yusufElnady/Medical-Imager/Documentation/UltrasoundMedicalImagerOverview.docx

Ultrasound Medical Imager

Final Dimensions: 10*14 cm²

3D Model

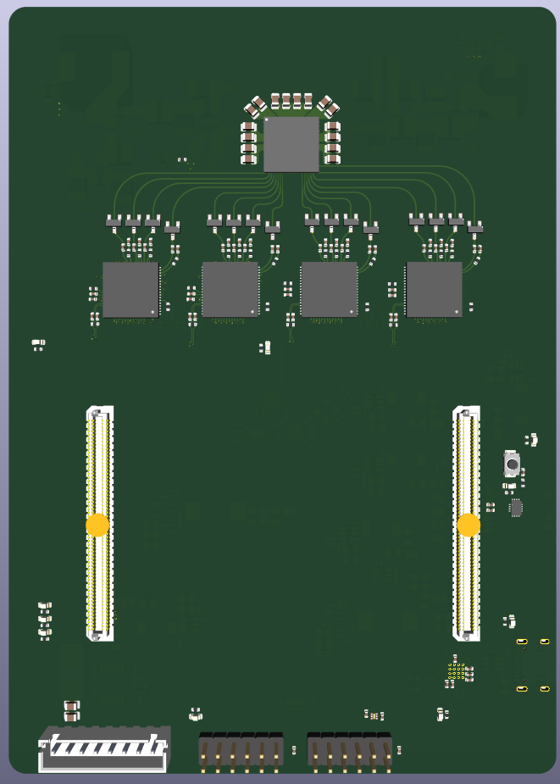
[picture p1: figure]

Figure 1: Top view of the PCB.

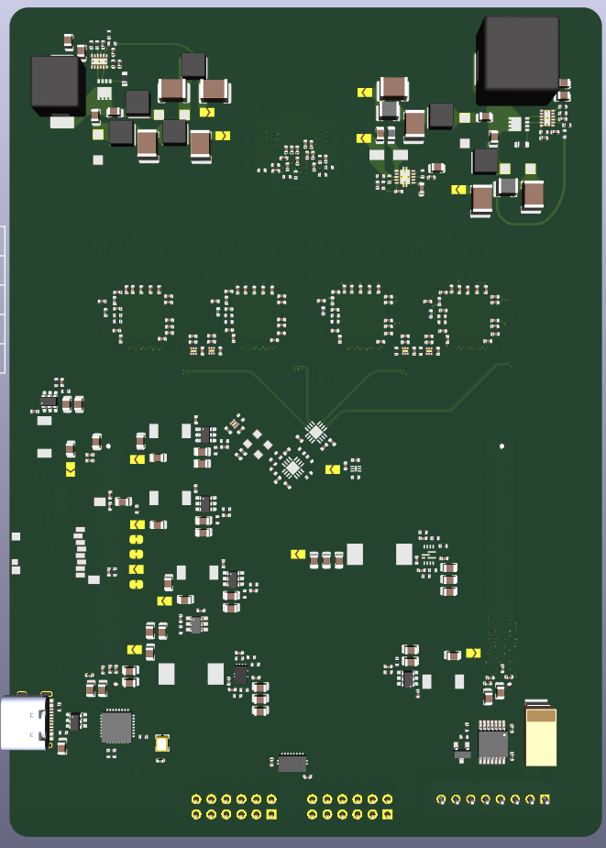
[picture p2: figure]

Figure 2: Bottom view of the PCB.
