yusufElnady/Medical-Imager/Documentation/PCBLayers.odt

Top 3D View

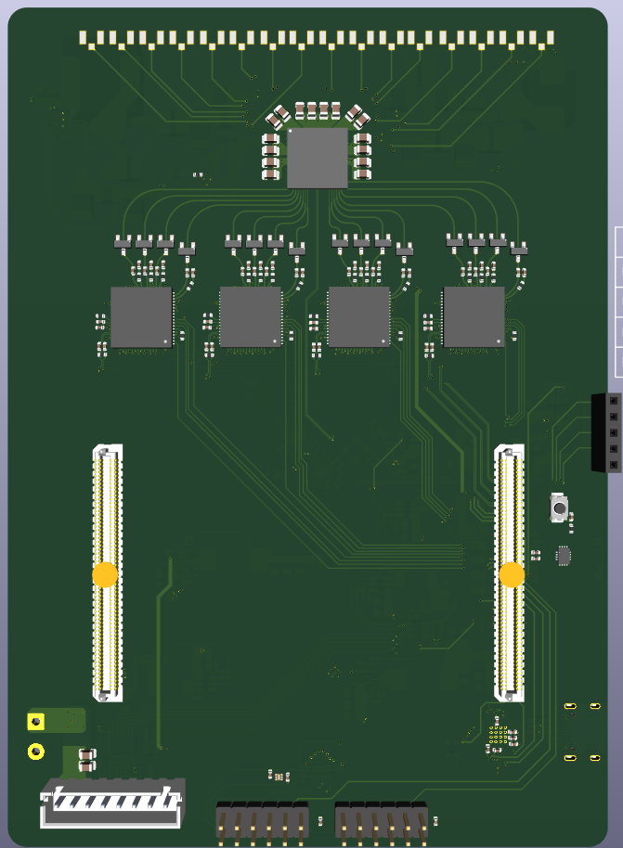
[picture p3: figure]

Bottom 3D View

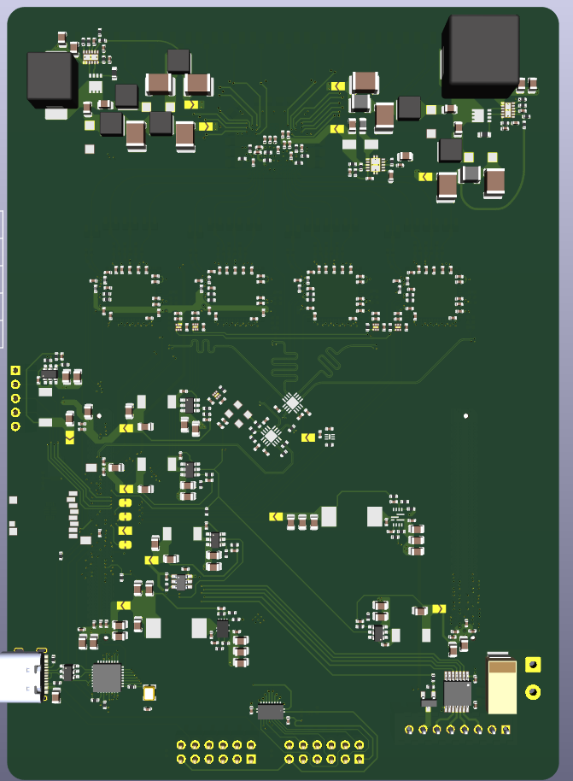
[picture p4: figure]

Layer 1: Signal

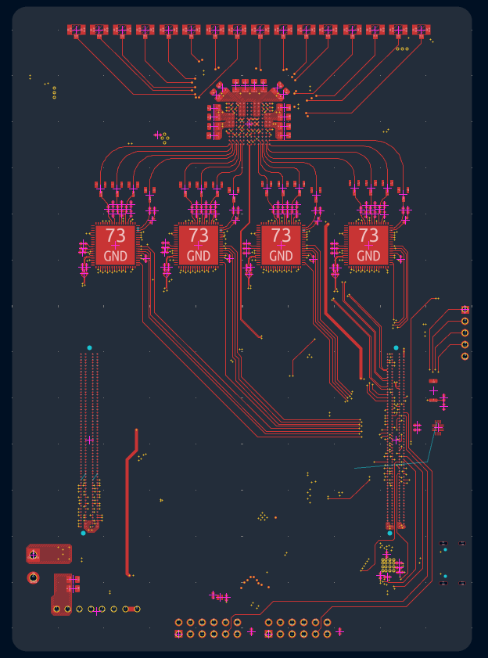
[picture p5: figure]

Layer 2: Ground

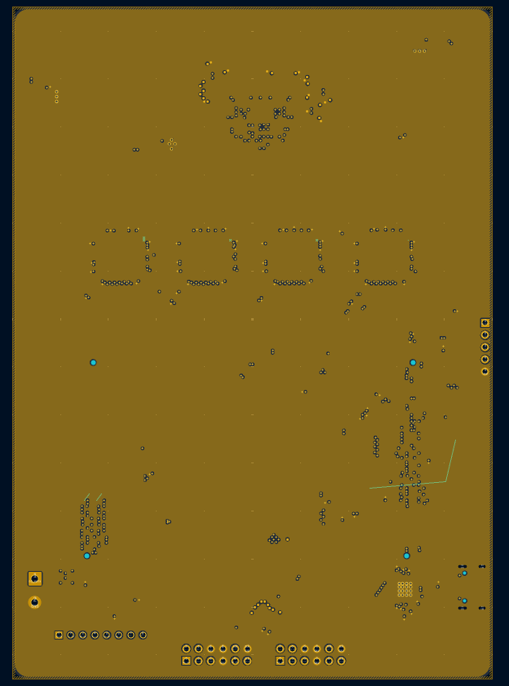
[picture p6: figure]

Layer 3: Signal/Power

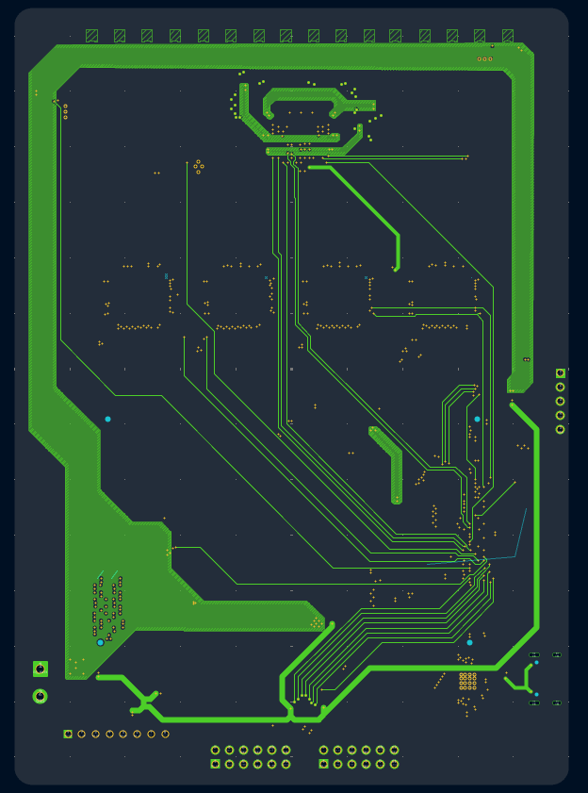
[picture p7: figure]

Layer 4: Signal/Power

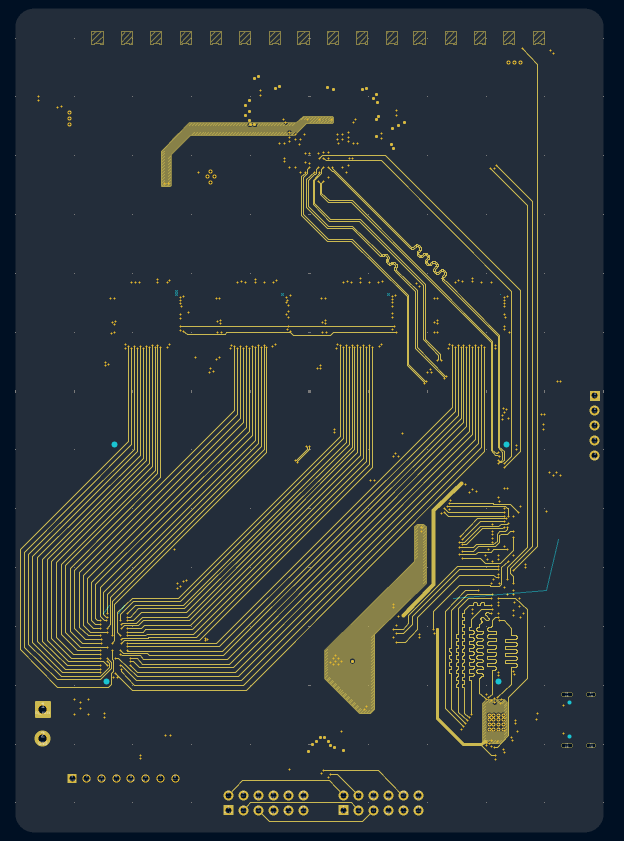
[picture p8: figure]

Layer 5: Ground

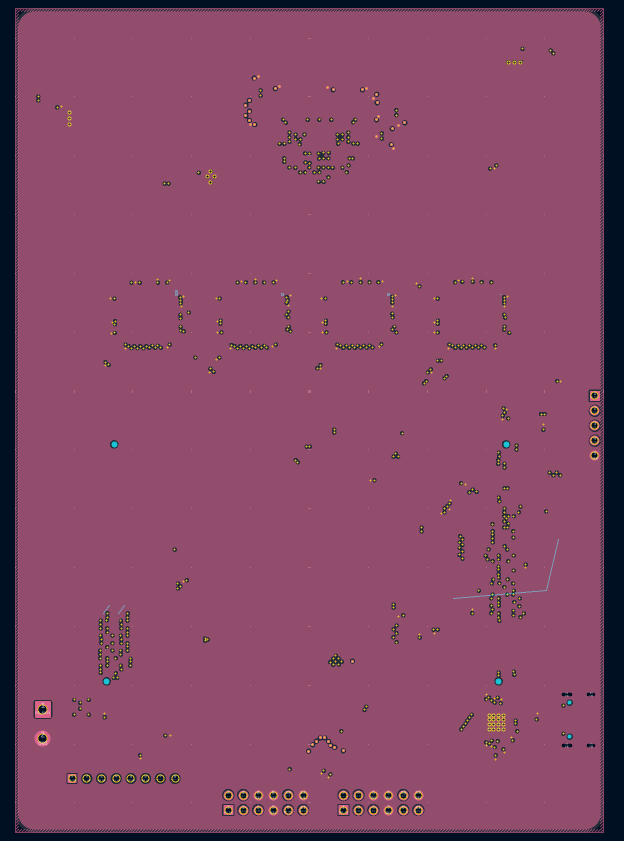
[picture p9: figure]

Layer 6: Signal

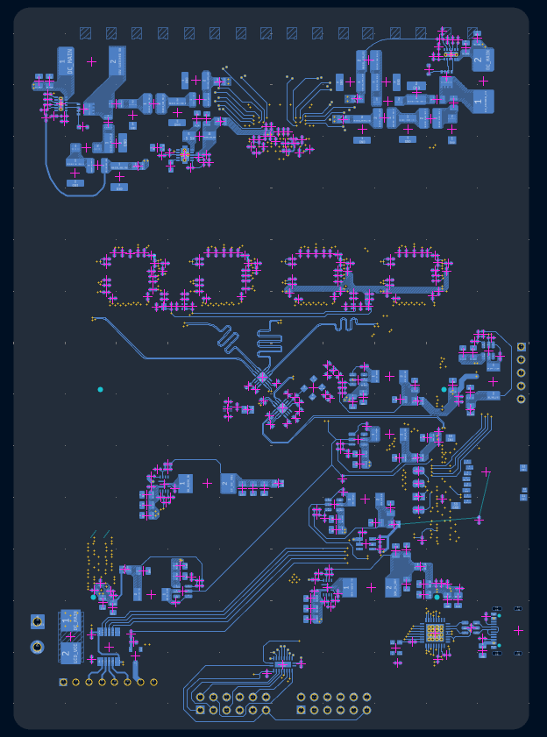
[picture p10: figure]
