yusufElnady/Medical-Imager/Documentation/BOM.csv

Reference | Value | Footprint | Description
C201,C202,C203 | 1nF | Capacitor_SMD:C_0402_1005Metric | 1nF 0402
C204,C205,C209,C210,C212,C213,C215,C216,C218,C219,C221,C222,C224,C225,C227,C228 | 100nF 200V | Capacitor_SMD:C_0805_2012Metric | 100nF 200V 0805
C206,C207,C208,C211,C214,C217,C220,C223,C226,C229,C302,C305,C314,C324,C327,C402,C501,C505,C510,C511,C512,C514,C515,C517,C518,C520,C521,C601,C602,C603,C604,C605,C606,C607,C608,C609,C610,C611,C612,C613,C614,C615,C616,C618,C619,C620,C621,C622,C623,C624,C625,C626,C627,C628,C701,C702,C703,C704,C705,C706,C707,C708,C709,C710,C711,C712,C713,C714,C715,C716,C718,C719,C720,C721,C722,C723,C724,C725,C726,C727,C728,C801,C802,C803,C804,C805,C806,C807,C808,C809,C810,C811,C812,C813,C814,C815,C816,C818,C819,C820,C821,C822,C823,C824,C825,C826,C827,C828,C901,C902,C903,C904,C905,C906,C907,C908,C909,C910,C911,C912,C913,C914,C915,C916,C918,C919,C920,C921,C922,C923,C924,C925,C926,C927,C928,C1004,C1007,C1008,C1009,C1010,C1012,C1017,C1018,C1019,C1020,C1103,C1303,C1403,C1503,C1603,C1703,C1803,C1904,C1906,C2004,C2006 | 100nF | Capacitor_SMD:C_0402_1005Metric | 100nF 0402,100nF 50v 0402
C301,C309,C323 | 10uF | Capacitor_SMD:C_0402_1005Metric | 10uF 0402
C303,C306,C310,C312,C315,C317,C319,C321,C407,C408,C409,C410,C411,C415,C416,C417,C419,C420,C421,C422,C502,C506,C617,C717,C817,C917,C1003,C1006,C1011,C1013,C1016,C1905,C2005 | 1uF | Capacitor_SMD:C_0402_1005Metric | 1uF 0402
C401,C412,C413,C1101,C1102,C1301,C1302,C1401,C1402,C1501,C1502,C1601,C1602,C1701,C1702,C1801,C1802 | 10uF | Capacitor_SMD:C_0805_2012Metric | 10uF 0805 50V,10uF >10v 0805
C403 | 220nF | Capacitor_SMD:C_0402_1005Metric | 220nF 0402
C404 | 4.7nF | Capacitor_SMD:C_0603_1608Metric | 4.7nF 50v 0805
C405 | 10pF | Capacitor_SMD:C_0402_1005Metric | 10pF 0402
C406 | 22uF | Capacitor_SMD:C_0805_2012Metric | 22uF >10v 0805
C503,C504,C507,C508,C1001,C1005,C1907,C1908,C1910,C2007,C2008,C2010 | 47uF | Capacitor_SMD:C_0805_2012Metric | 47uF 0805 10V
C509,C513,C516,C519,C1901,C1902,C1903,C2001,C2002,C2003 | 4.7uF | Capacitor_SMD:C_0805_2012Metric | 4.7uF 0805 >50V
C1002 | 100nF | Capacitor_SMD:C_0805_2012Metric | 100nF 0402
C1014,C1015 | 4.7uF | Capacitor_SMD:C_0402_1005Metric | 4.7uF 0402
C1104,C1504,C1804 | 56pF | Capacitor_SMD:C_0402_1005Metric | 56pF 0402
C1105,C1305,C1306,C1505,C1705,C1706,C1805 | 100uF | Capacitor_SMD:C_0805_2012Metric | 100uF 0805 6.3V
C1304,C1704 | 47pF | Capacitor_SMD:C_0402_1005Metric | 47pF 0402
C1404,C1605 | 47nF | Capacitor_SMD:C_0402_1005Metric | 47nF 0402
C1405 | 300nF | Capacitor_SMD:C_0402_1005Metric | 300nF 0402
C1406 | 2.2uF 100V | Capacitor_SMD:C_0805_2012Metric | 2.2uF 0805 100V
C1407 | 2.2uF 100v | Capacitor_SMD:C_0805_2012Metric | 2.2uF 0805 250V
C1408,C1409,C1410,C1411,C1608,C1609,C1610,C1611 | 1uF 250V | Capacitor_SMD:C_1812_4532Metric | 1uF 250V 1812 - NC1812B105K251CEMN
C1604 | 8.2nF | Capacitor_SMD:C_0402_1005Metric | 8.2nF 0402
C1606,C1607 | 3.3uF | Capacitor_SMD:C_2220_5750Metric | 3.3uF 2220 250V
C1909,C2009 | 22pF | Capacitor_SMD:C_0402_1005Metric | 22pF 0402
D401,D402,D403,D404,D405,D406,D407,D409,D410,D411 | LED | LED_SMD:LED_0603_1608Metric | Light emitting diode
D408 | B240A-13-F | digikey-footprints:DO-214AC | DIODE SCHOTTKY 40V 2A SMA
D601,D602,D603,D604,D701,D702,D703,D704,D801,D802,D803,D804,D901,D902,D903,D904 | MMBD4148SE | MMBD4148SE:SOT95P237X112-3N | SOT-23, 100V, 0.2A, Switching Diode
D1401,D1402,D1601,D1602 | S5MB | S5MB:DIOM4336X265N | 5A, 1000V, Standard Rectifier
F401 | 0154007.DRT | 0154007.DRT:FUSE_0154007.DRT | 7 A 72 V AC 60 V DC Fuse Board Mount (Cartridge Style Excluded) Requires Holder, Surface Mount 2-SMD, Square End Block with Holder
F1001 | 0154.500DRT | 0154-500DRT:0154Series_LTF
FB401,FB402,FB403,FB404,FB405,FB406,FB407,FB408 | BLM15AG601SN1D | Inductor_SMD:L_0402_1005Metric | BLM15AG601SN1D 0402
J201,J202,J203,J204,J205,J206,J207,J208,J209,J210,J211,J212,J213,J214,J215,J216 | U.FL-R-SMT-1_80_ | U.FL-R-SMT-1_80_:HIROSE_U.FL-R-SMT-1_80_ | U.FL (UMCC) Connector Receptacle, Male Pin 50 Ohms Surface Mount Solder
J401 | Input Power | TerminalBlock:TerminalBlock_MaiXu_MX126-5.0-02P_1x02_P5.00mm | Generic screw terminal, single row, 01x02, script generated (kicad-library-utils/schlib/autogen/connector/)
J501,J502 | REF-226081-01 | REF-226081-01:SAMTEC_REF-226081-01 | CUSTOM PART OF ADM6-60-01.5-L-4-2-A-TR
J503 | JTAG Header | Connector_PinSocket_2.54mm:PinSocket_1x05_P2.54mm_Vertical | Generic connector, single row, 01x05, script generated
J1001 | TYPE-C-31-M-12 | TYPE-C-31-M-12:HRO_TYPE-C-31-M-12 | USB Connectors 24 Receptacle 1 8.94*7.3mm RoHS
J1002 | B8B-XH-A | B8B-XH-A:JST_B8B-XH-A | Connector Header Through Hole 8 position 0.098 (2.50mm)
J1003 | External Board 1 | Connector_PinHeader_2.54mm:PinHeader_2x06_P2.54mm_Vertical | Generic connector, double row, 02x06, counter clockwise pin numbering scheme (similar to DIP package numbering), script generated (kicad-library-utils/schlib/autogen/connector/)
J1004 | External Board 2 | Connector_PinHeader_2.54mm:PinHeader_2x06_P2.54mm_Vertical | Generic connector, double row, 02x06, counter clockwise pin numbering scheme (similar to DIP package numbering), script generated (kicad-library-utils/schlib/autogen/connector/)
J1005 | 47352-1001 | 47352-1001:MOLEX_47352-1001 | 8 (6 + 2) Position Card Connector Secure Digital - microSD™ Surface Mount, Right Angle Gold
J1006 | LCD AUX UART HEADER | Connector_PinSocket_2.54mm:PinSocket_1x03_P2.54mm_Vertical | Generic connector, single row, 01x03, script generated
L401 | 4.7uH | Inductor_SMD:L_0805_2012Metric | 4.7uH 0805 (MLZ2012N4R7LT000)
L1101,L1501,L1801 | 6.8uH | Inductor_SMD:L_6.3x6.3_H3 | 6.8uH 6.4*6.3mm - APH0660C-6R8M-TCD5
L1301,L1701 | 4.7uH | Inductor_SMD:L_6.3x6.3_H3 | 4.7uH 6*6mm - HPC6045NF-4R7MTH
L1401 | 150uH | Inductor_SMD:L_SXN_SMDRI127 | 150uH - PSPMAA1265H-151M-IGP
L1402,L1403 | 150uH | Inductor_SMD:L_Cenker_CKCS4018 | 150uH 3.5*3mm - CMLF0302-151MTT
L1404,L1405 | 68uH | Inductor_SMD:L_1210_3225Metric | 68uH 1210 - BCL322520RT-680M-D
L1601 | 68uH | Inductor_SMD:L_Panasonic_PCC-M0854M | 68uH - SMMS0865-680MT
L1602,L1603,L1604,L1605 | 68uH | Inductor_SMD:L_Cenker_CKCS4018 | 68uH - CMLF0302-680MTT
L1901,L2001 | 1uH | Inductor_SMD:L_10.4x10.4_H4.8 | 1uH 11*10mm - POHS1004-1R0M
Q1001 | SI2302DS | SI2302DS:SOT23-3_TO-236AB | N-Channel 20V 2.5A (Tc) 830mW (Tc) Surface Mount TO-236AB (SOT23)
Q1401,Q1601 | FDMC86240 | FDMC86240:FDMC86139P | Max rDS(on) = 51 m at VGS = 10 V, ID = 4.6 A | Low Profile - 1 mm max in Power 33 | Shielded Gate MOSFET Technology | RoHS Compliant | 100% UIL Tested | Max rDS(on) = 70 m at VGS = 6 V, ID = 3.9 A
R201,R203,R204,R206,R207,R402,R416,R417,R418,R419,R420,R421,R501,R601,R602,R604,R701,R702,R704,R801,R802,R804,R901,R902,R904,R1003,R1005 | 10K | Resistor_SMD:R_0402_1005Metric | 10K 0402
R301,R302,R605,R705,R805,R905,R1004,R1406,R1606,R1902,R2002 | 1K | Resistor_SMD:R_0402_1005Metric | 1K 0402
R303,R1006,R1008 | 50R | Resistor_SMD:R_0402_1005Metric | 50R 0402
R304,R305,R306,R603,R703,R803,R903 | 100R | Resistor_SMD:R_0402_1005Metric | 100R 0402
R401 | 1K | Resistor_SMD:R_0402_1005Metric | 1K 0402
R403,R405 | 0.5K | Resistor_SMD:R_0402_1005Metric | 0.5K 0402
R404 | 10R | Resistor_SMD:R_0402_1005Metric | 10R 0402
R406,R407,R408,R409 | 330R | Resistor_SMD:R_0402_1005Metric | 330R 0402
R410 | 150K | Resistor_SMD:R_0402_1005Metric | 150K 0402
R411 | 619K | Resistor_SMD:R_0402_1005Metric | 619K 0402
R412,R414,R415 | 220R | Resistor_SMD:R_0402_1005Metric | 220R 0402
R413,R1007,R1101,R1301,R1401,R1501,R1601,R1605,R1701,R1801,R1903,R2003 | 100K | Resistor_SMD:R_0402_1005Metric | 100K 0402
R606,R607,R608,R609,R706,R707,R708,R709,R806,R807,R808,R809,R906,R907,R908,R909 | 8R | Resistor_SMD:R_0402_1005Metric | 8R 0402
R1001,R1002 | 5.1K | Resistor_SMD:R_0402_1005Metric | 5.1K 0402
R1102,R1502,R1802 | 22K | Resistor_SMD:R_0402_1005Metric | 22K 0402
R1302,R1405,R1702 | 49.9K | Resistor_SMD:R_0402_1005Metric | 49.9K 0402
R1402,R1602 | 150k | Resistor_SMD:R_0402_1005Metric | 150k 0402
R1403 | 570R | Resistor_SMD:R_0402_1005Metric | 570R 0402
R1404,R1604 | 10mOhm | Resistor_SMD:R_0603_1608Metric | 10mOhm 0603
R1603 | 3.3k | Resistor_SMD:R_0402_1005Metric | 3.3k 0402
R1901,R2001 | 4K | Resistor_SMD:R_0402_1005Metric | 4K 0402
R1904,R2004 | 147K | Resistor_SMD:R_0402_1005Metric | 147K 0402
R1905,R2005 | 20K | Resistor_SMD:R_0402_1005Metric | 20K 0402
SW501 | RESET | Button_Switch_SMD:SW_Push_SPST_NO_Alps_SKRK | Push button switch, generic, two pins
U201 |  | TX7516:BGA-144_10.0x10.0mm_Layout12x12_P0.8mm_TI-ALH0144A
U301,U302 | LMK1D1204RGTR | LMK1D1204RGTR:VQFN16_RGT_TEX
U401 | TPS63700DRCR | TPS63700DRCR:VREG_V62_16624-01YE
U402,U404,U406 | NCP176BMX180TCG | NCP176BMX180TCG:PSON40P120X120X45-7N_NCP176BMX180TCG | Linear Voltage Regulator IC Positive Fixed 1 Output 500mA 6-XDFN (1.2x1.2)
U403,U405,U408 | NCP176AMX330TCG | NCP176AMX330TCG:PSON40P120X120X45-7N_NCP176AMX330TCG | Linear Voltage Regulator IC Positive Fixed 1 Output 500mA 6-XDFN (1.2x1.2)
U407 | MIC5363-3.3YMT-TR | MIC5363-3-3YMT-TR:TMLF-6_MT_MCH
U410 | TPS22918TDBVRQ1 | TPS22918TDBVRQ1:SOT95P280X145-6N | 1-ch, 5.5-V, 2-A, 52-mΩ automotive load switch with adj. rise time and adj. output discharg
U601,U701,U801,U901 | AD8285WBCPZ | AD8285WBCPZ:CP_72_5_ADI
U1001 | NXB0108BQ-Q100X | NXB0108BQ-Q100X:DHVQFN20_SOT764-1_NEX
U1002 | USBLC6-2SC6 | Package_TO_SOT_SMD:SOT-23-6 | Very low capacitance ESD protection diode, 2 data-line, SOT-23-6
U1003 | TUSB1210BRHBR | TUSB1210BRHBR:RHB32_3P45X3P45
U1004 | NXB0104PWJ | NXB0104PWJ:SOP65P640X120-14N | Voltage Level Translator Bidirectional 1 Circuit 4 Channel 100Mbps 14-TSSOP
U1005 | NVT4858HKZ | NVT4858HKZ:NVT4858_NXP
U1101,U1301,U1501,U1701,U1801 | TPS54302 | Package_TO_SOT_SMD:SOT-23-6 | 3A, 4.5 to 28V Input, EMI Friendly integrated switch synchronous step-down regulator, pulse-skipping, SOT-23-6
U1401,U1601 | LM5155DSSR | LM5155DSSR:IC_LM5155DSSR | 2.2-MHz wide VIN, 1.5-A MOSFET driver, non-synchronous boost controller
U1901,U2001 | TPS51385RJNR | TPS51385RJNR:VQFN-HR12_RJN_TEX
Y301 | ASFLMB-72.000MHZ-LY-T | ASFLMB-72.000MHZ-LY-T:XTAL_ASFLMB-72.000MHZ-LY-T | 72 MHz XO (Standard) LVCMOS Oscillator 1.8V ~ 3.3V Standby (Power Down) 4-SMD, No Lead
Y1002 | ASEMB-26.000MHZ-LY-T | ASEMB-26.000MHZ-LY-T:XTAL_ASEMB-26.000MHZ-LY-T | 26 MHz XO (Standard) CMOS Oscillator 1.8V ~ 3.3V Standby (Power Down) 4-SMD, No Lead
