yusufElnady/Medical-Imager/Documentation/Overview2.pdf

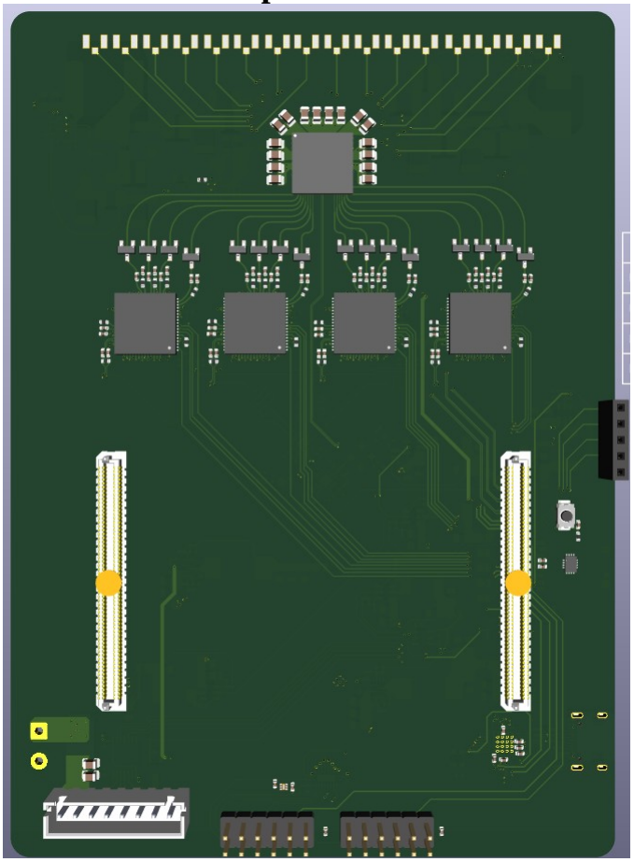
[picture p11: figure]

Top 3D View

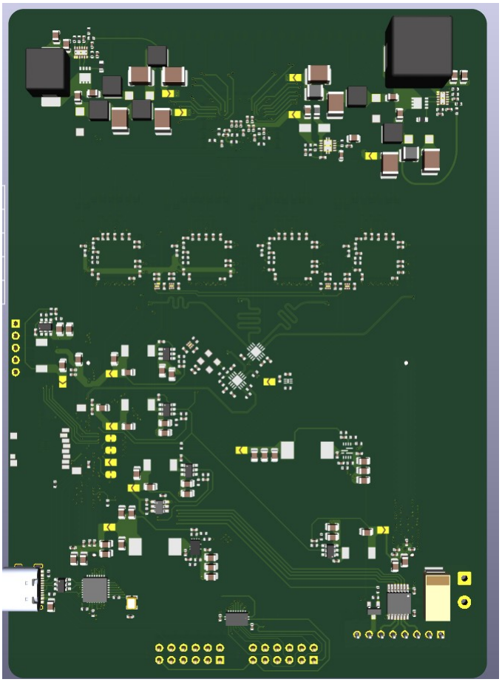
[picture p12: figure]

Bottom 3D View

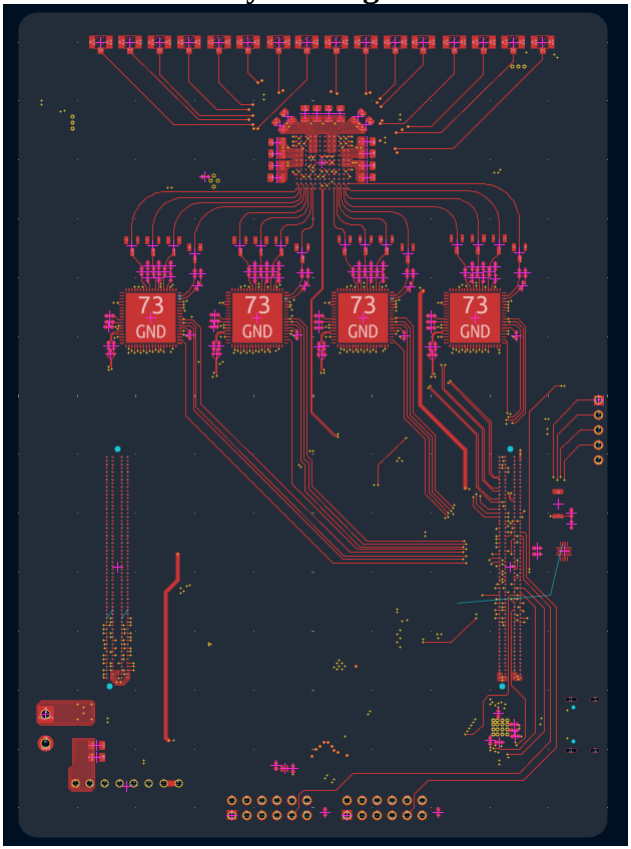
[picture p13: figure]

Layer 1: Signal

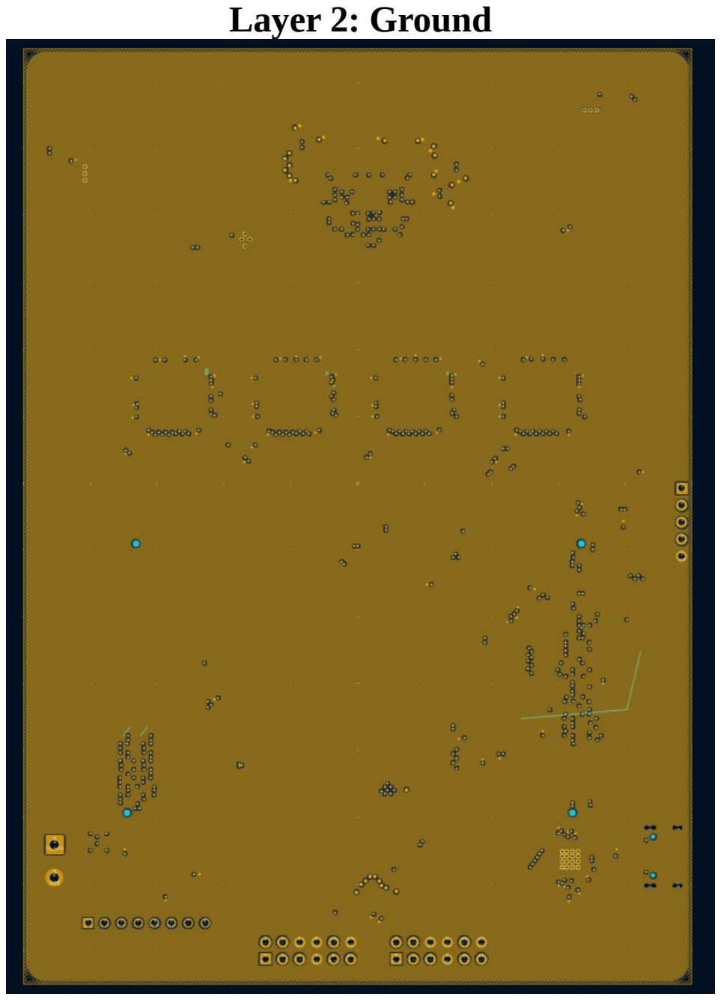
[picture p14: page 4]

Layer 2: Ground

Layer 3: Signal/Power

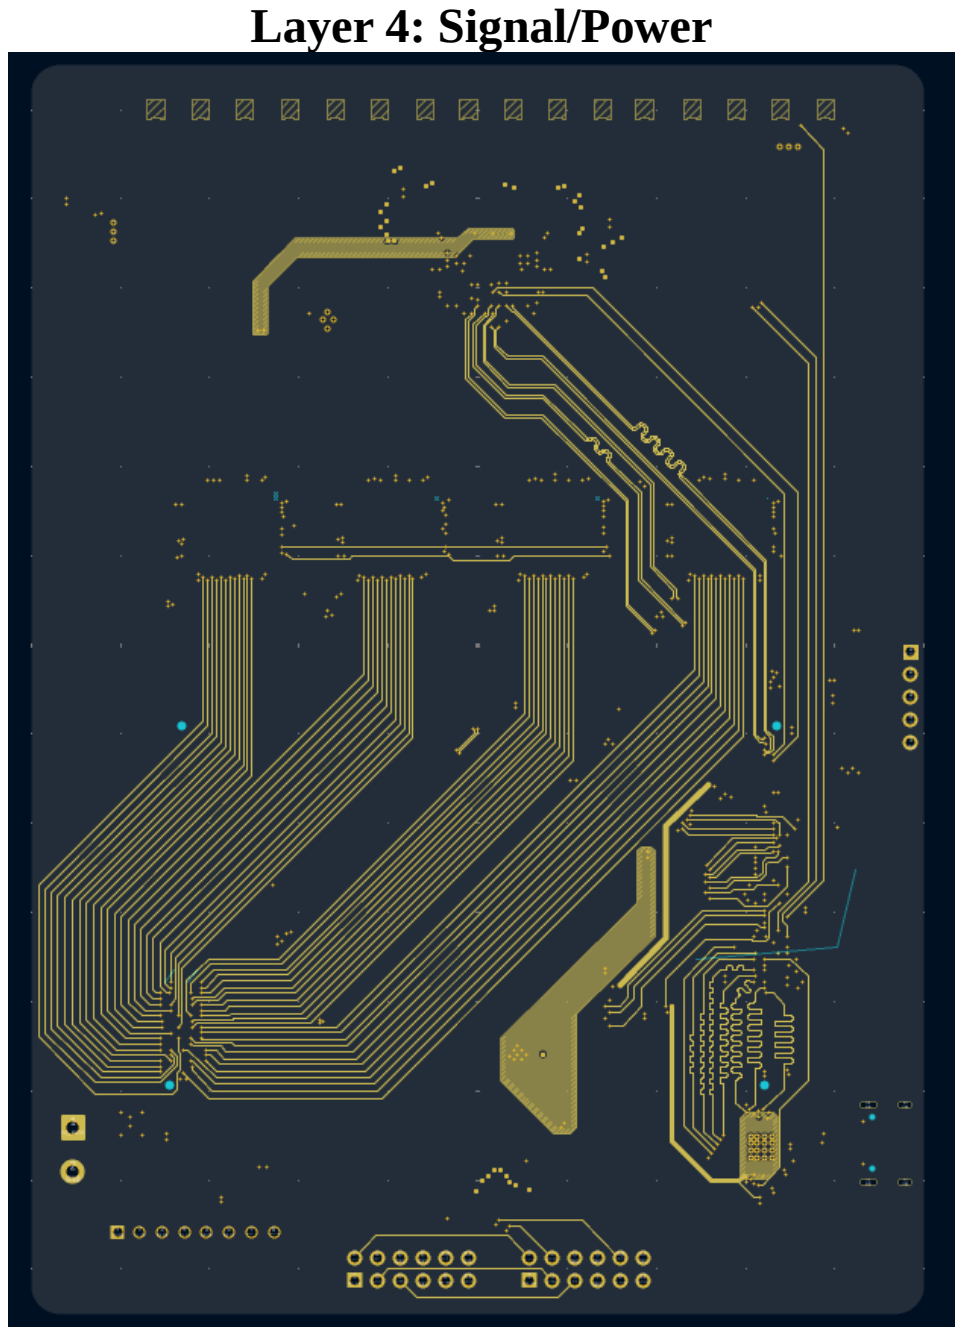
[picture p15: page 7]

Layer 4: Signal/Power

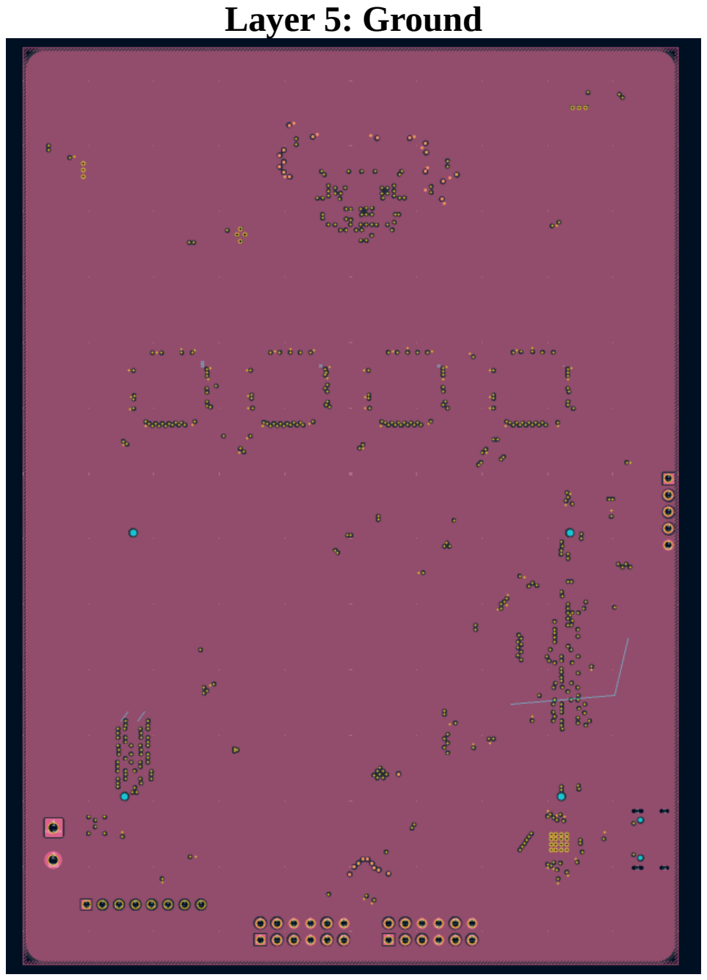
[picture p16: page 8]

Layer 5: Ground

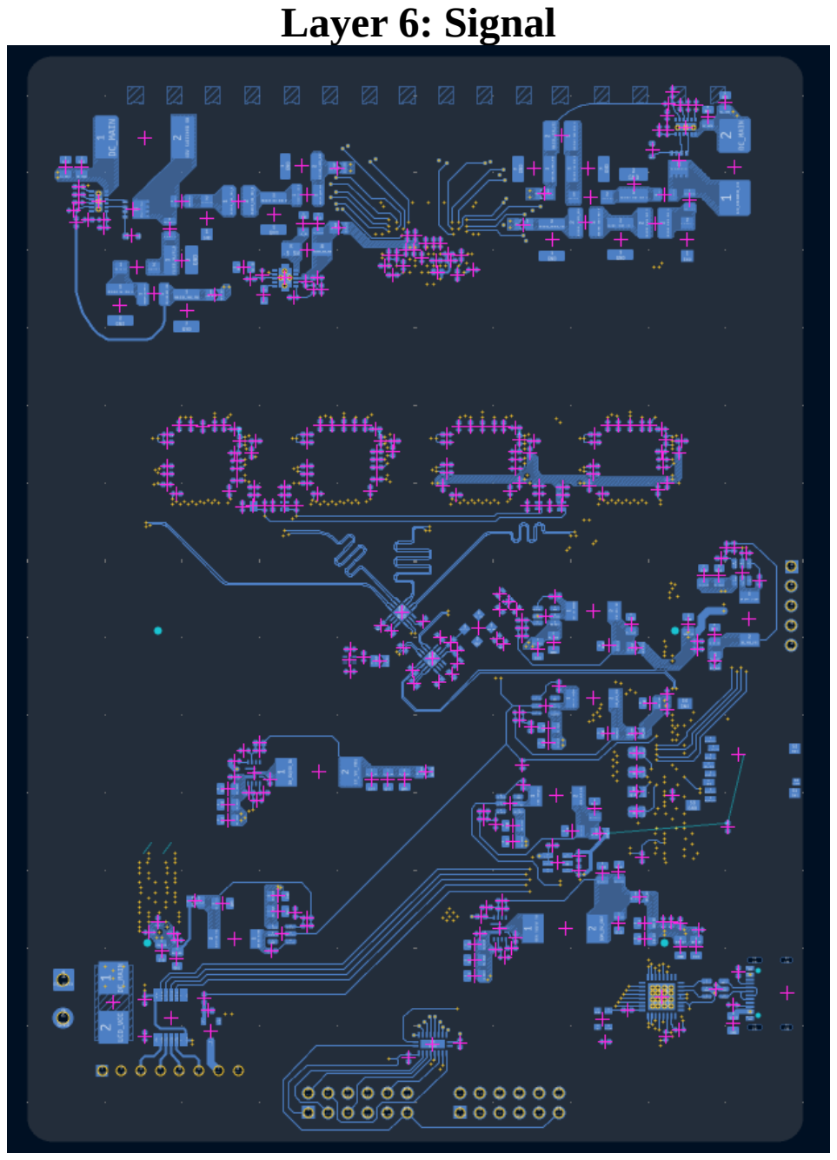
[picture p17: page 9]

Layer 6: Signal

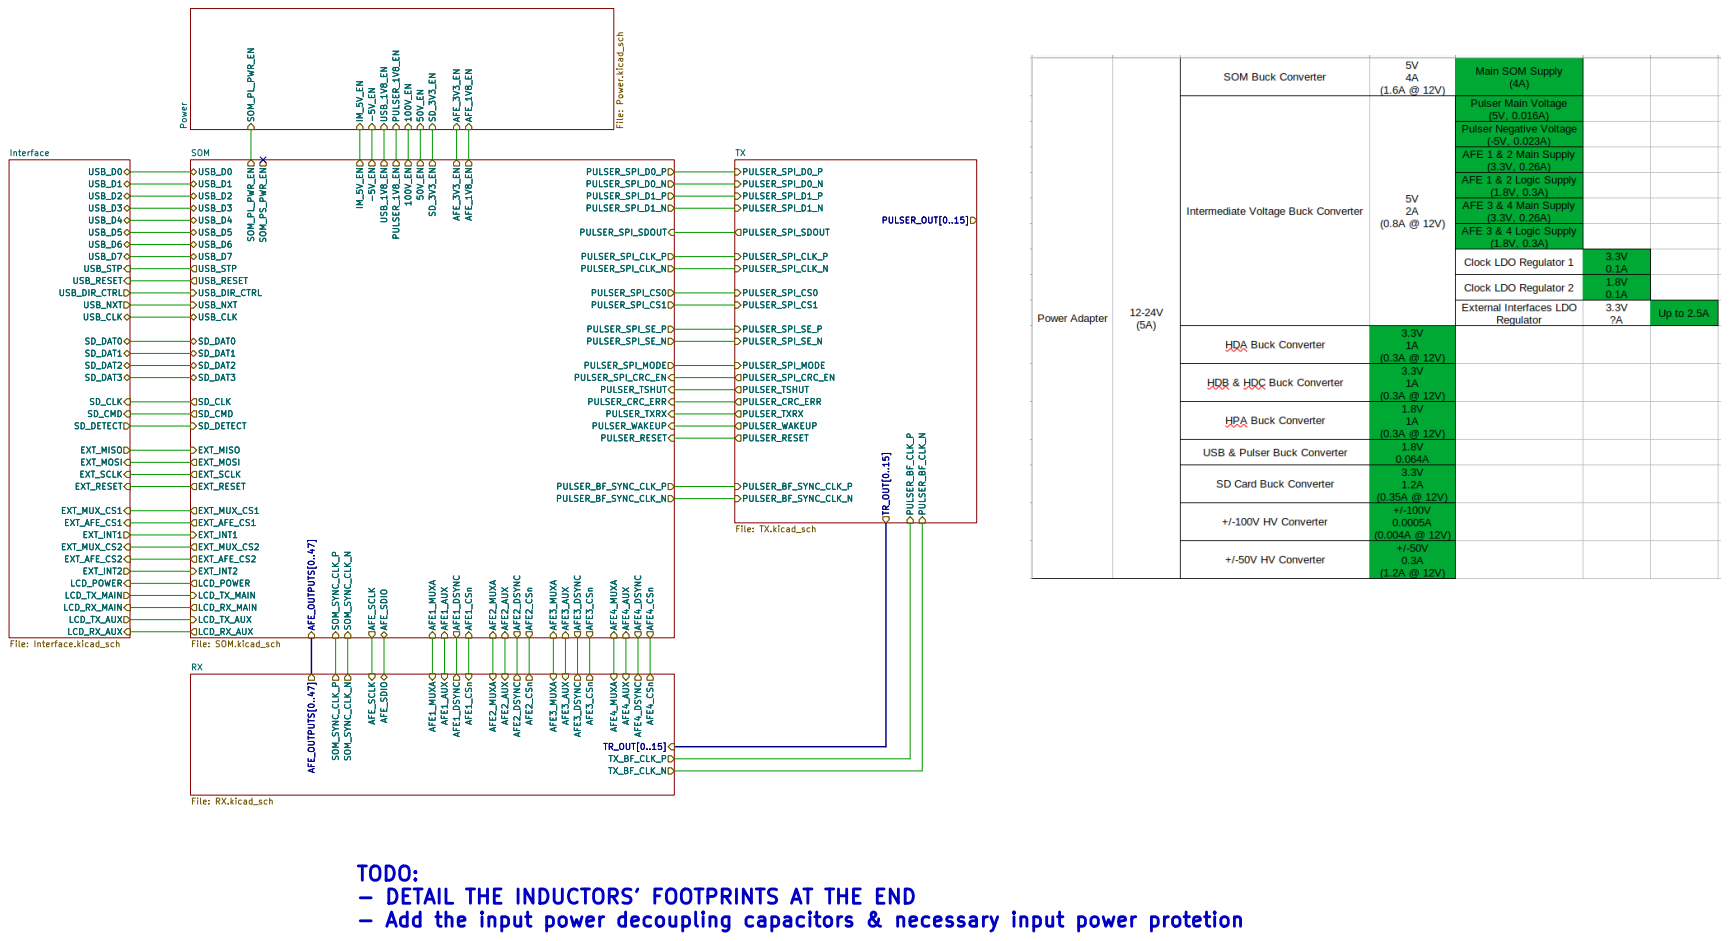
[picture p18: page 10]

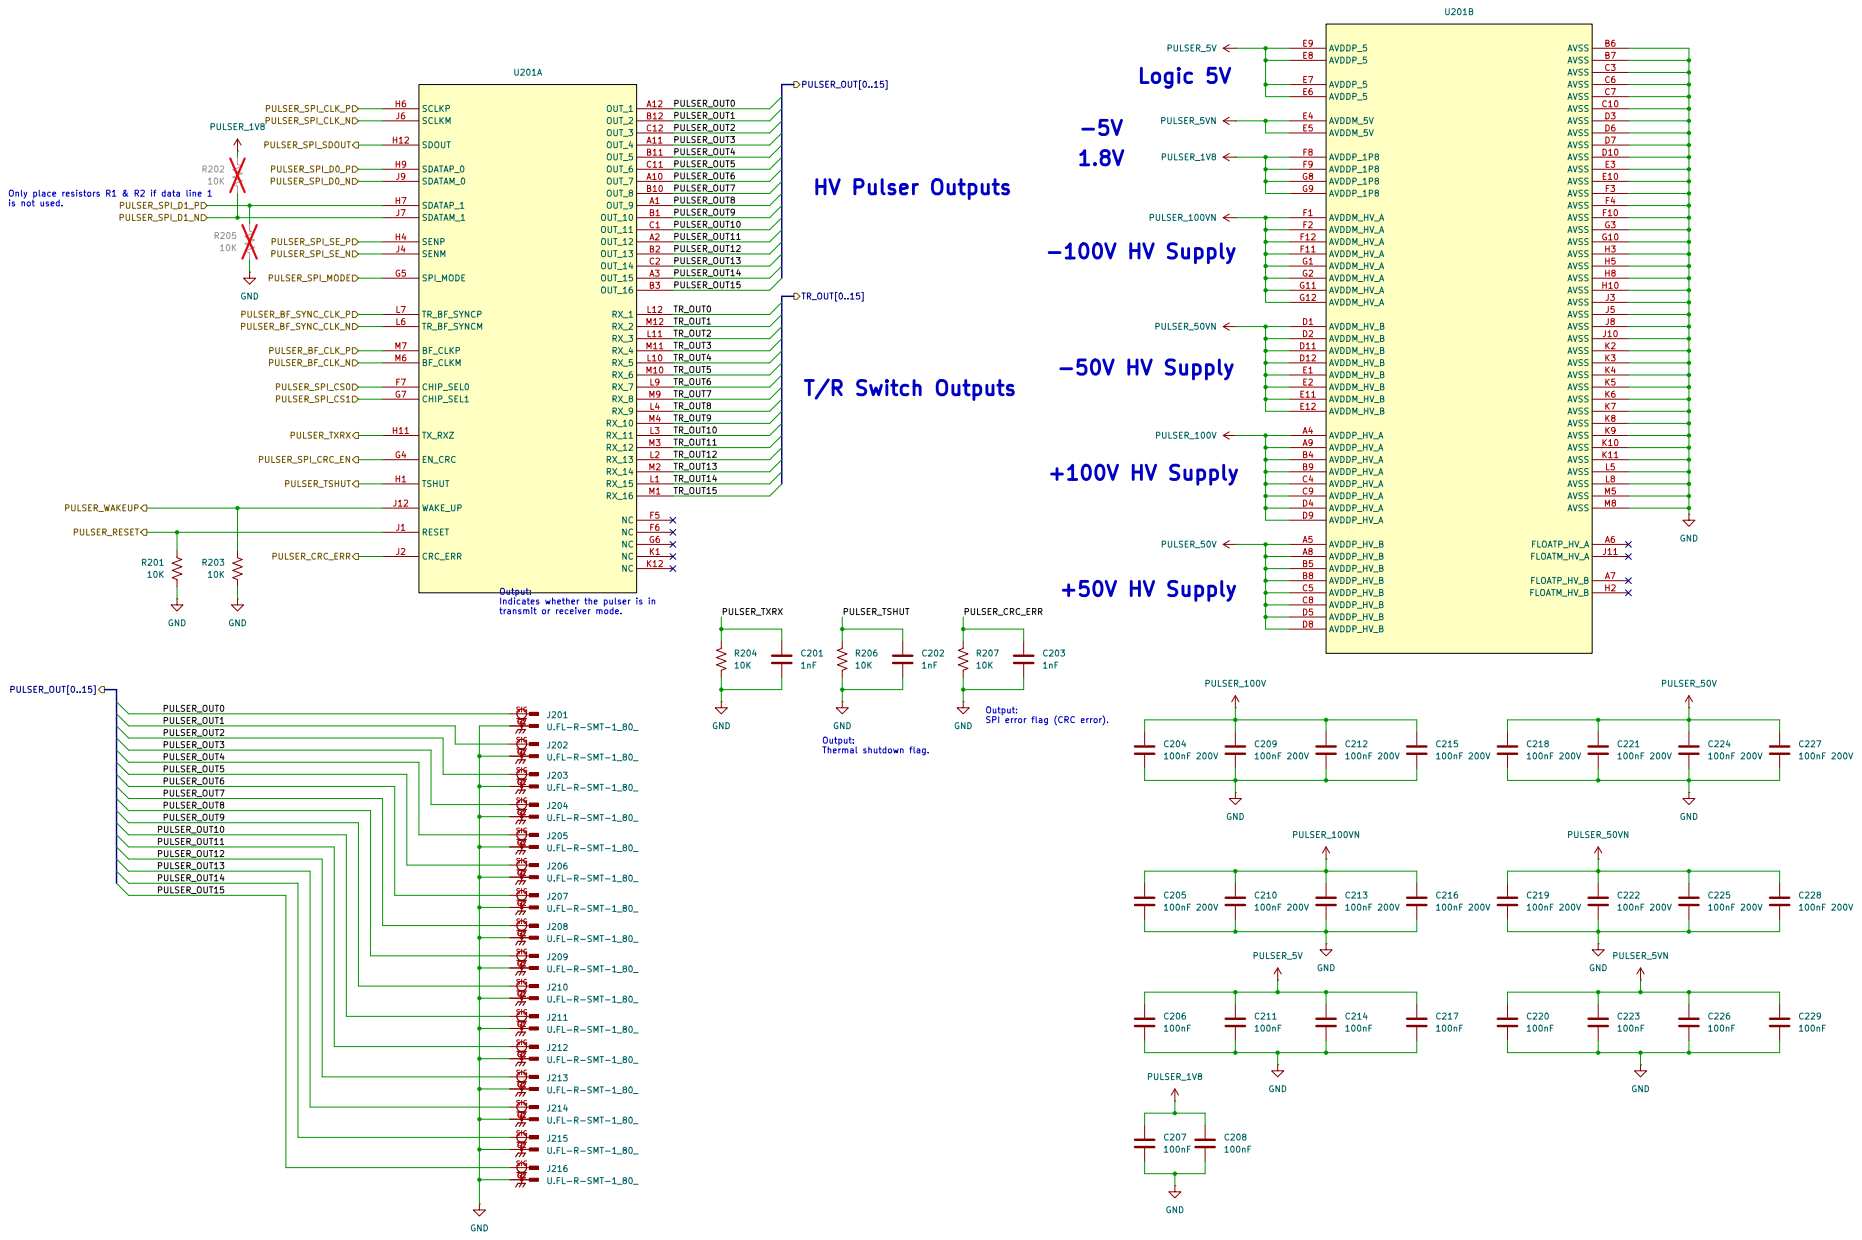
[picture p19: page 11]

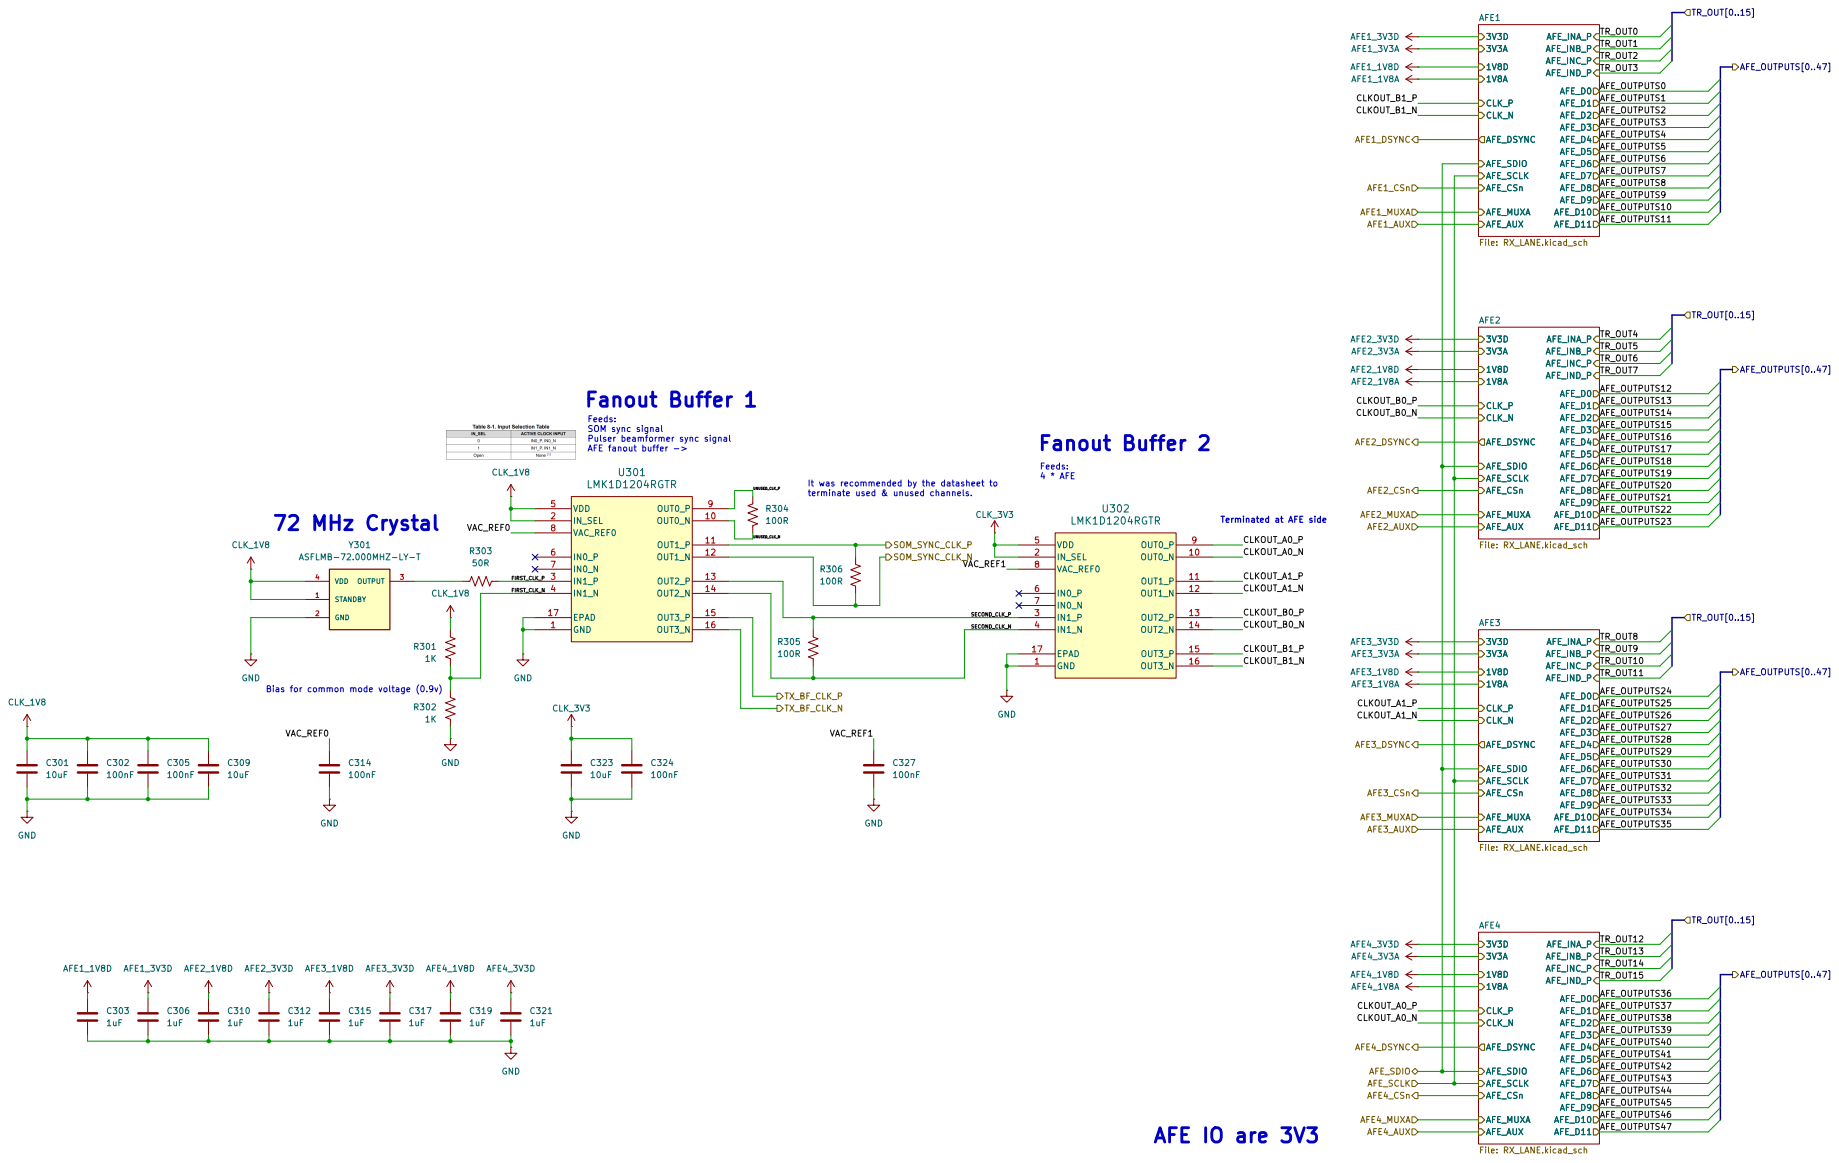
[picture p20: page 12]

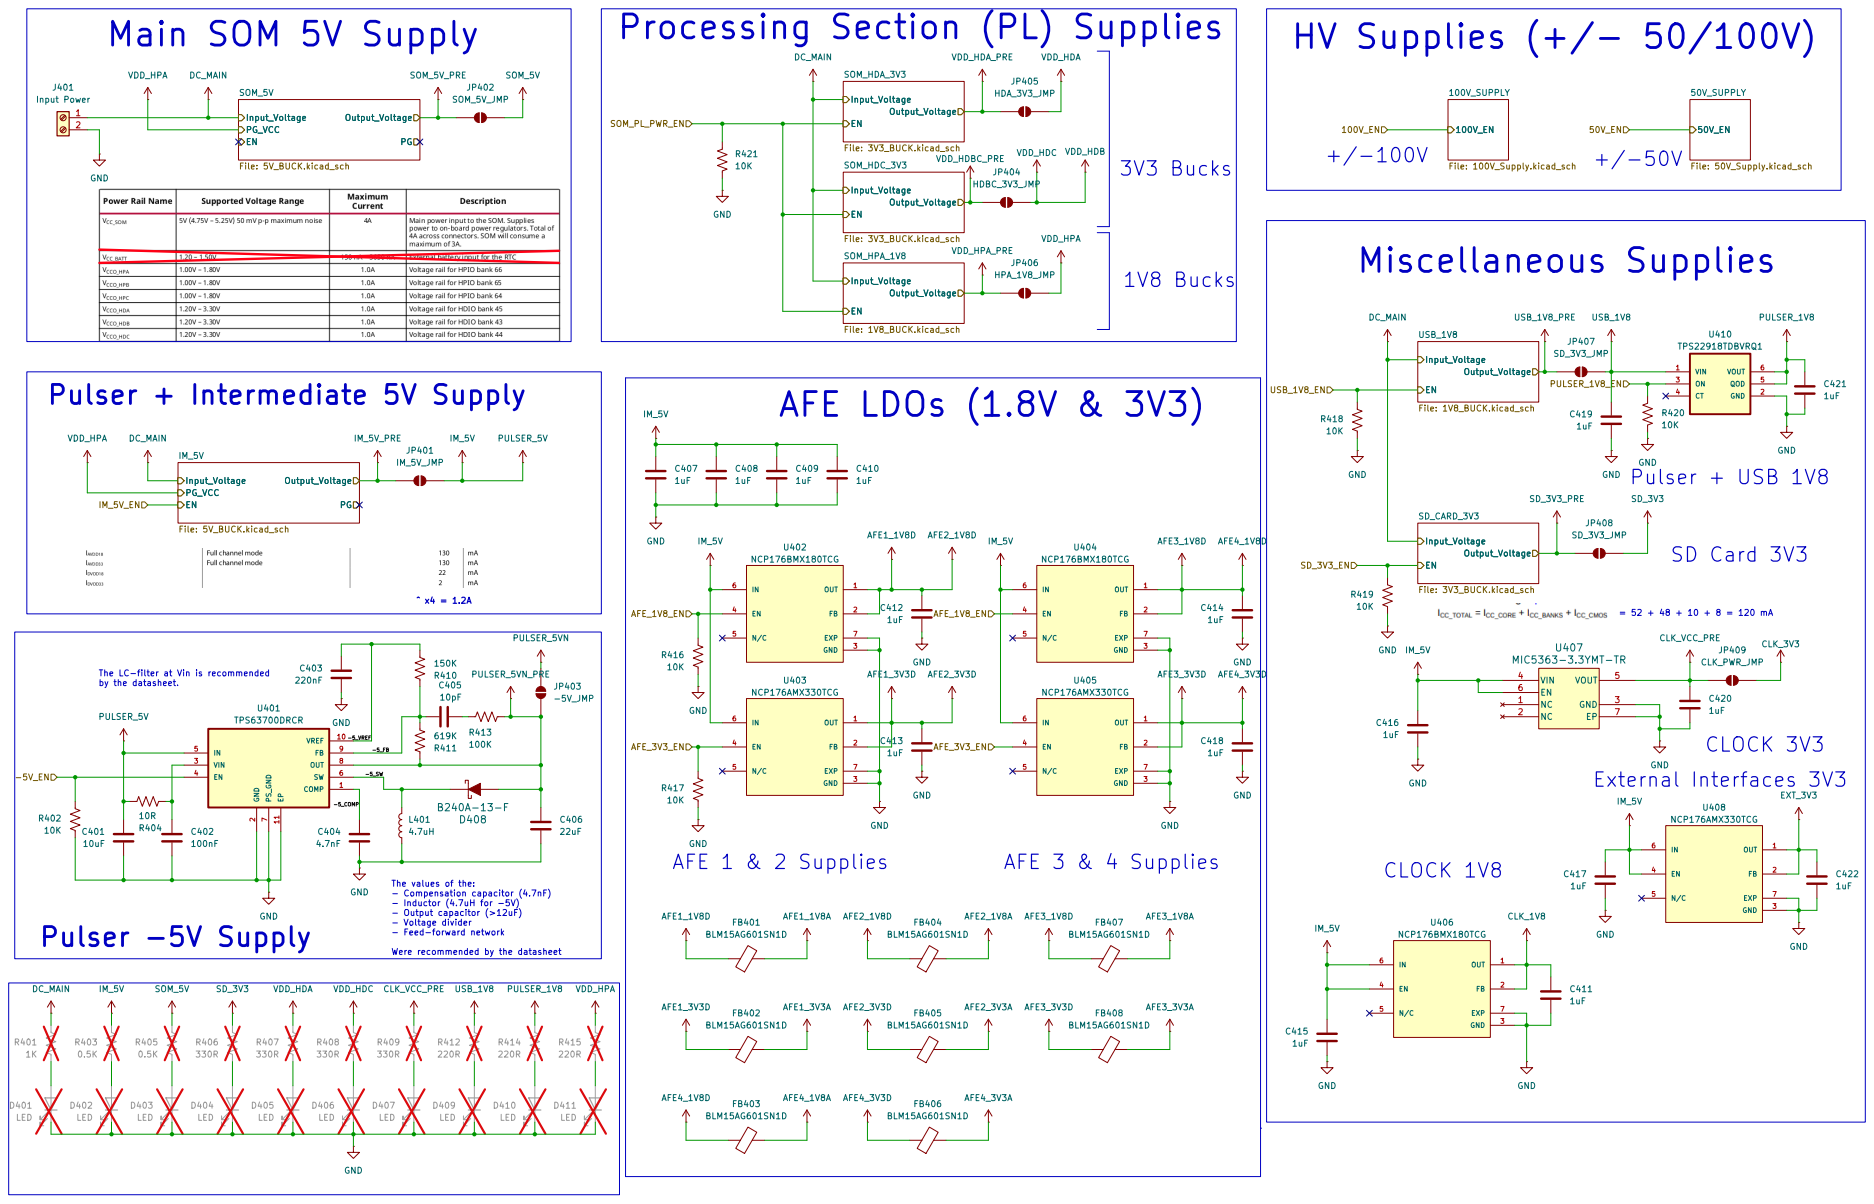
[picture p21: page 13]

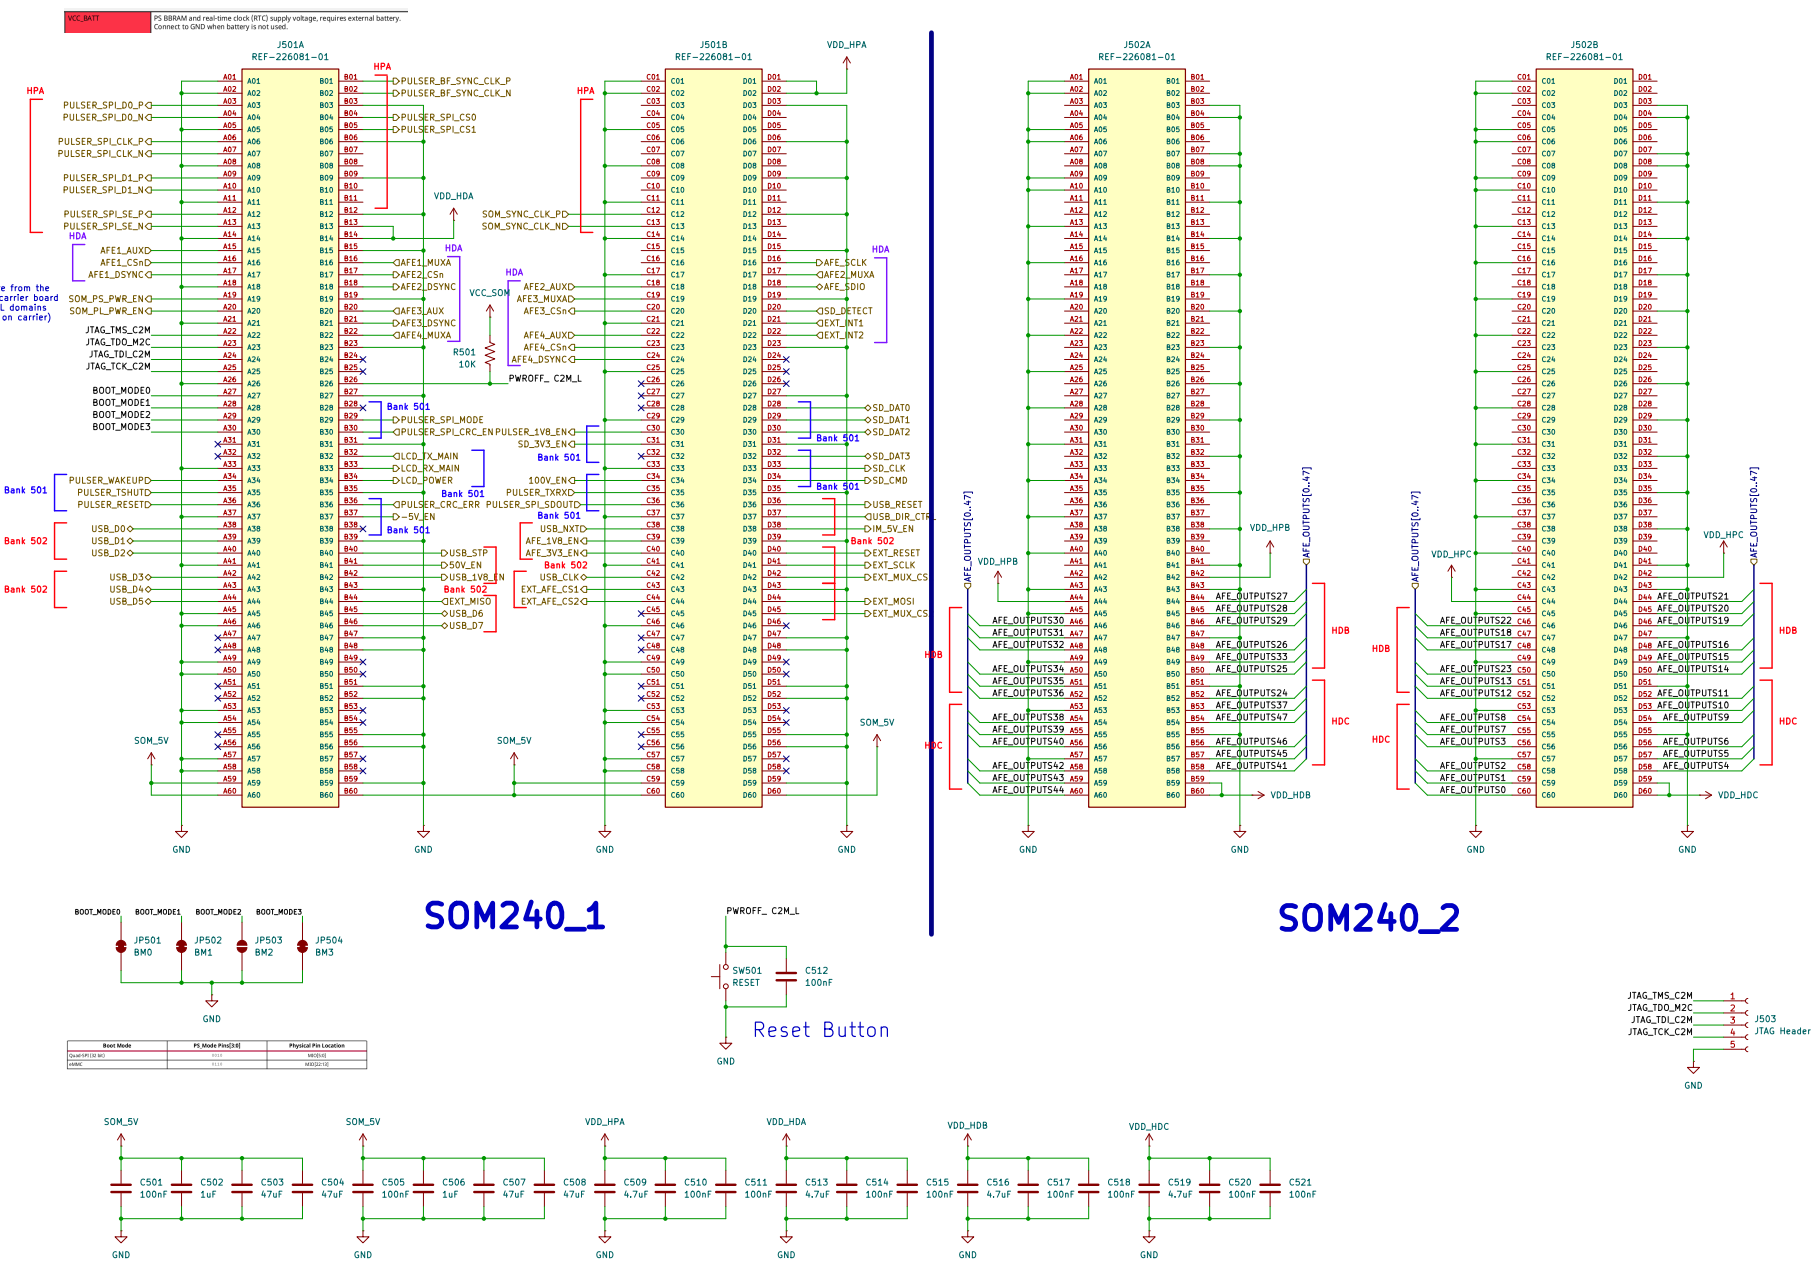
[picture p22: page 14]

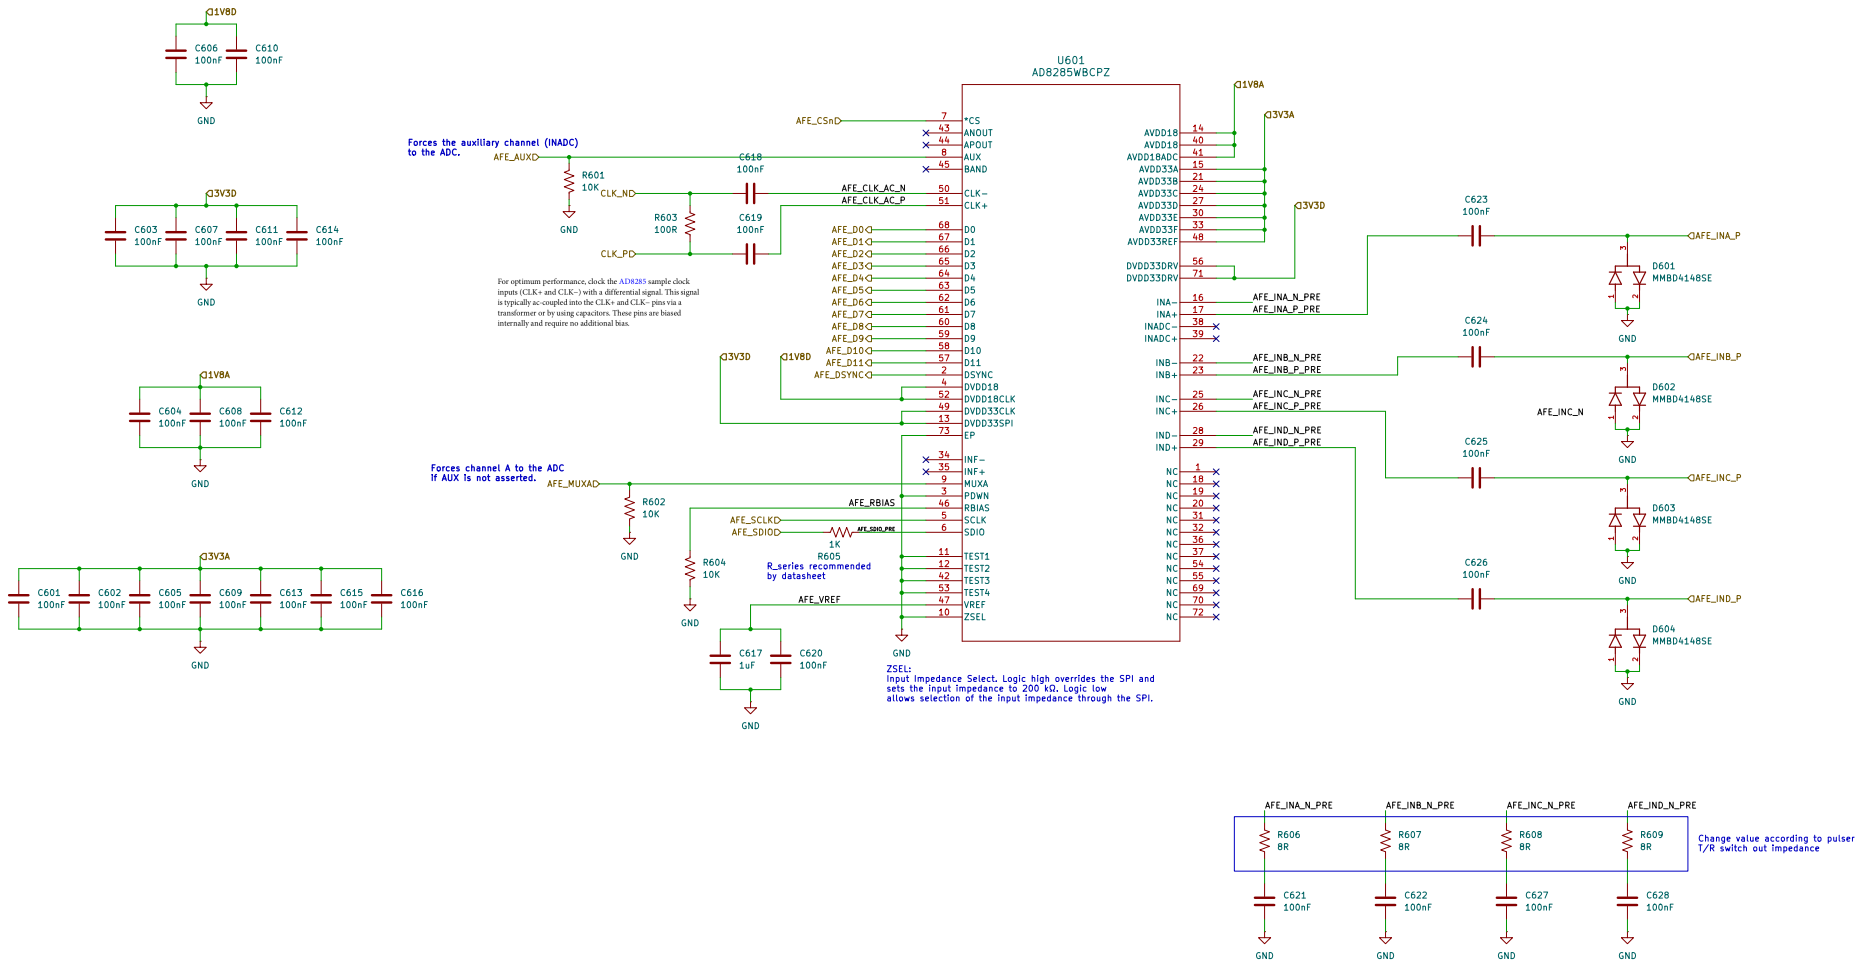
[picture p23: page 15]

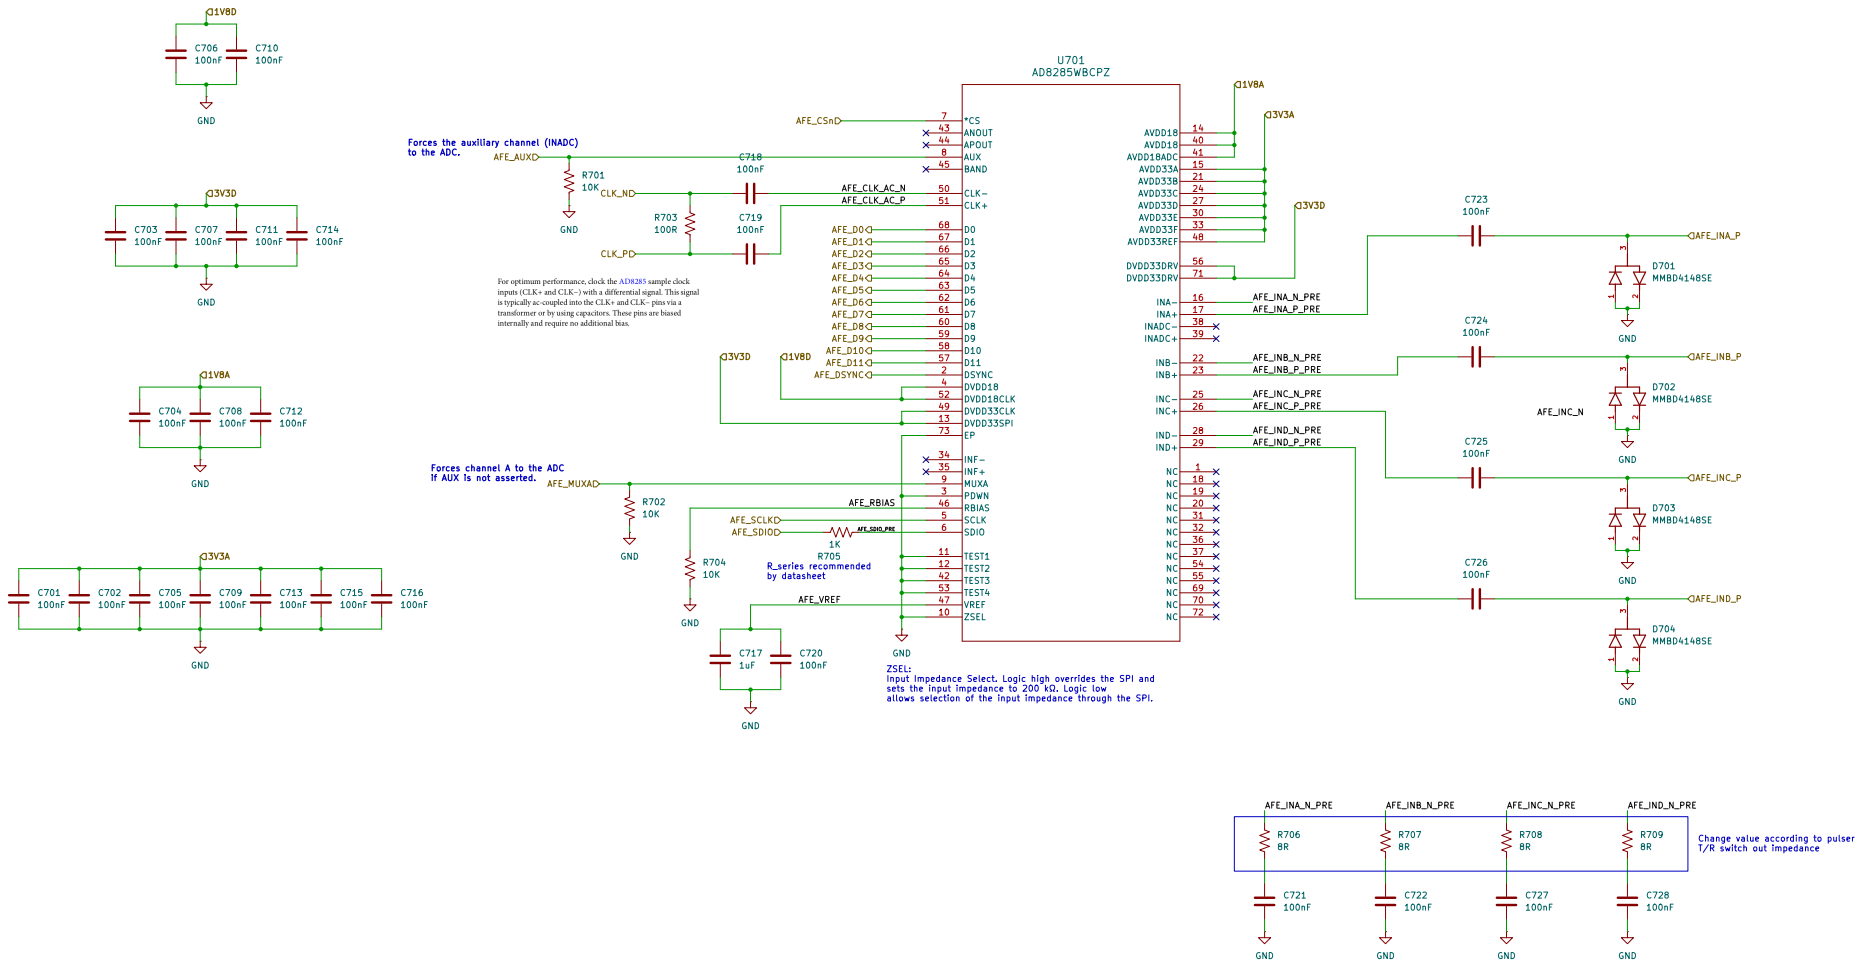
[picture p24: page 16]

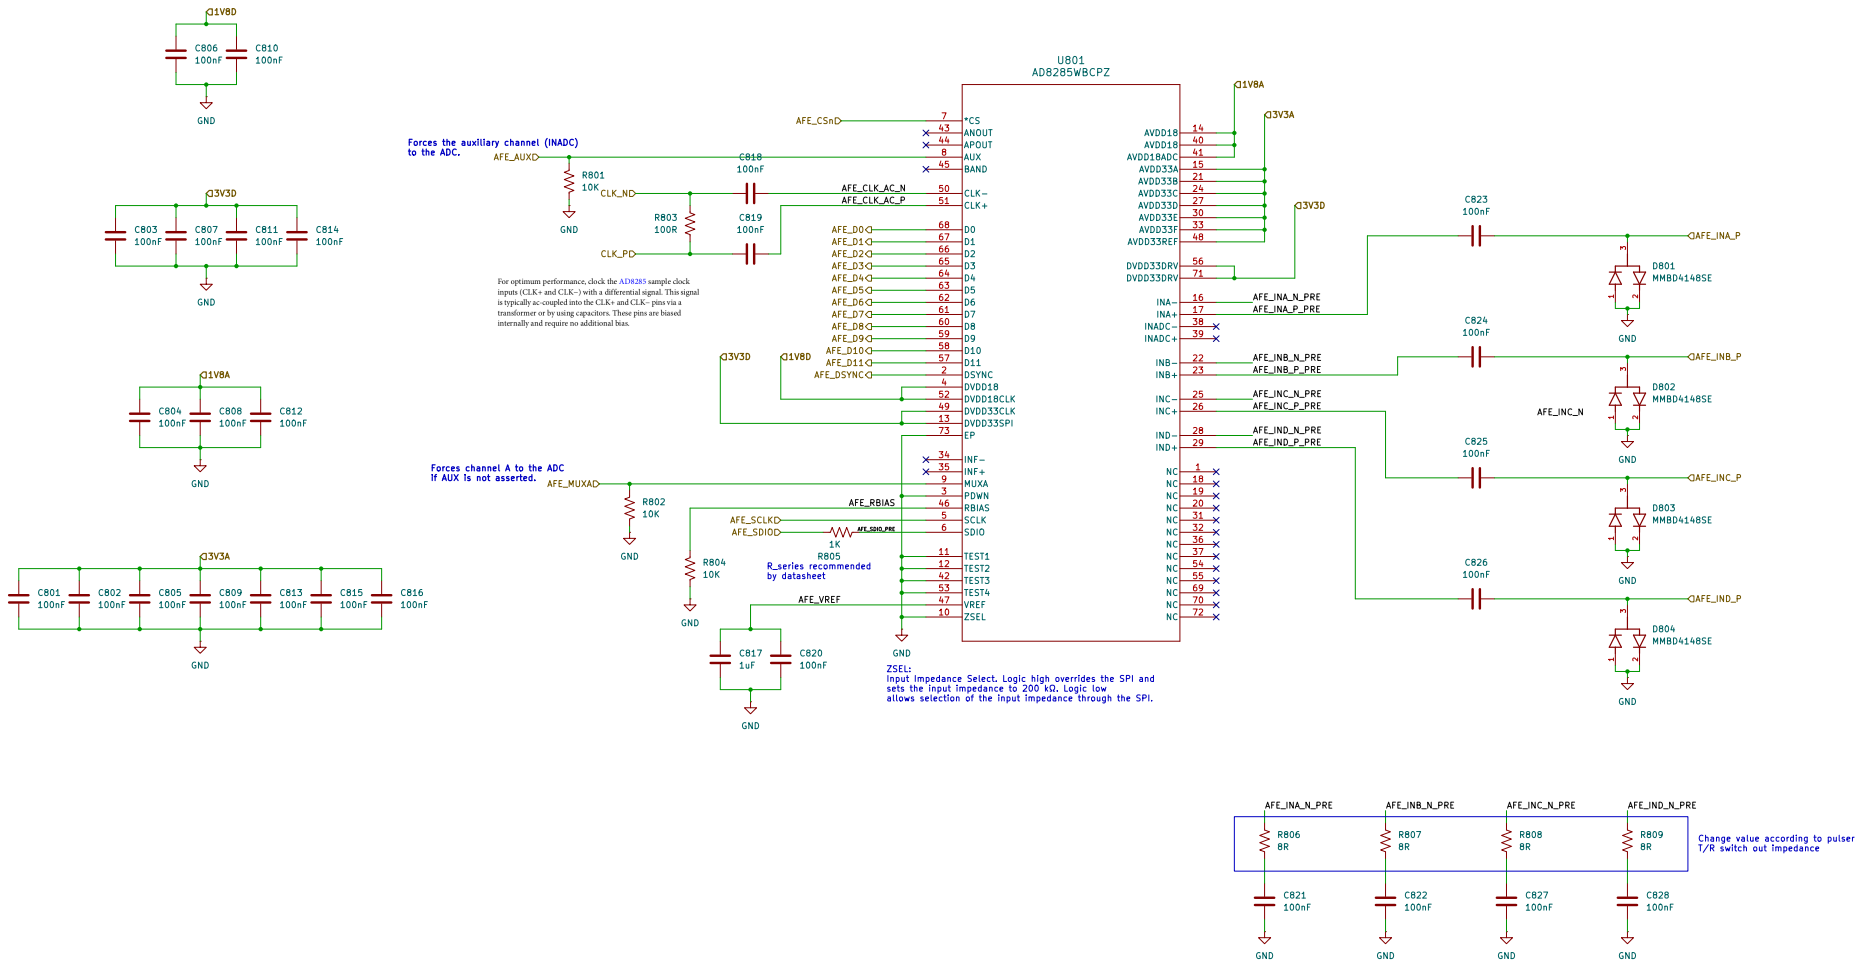
[picture p25: page 17]

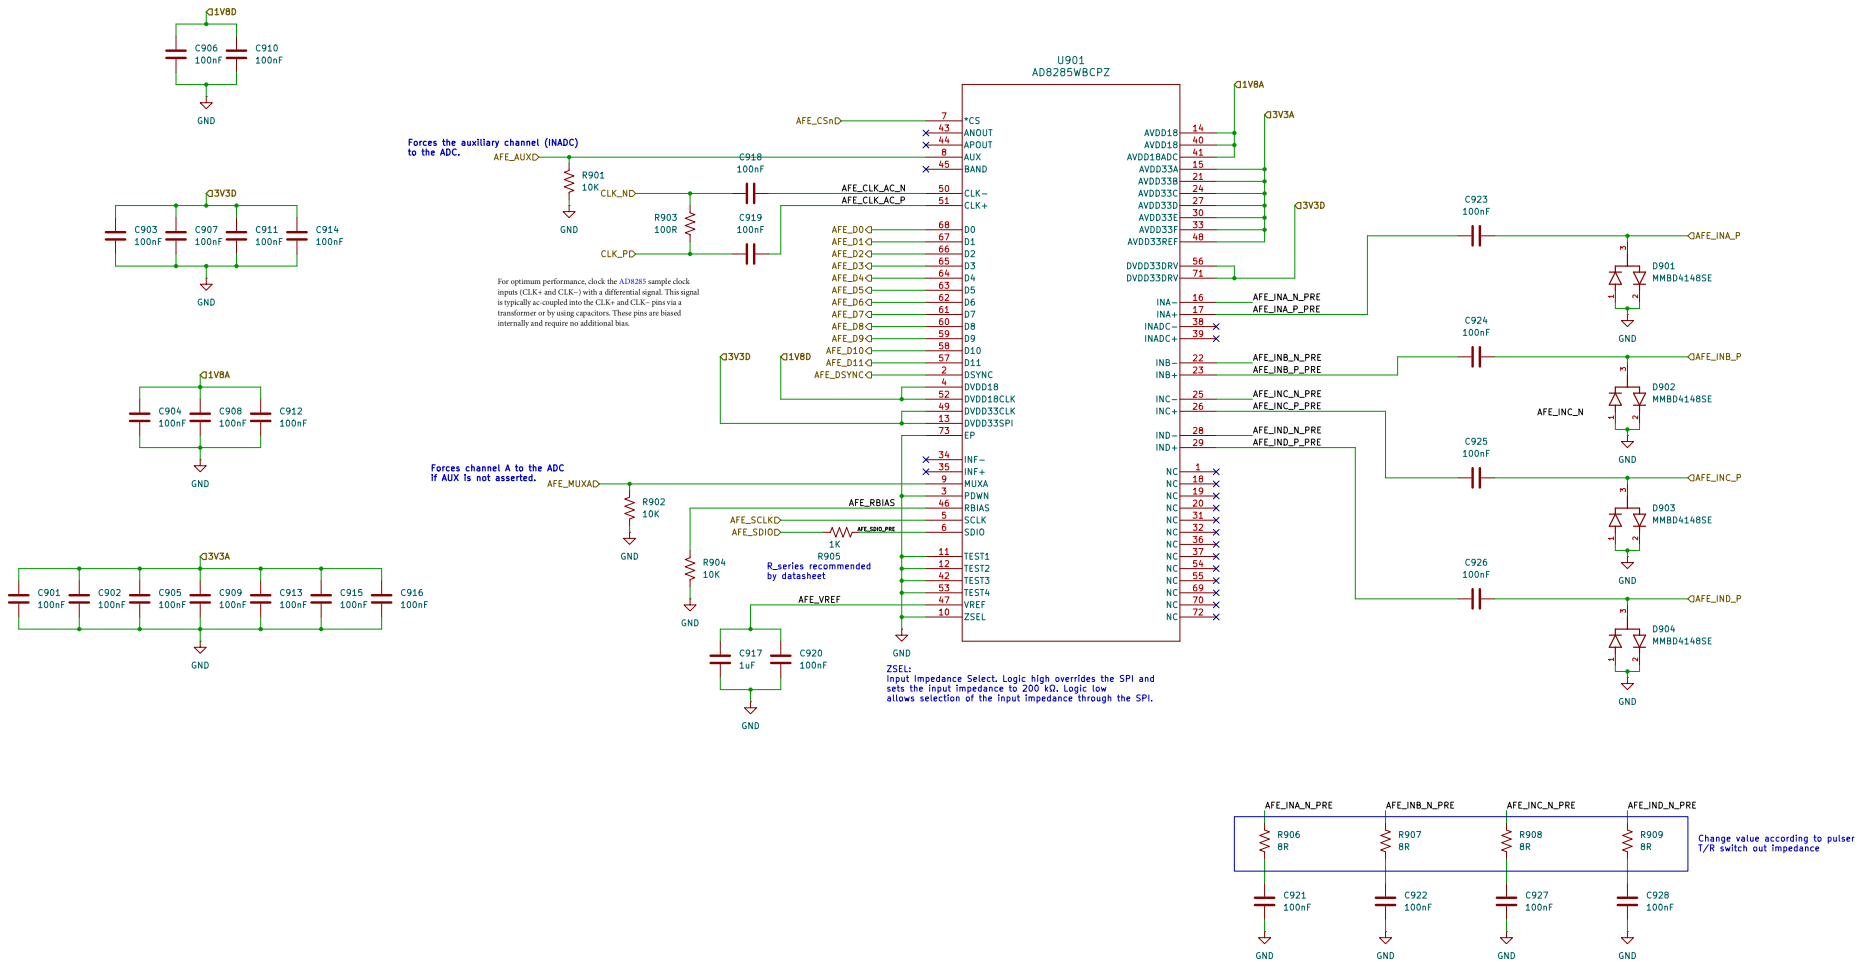
[picture p26: page 18]

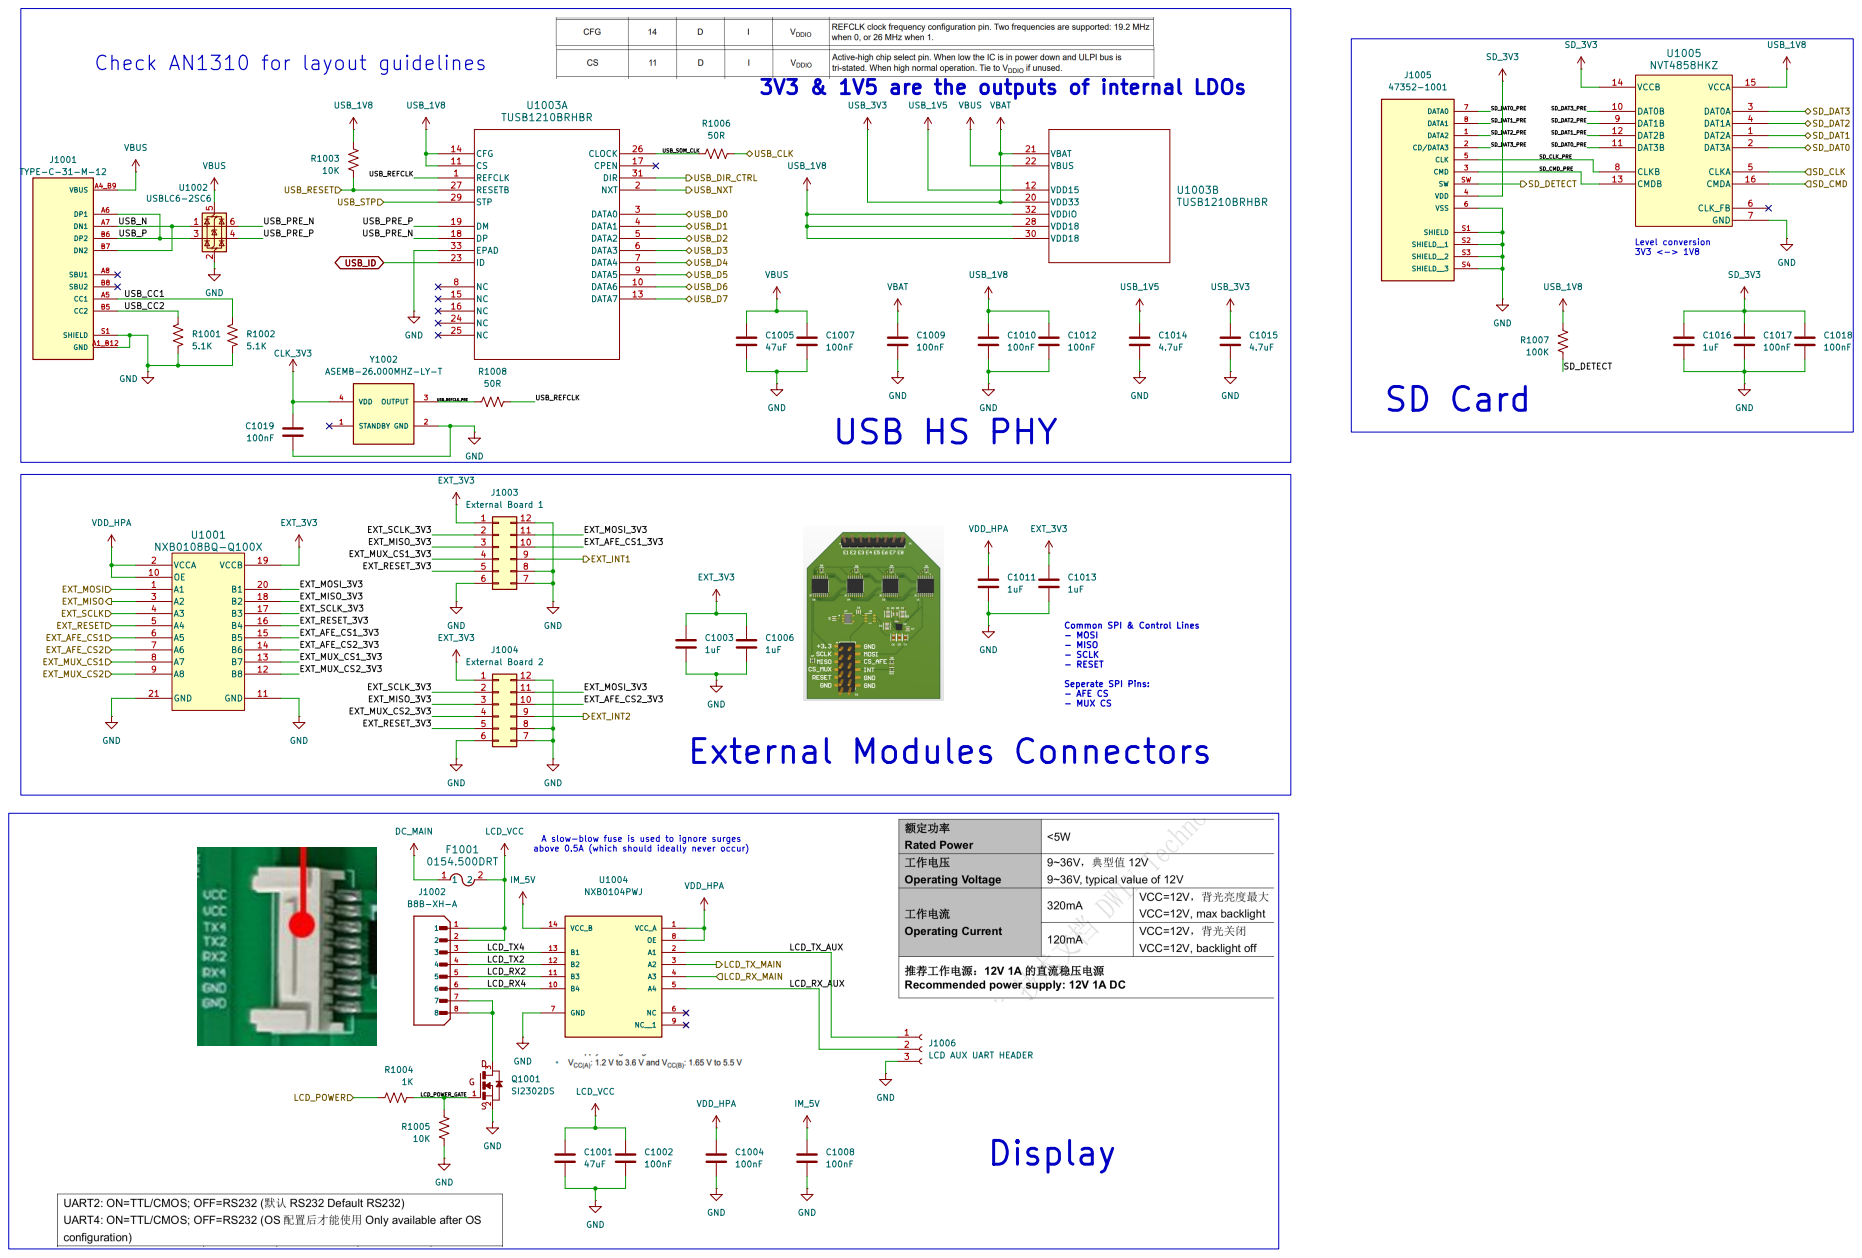
[picture p27: page 19]

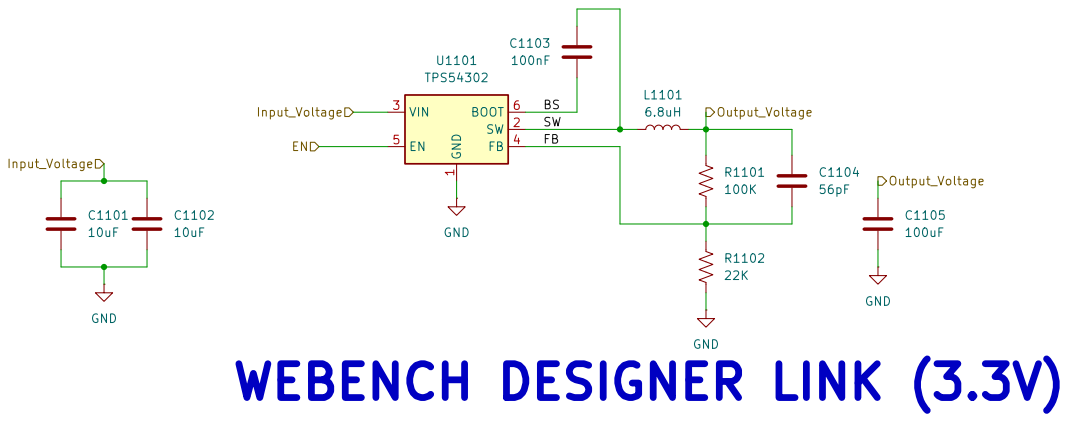
[picture p28: page 20]

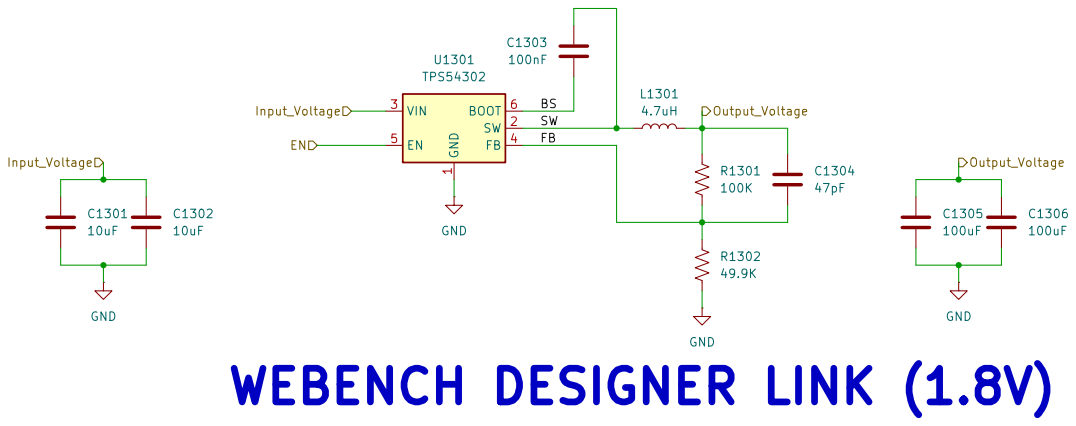
[picture p29: page 21]

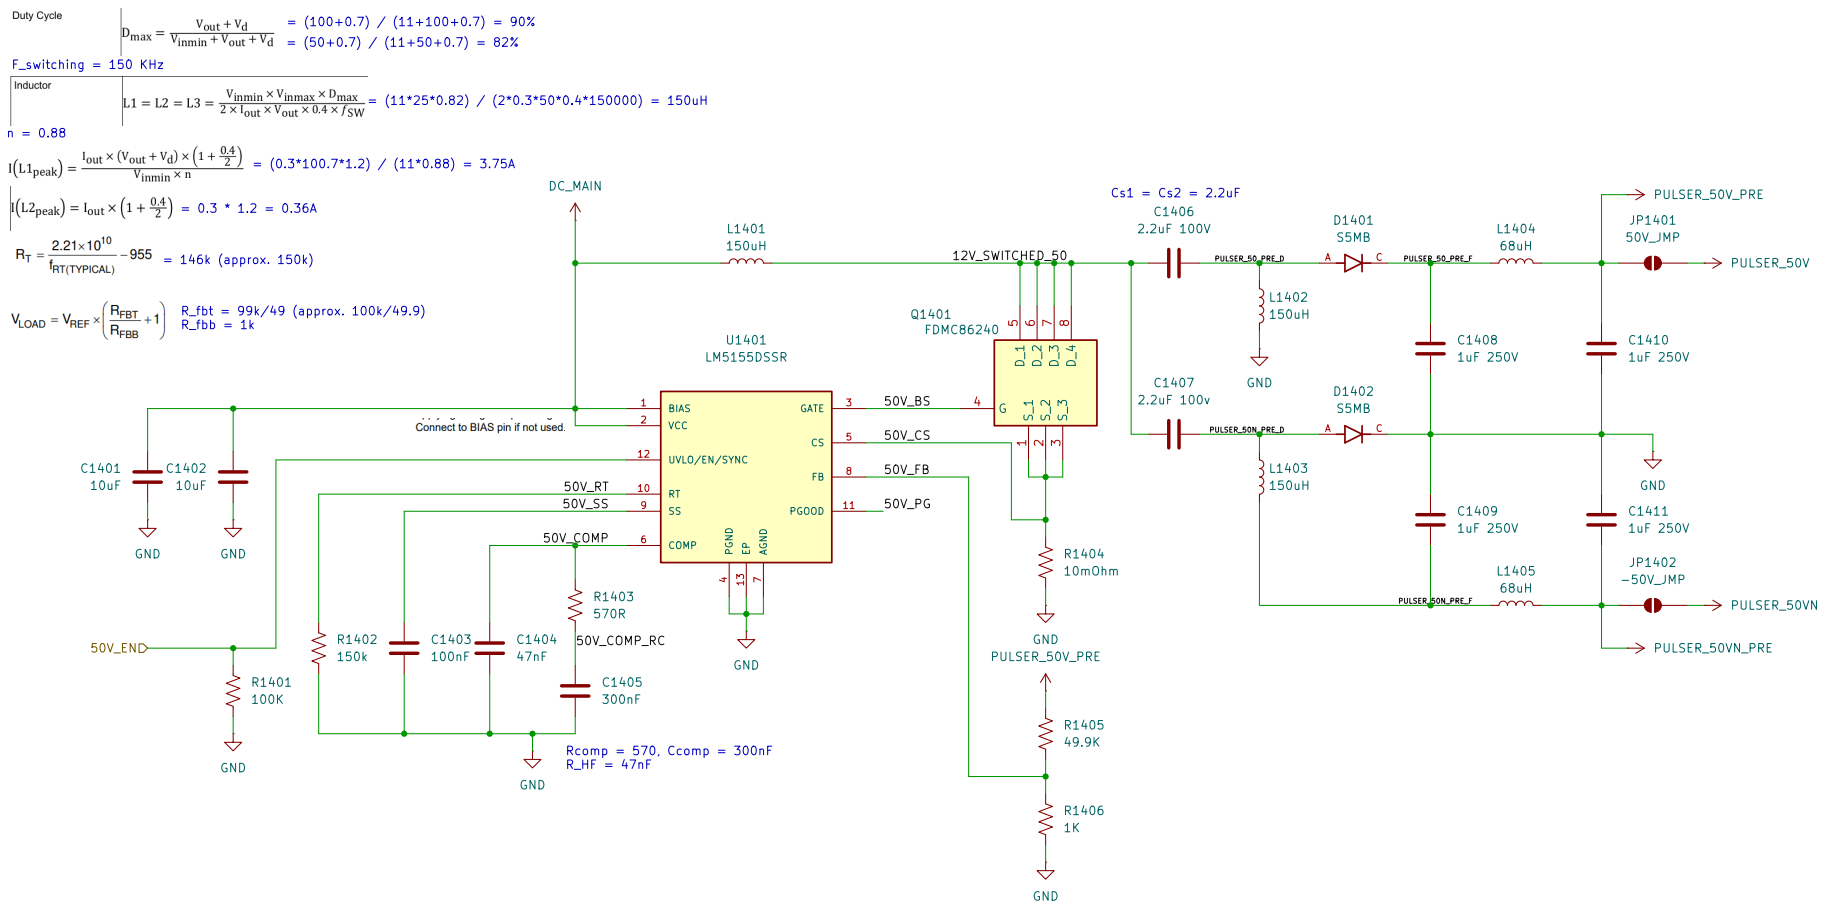
[picture p30: page 22]

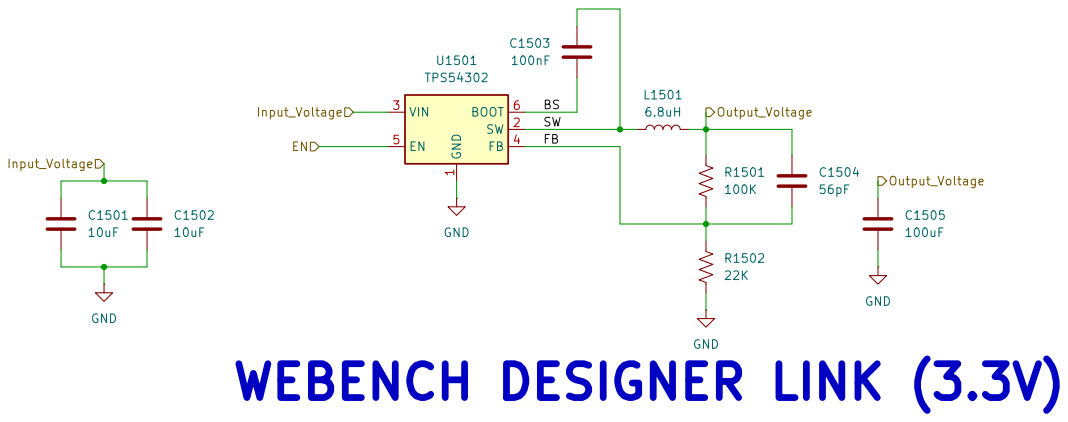
[picture p31: page 23]

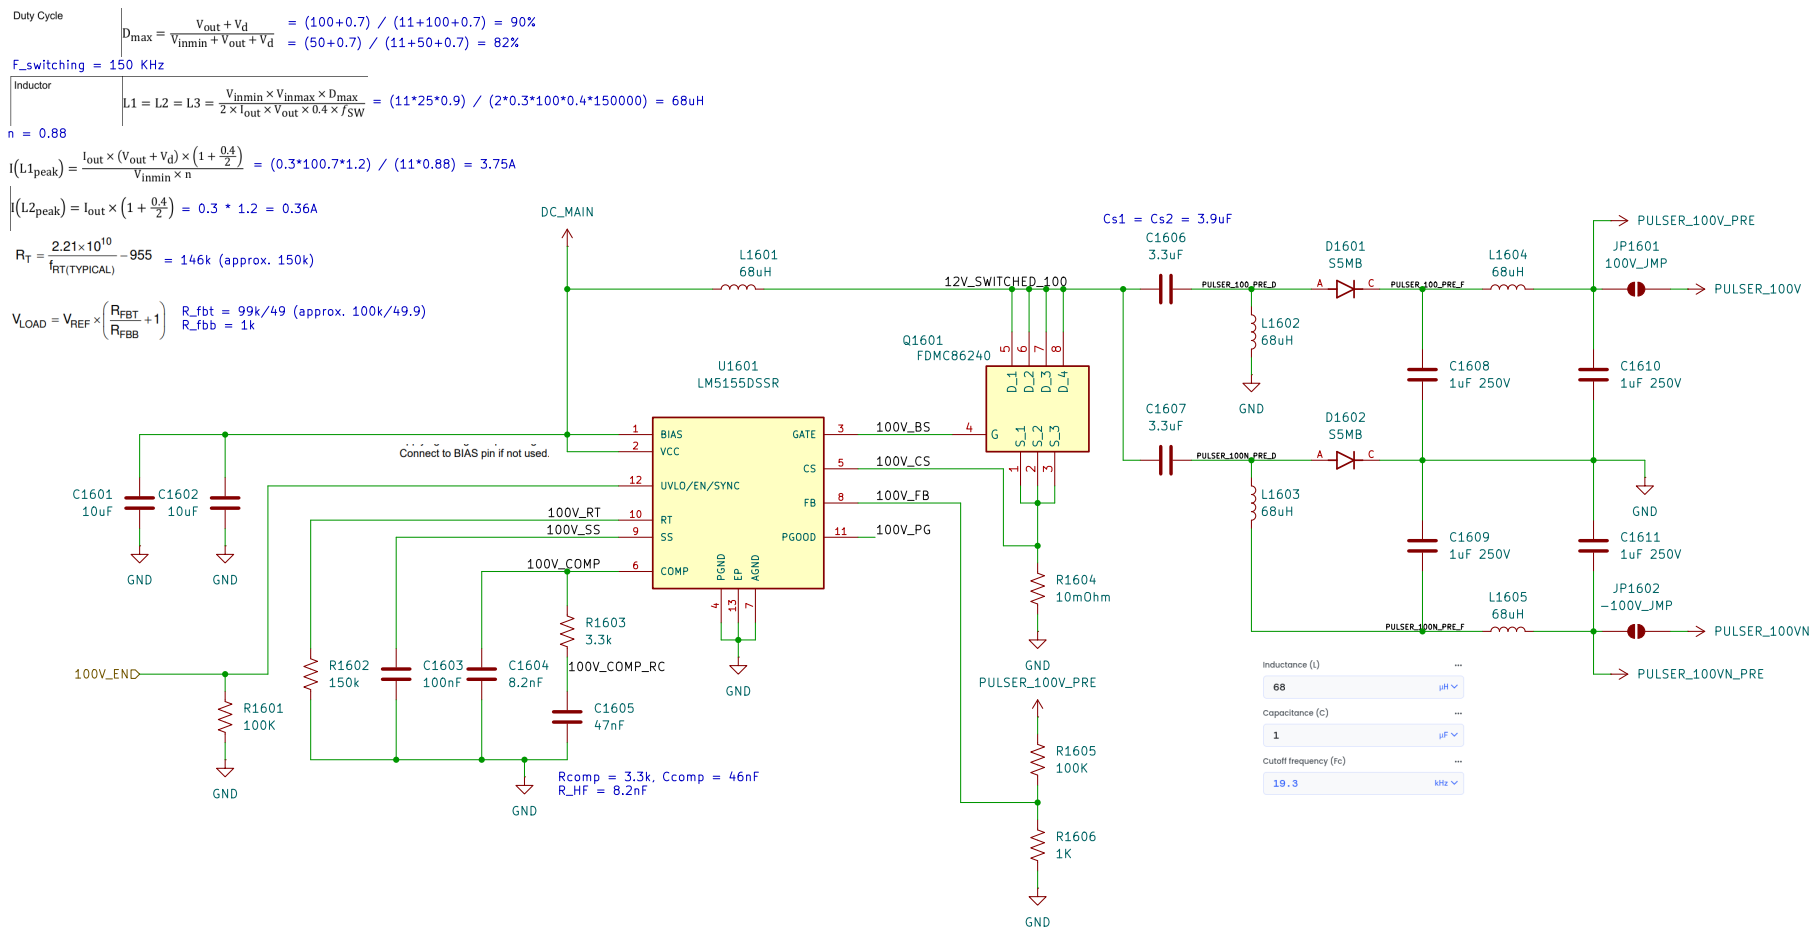
[picture p32: page 24]

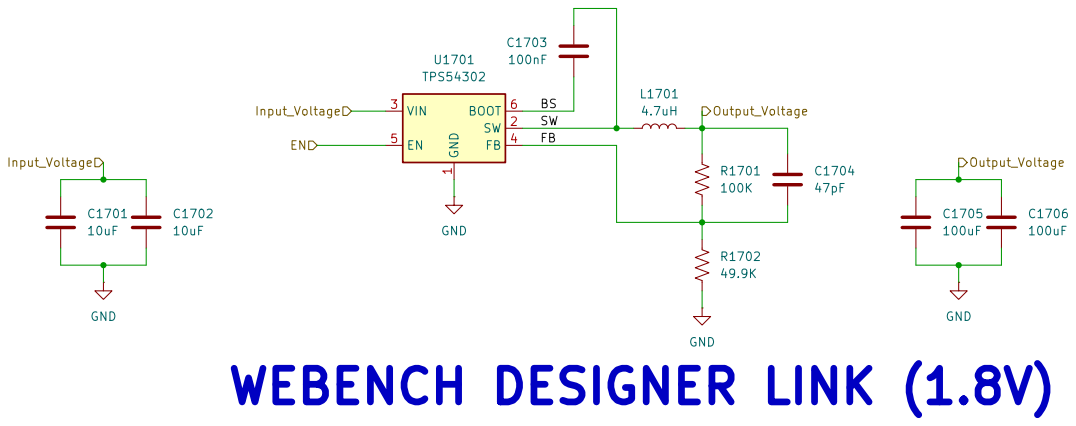
[picture p33: page 25]

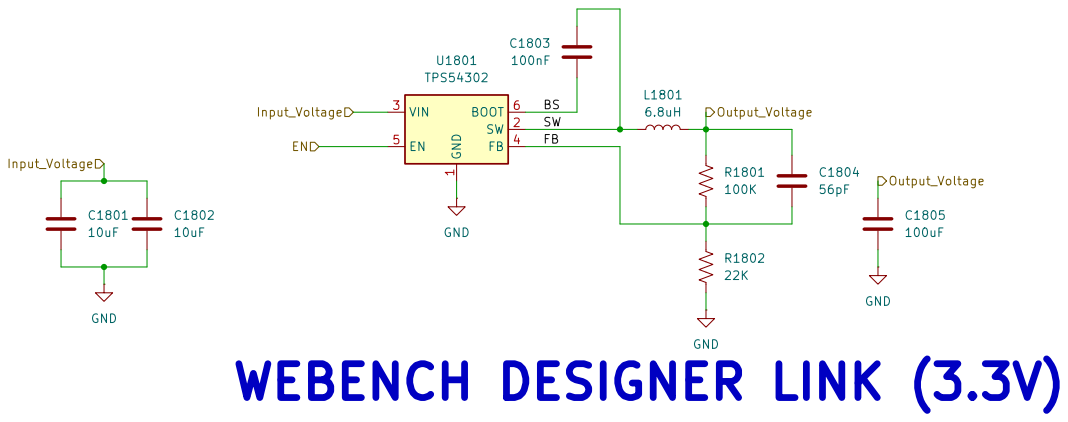
[picture p34: page 26]

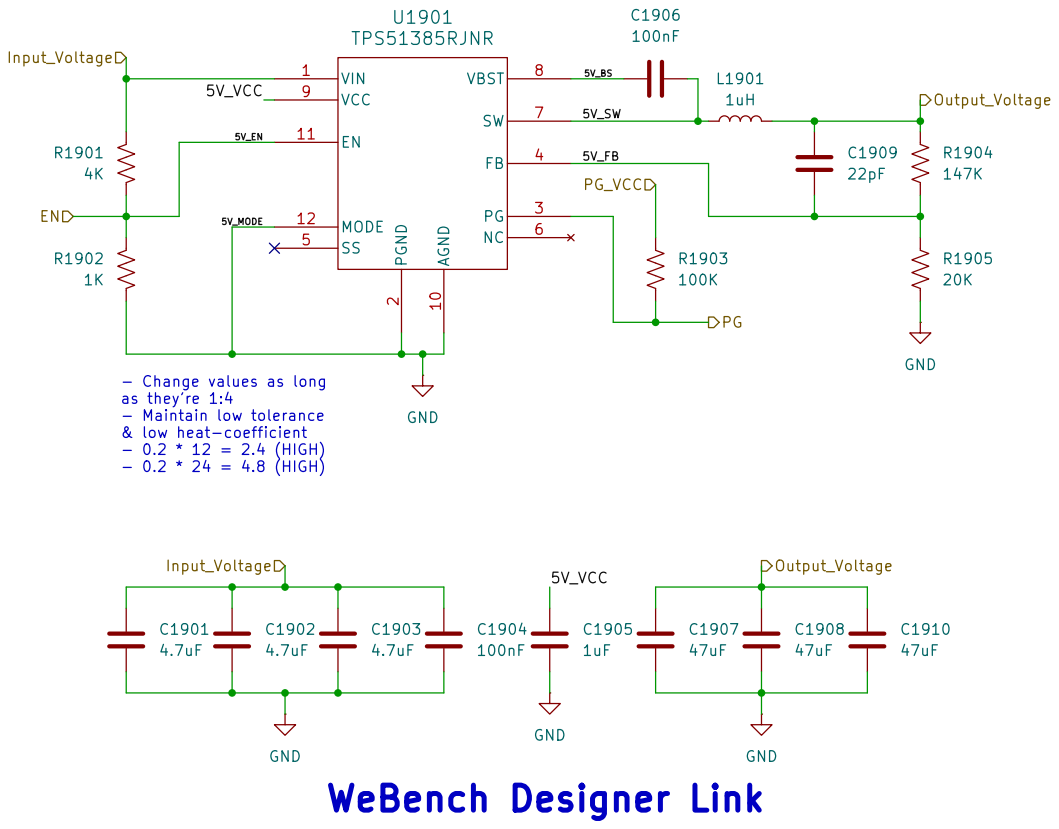
[picture p35: page 27]

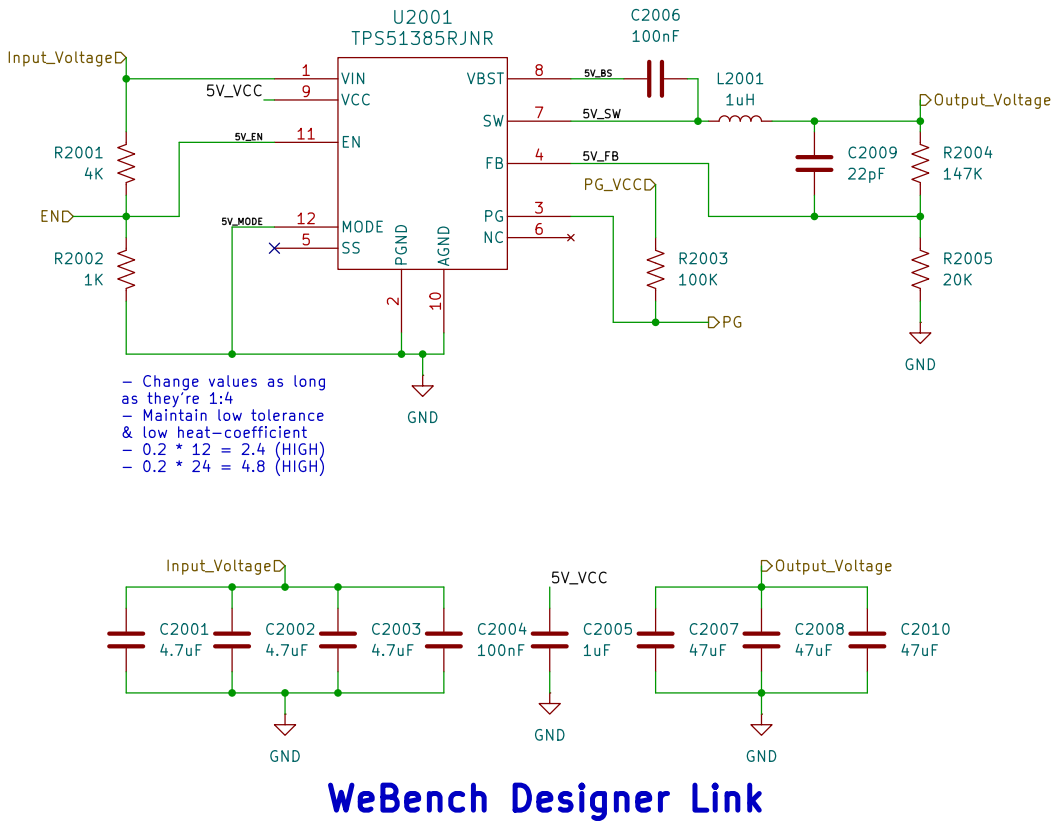
[picture p36: page 28]
