yusufElnady/Medical-Imager/Documentation/UltrasoundMedicalImagerOverview.pdf

## Ultrasound Medical Imager

### Final Dimensions: 10*14 cm²

### 3D Model

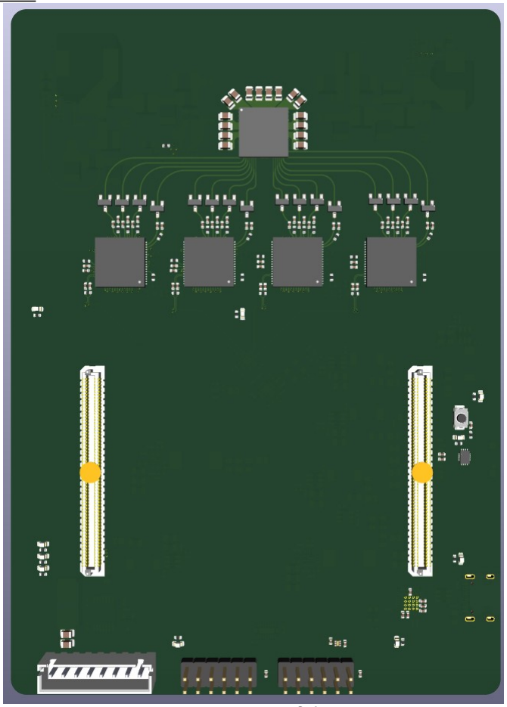
[picture p37: figure]

Figure 1: Top view of the PCB.

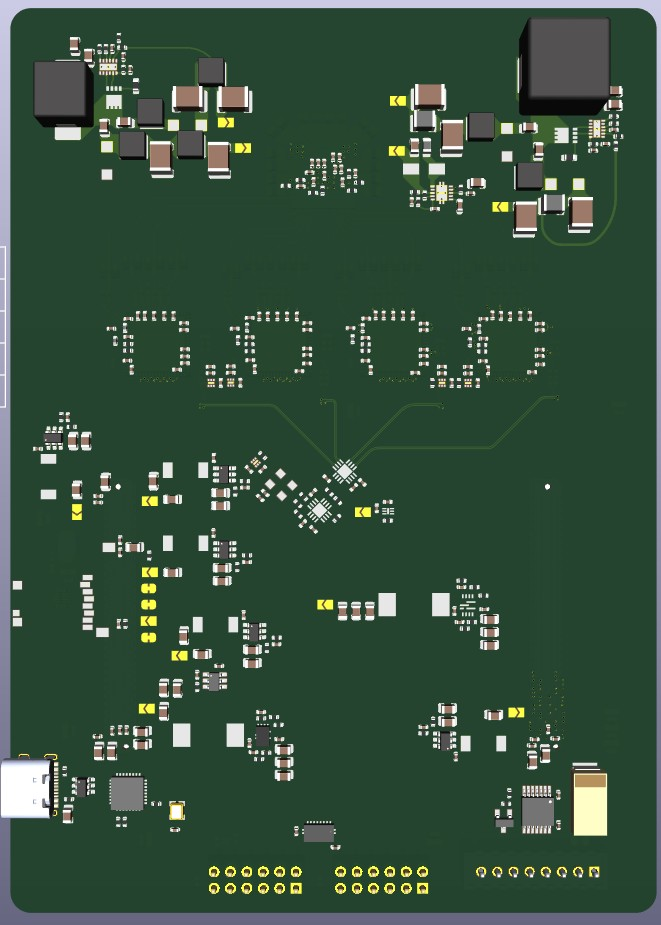
[picture p38: figure]

Figure 2: Bottom view of the PCB.

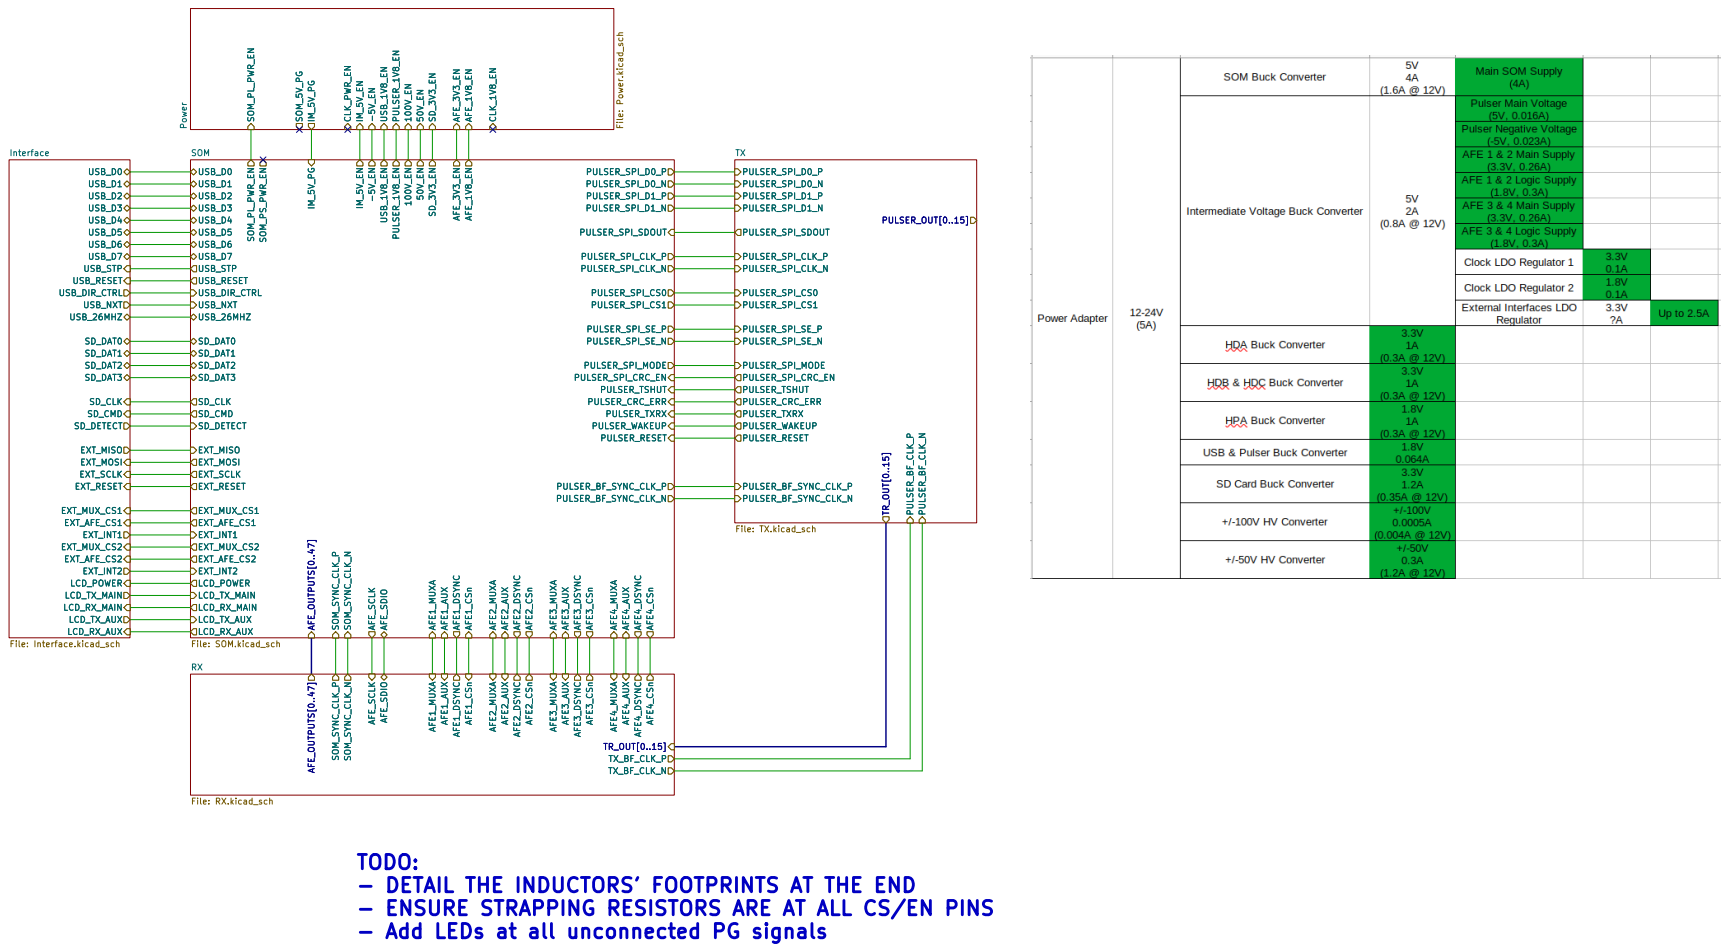
[picture p39: page 3]

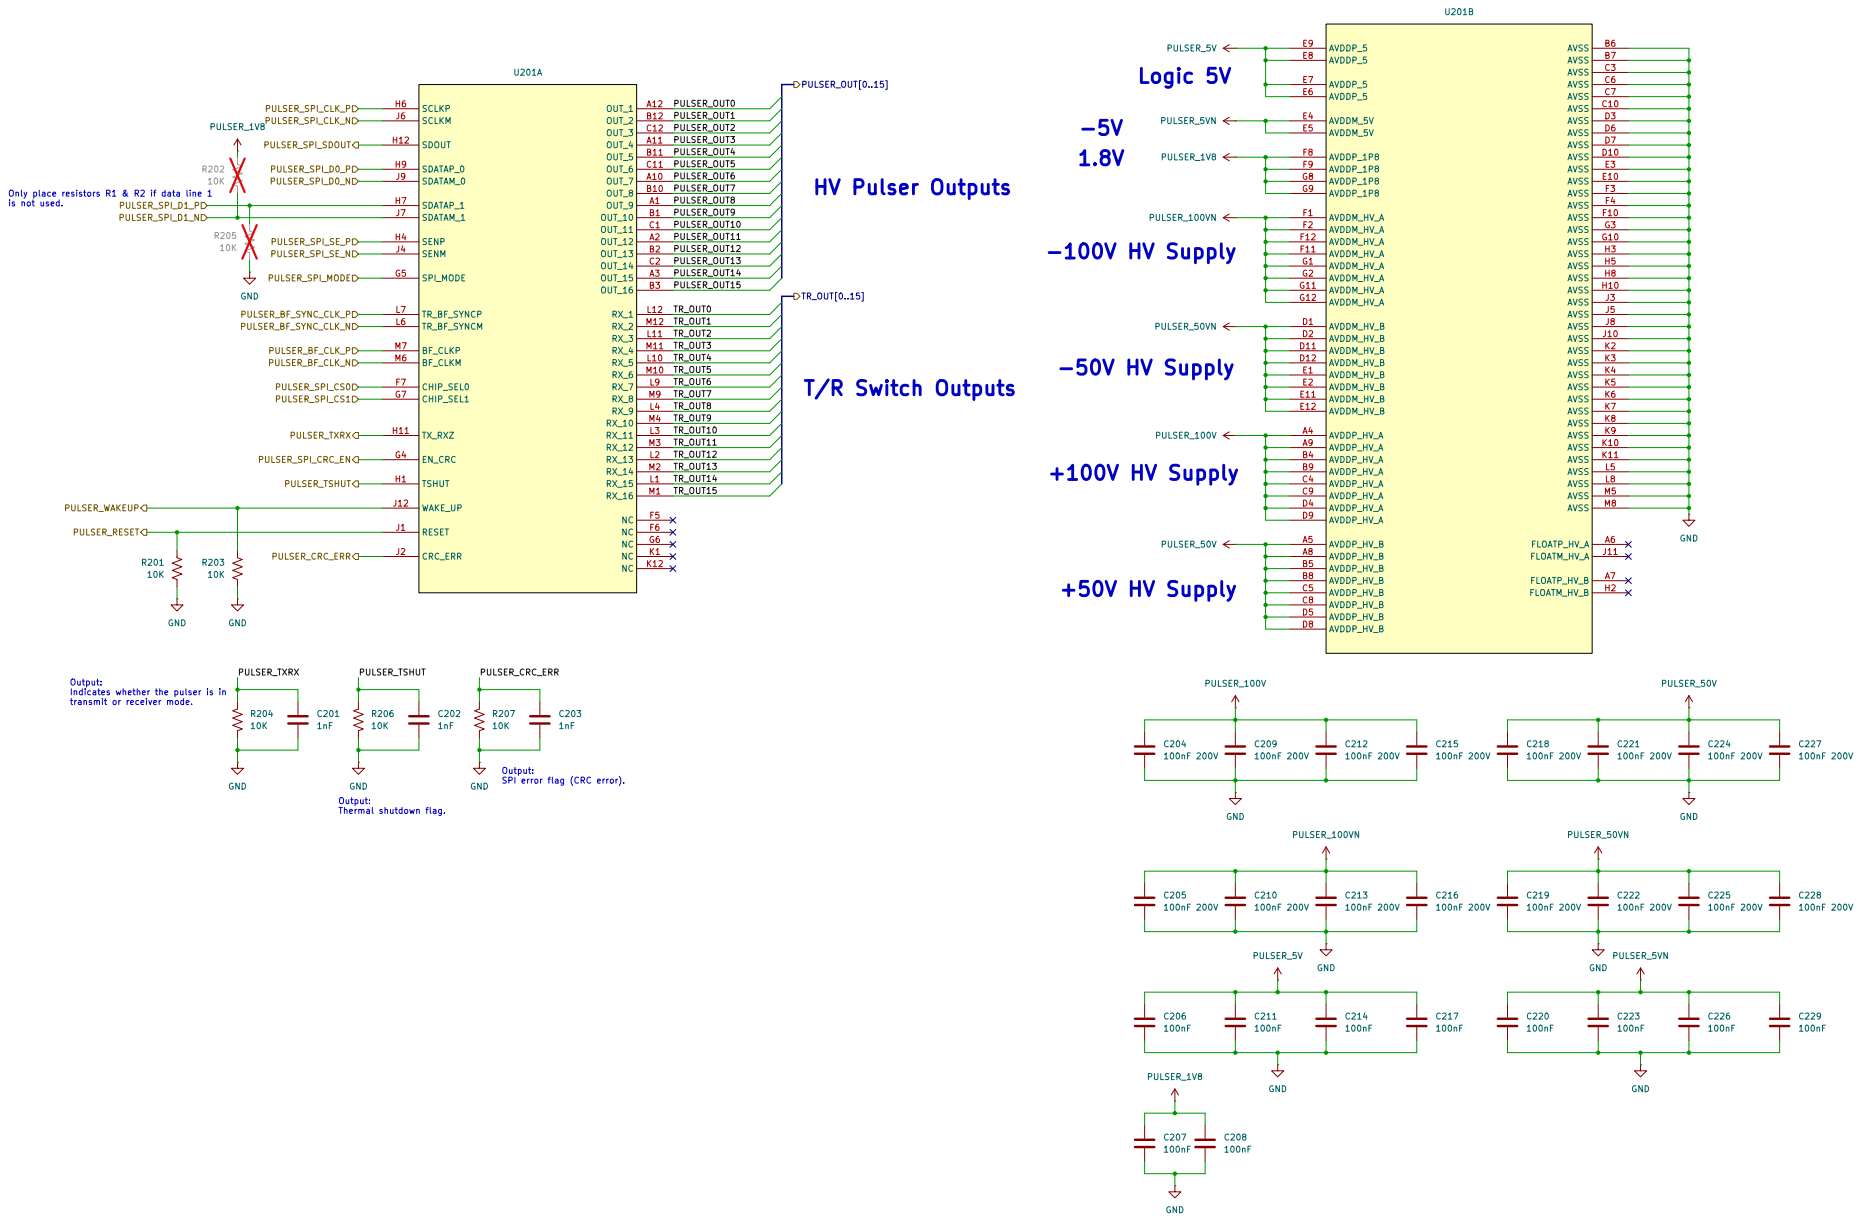
[picture p40: page 4]

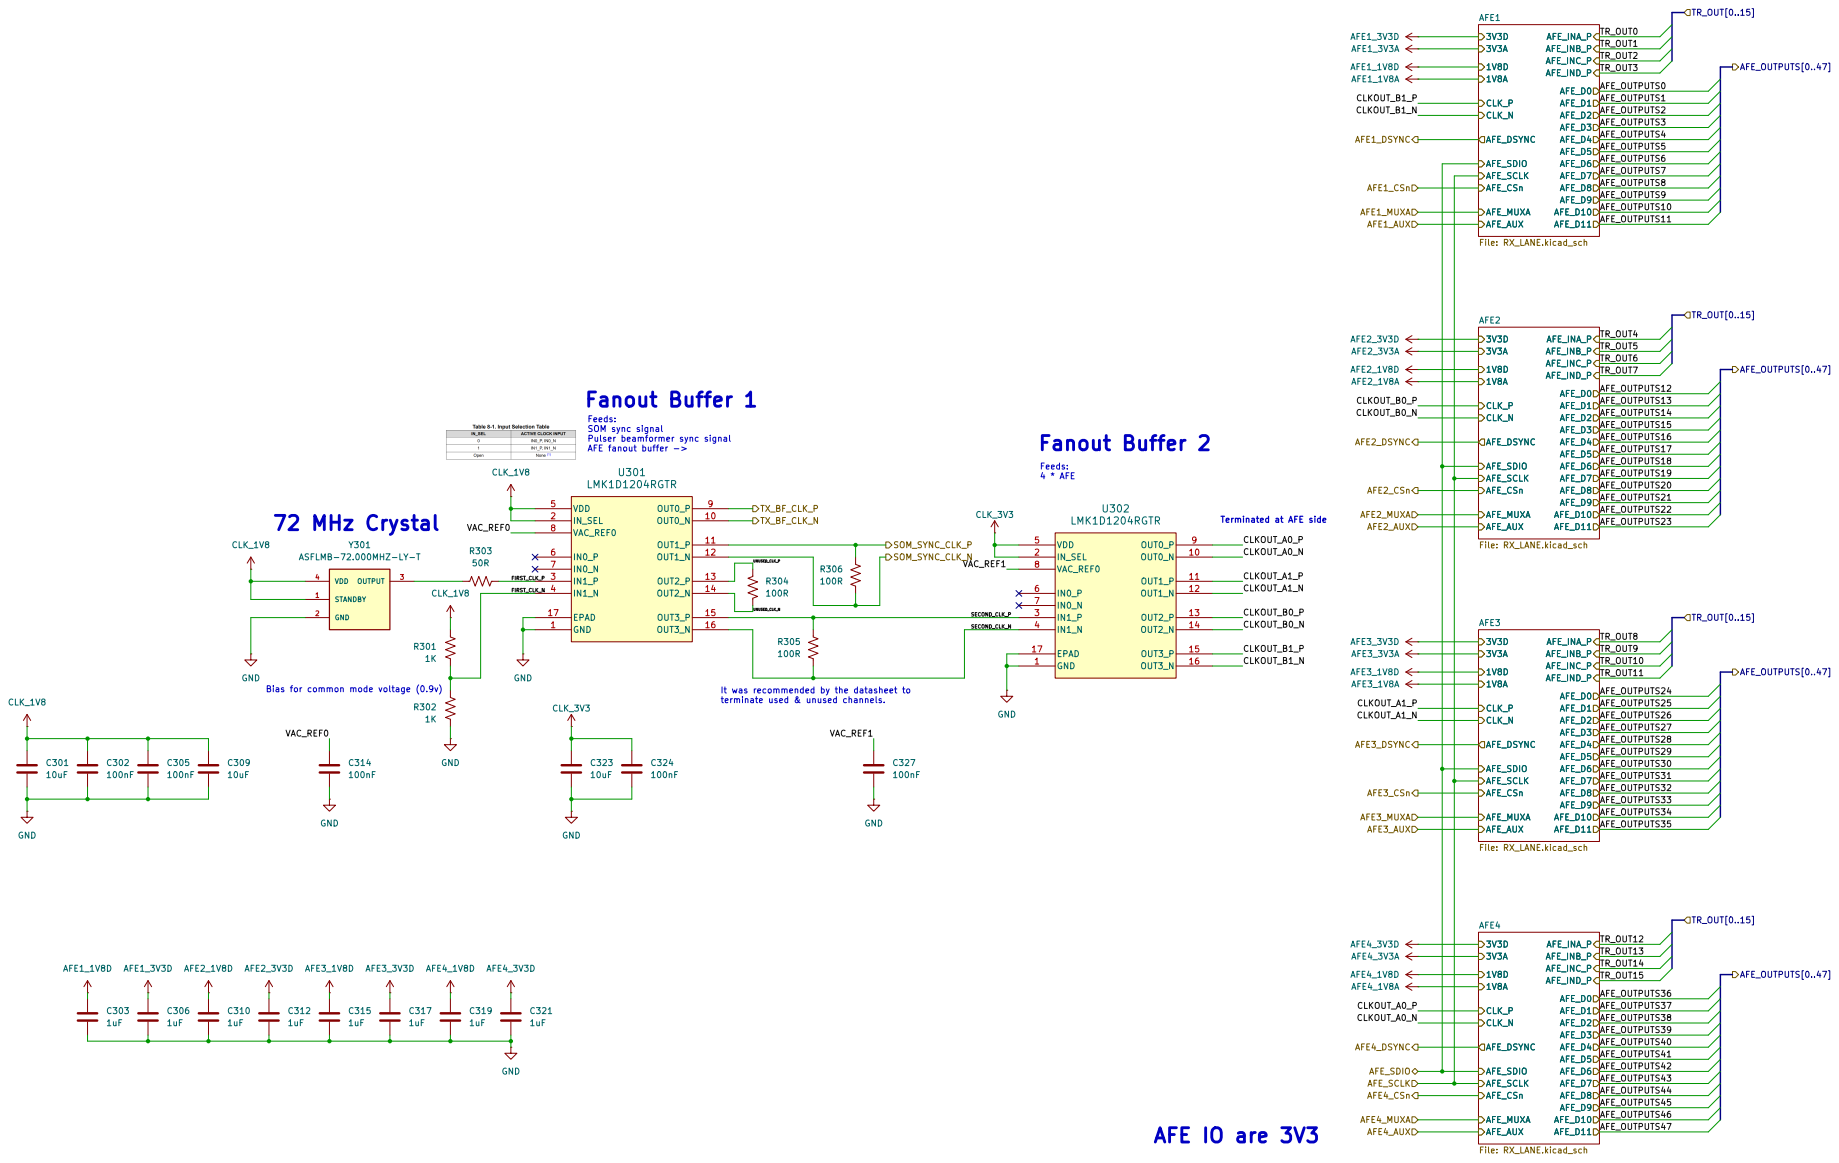
[picture p41: page 5]

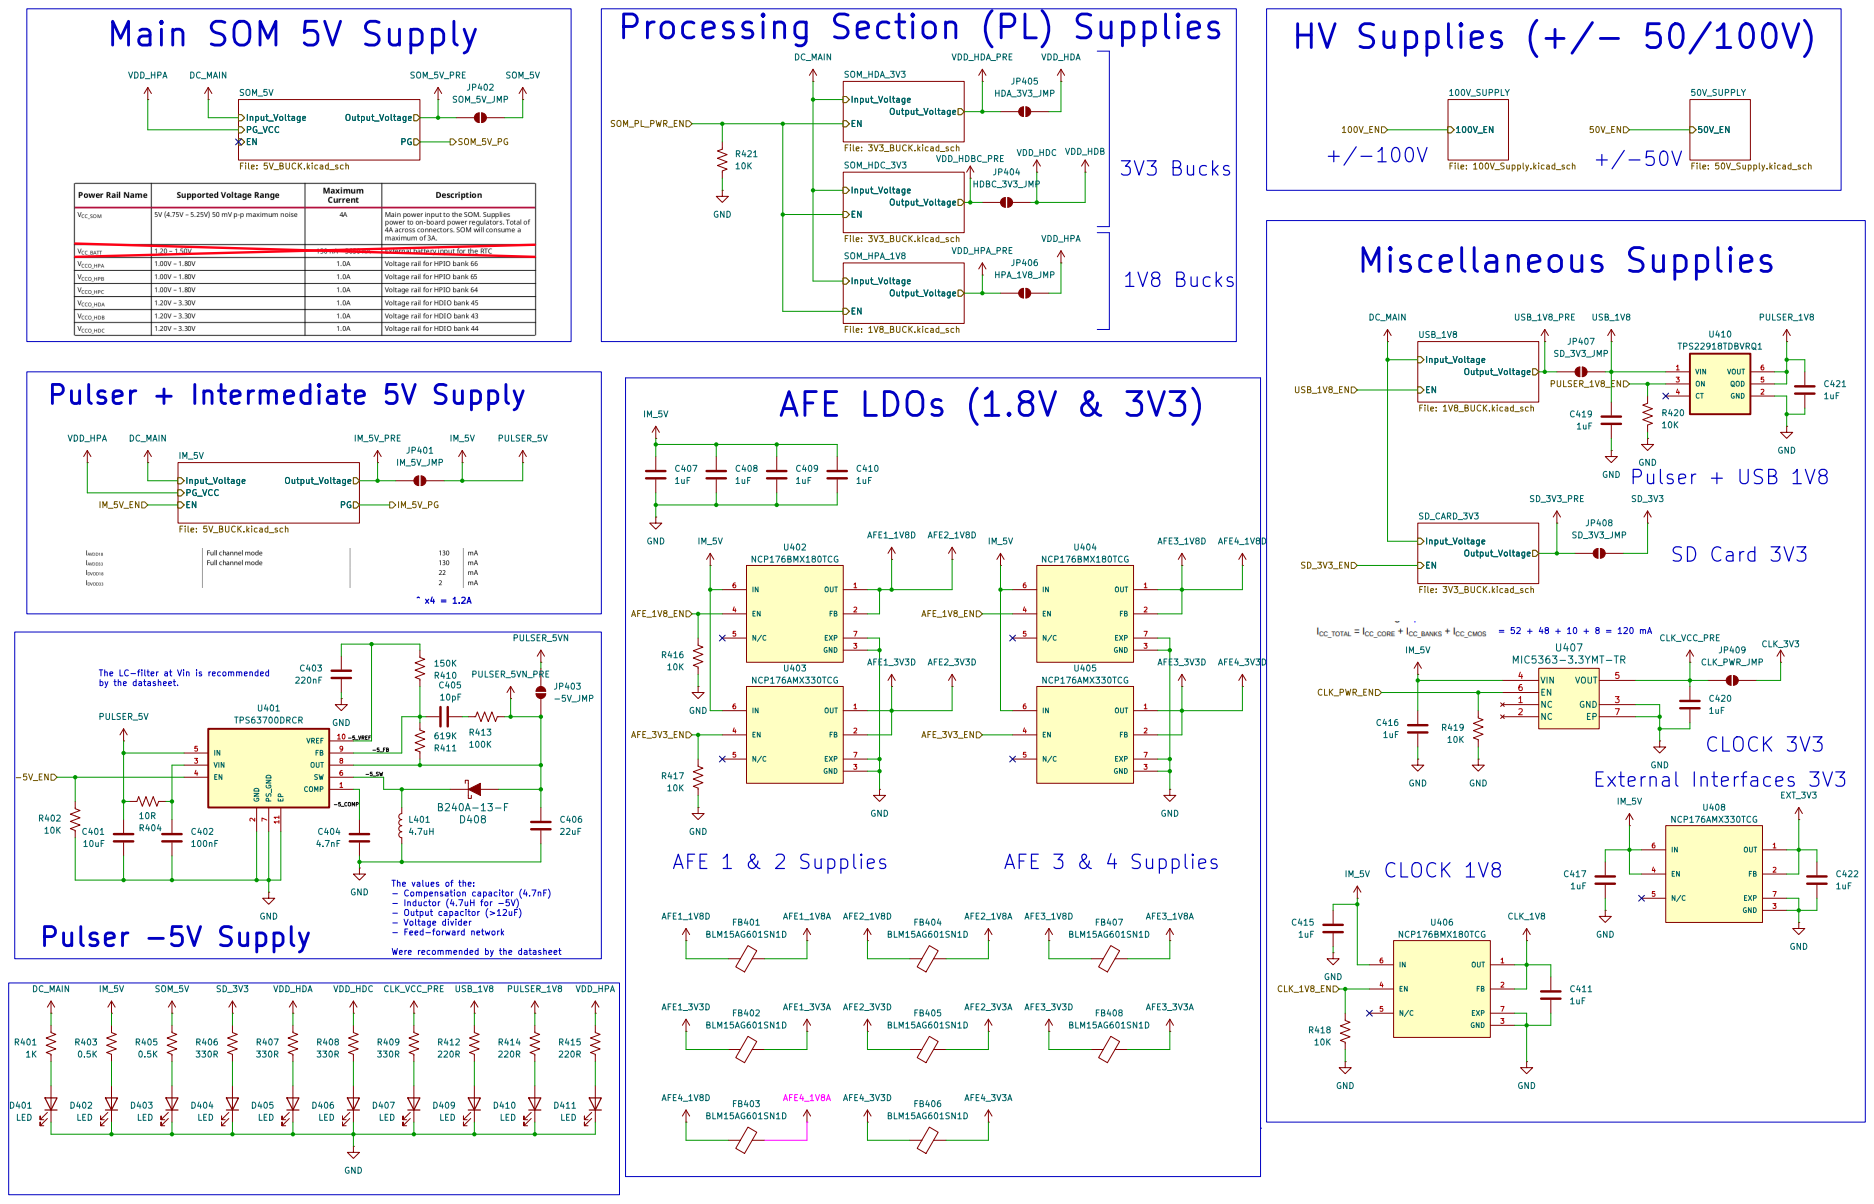
[picture p42: page 6]

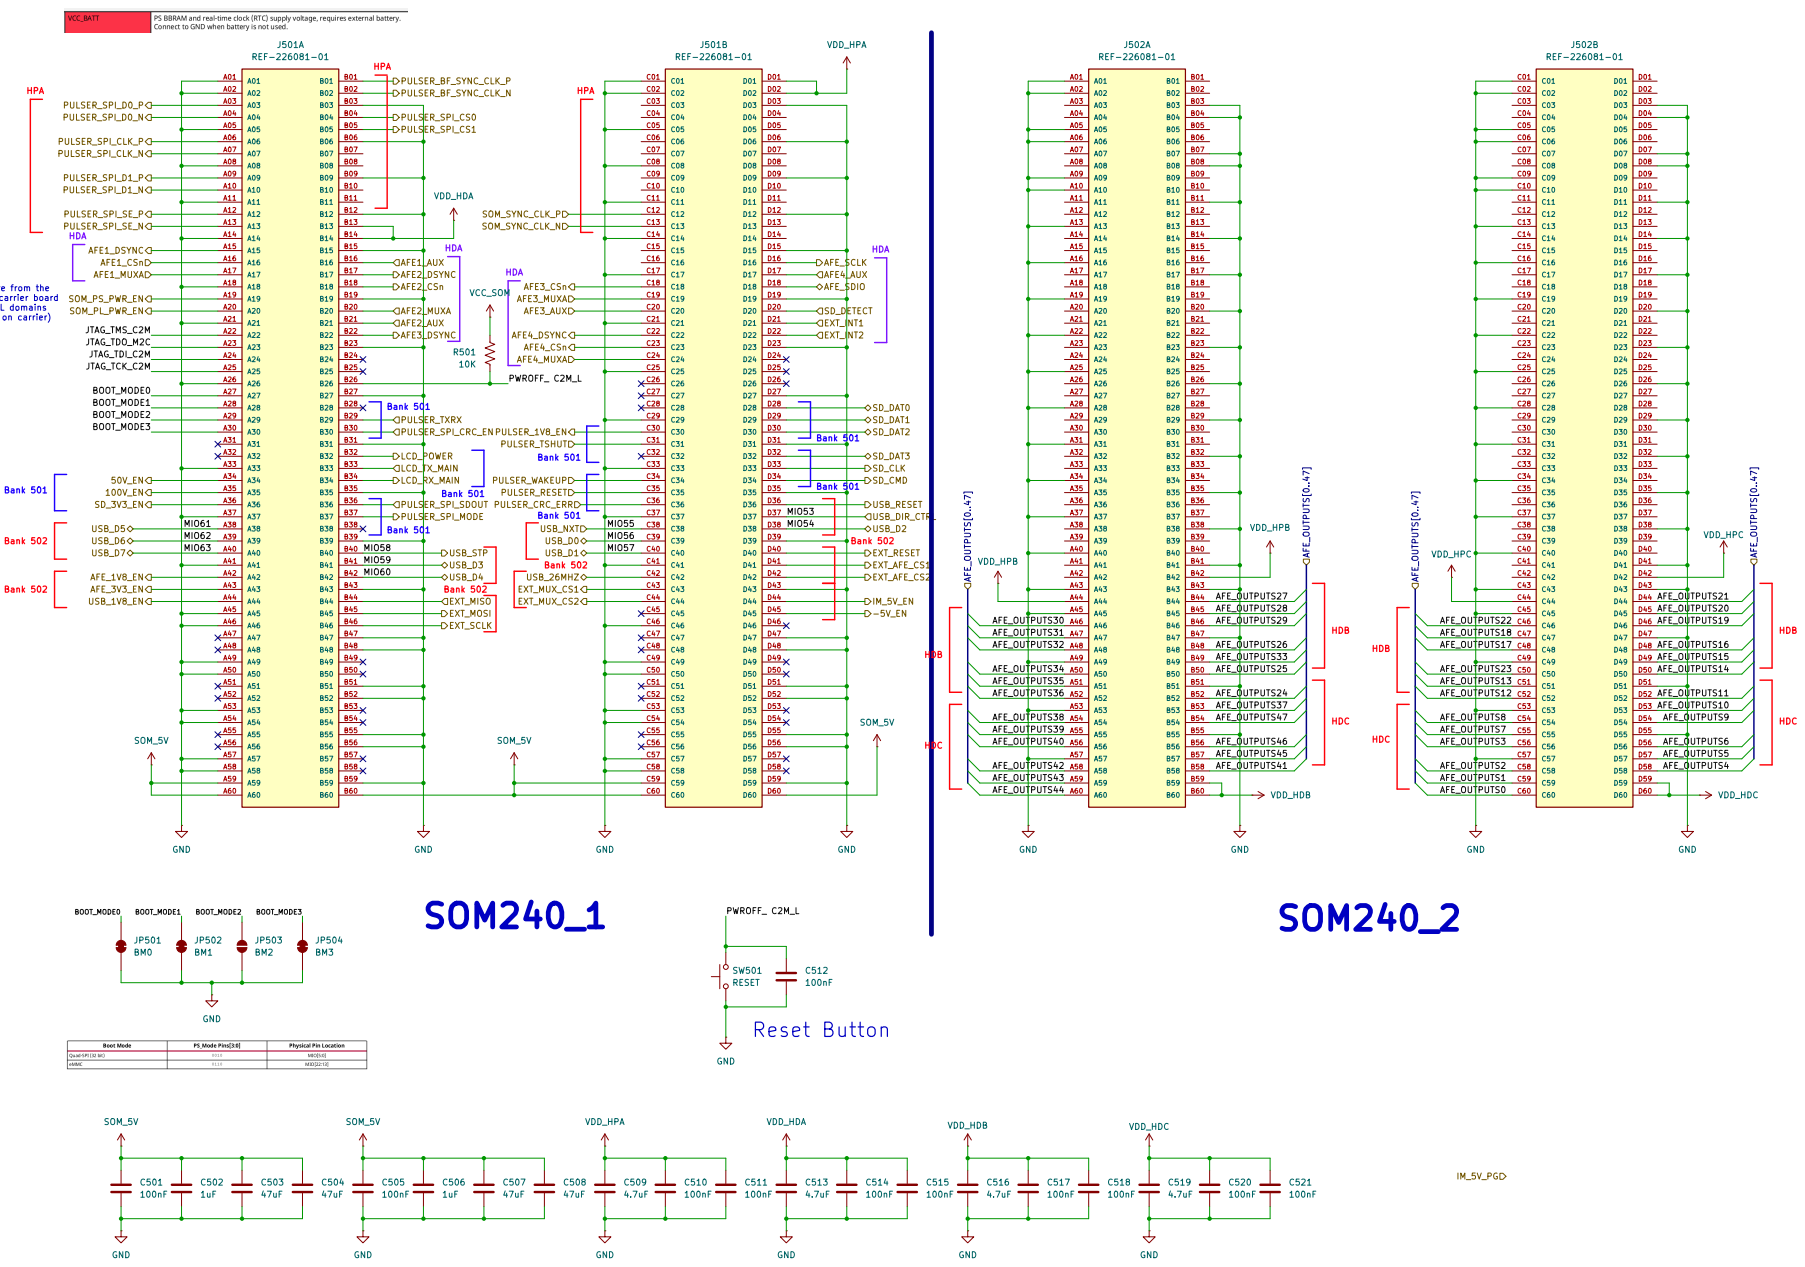
[picture p43: page 7]

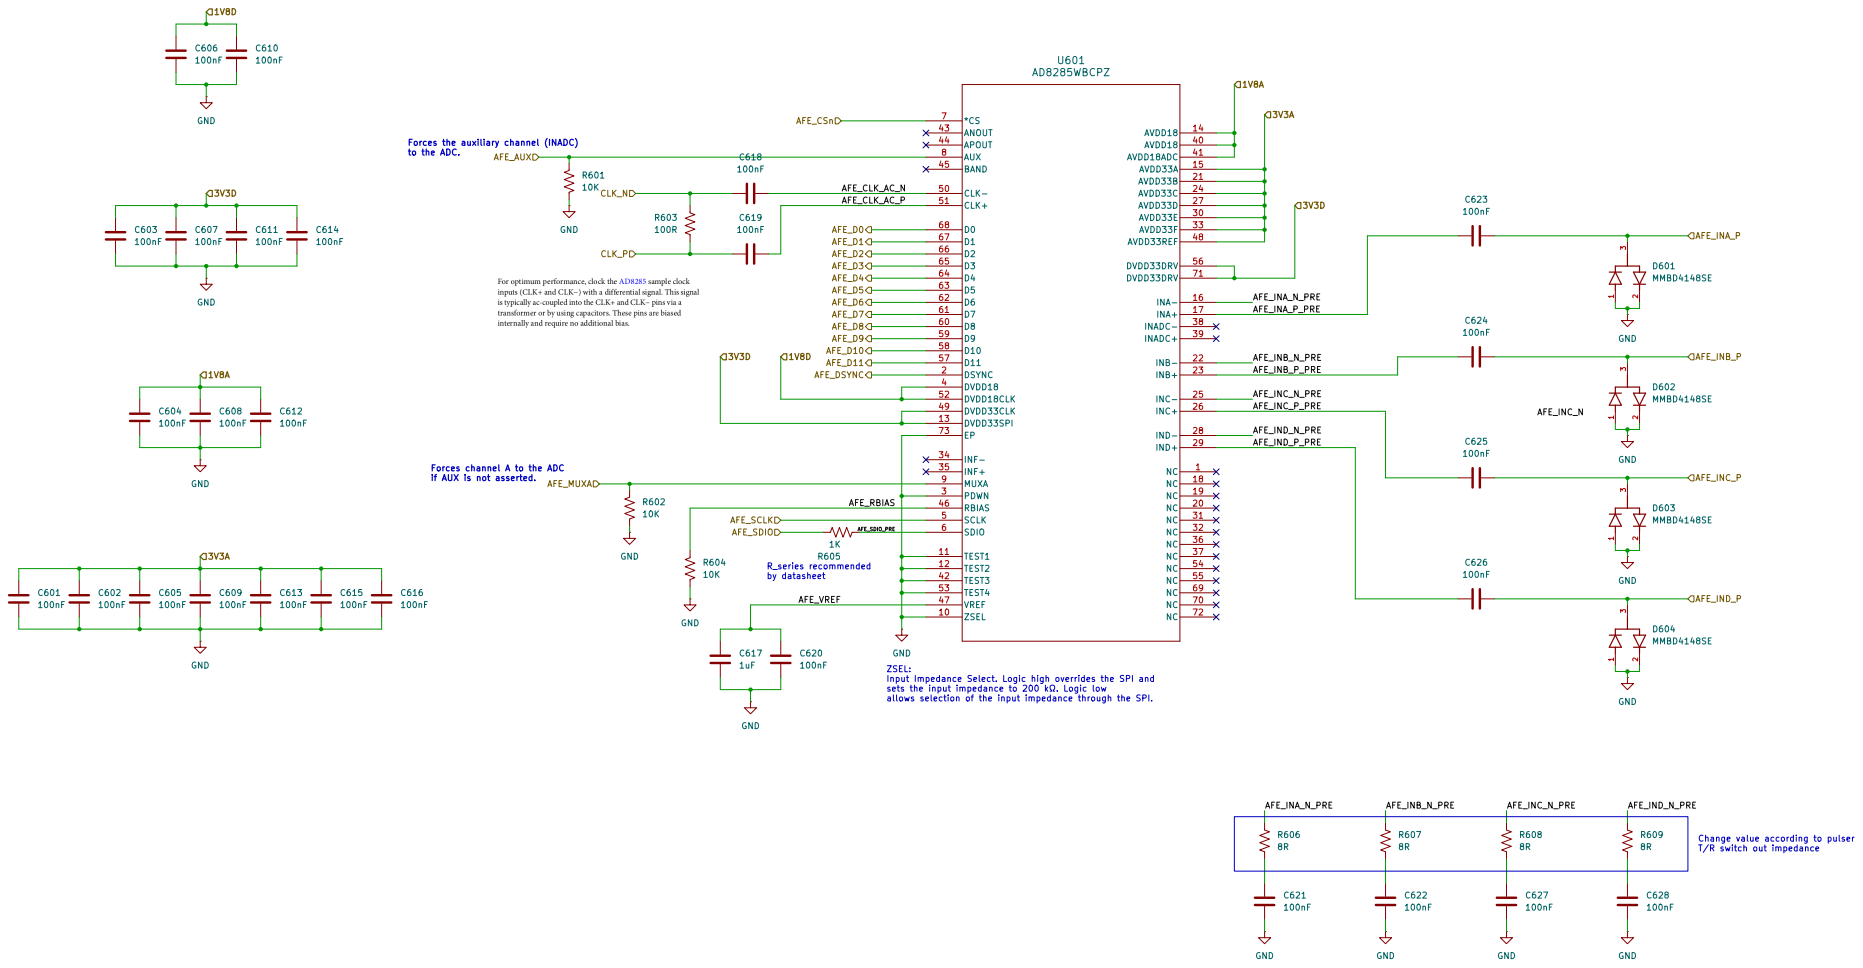
[picture p44: page 8]




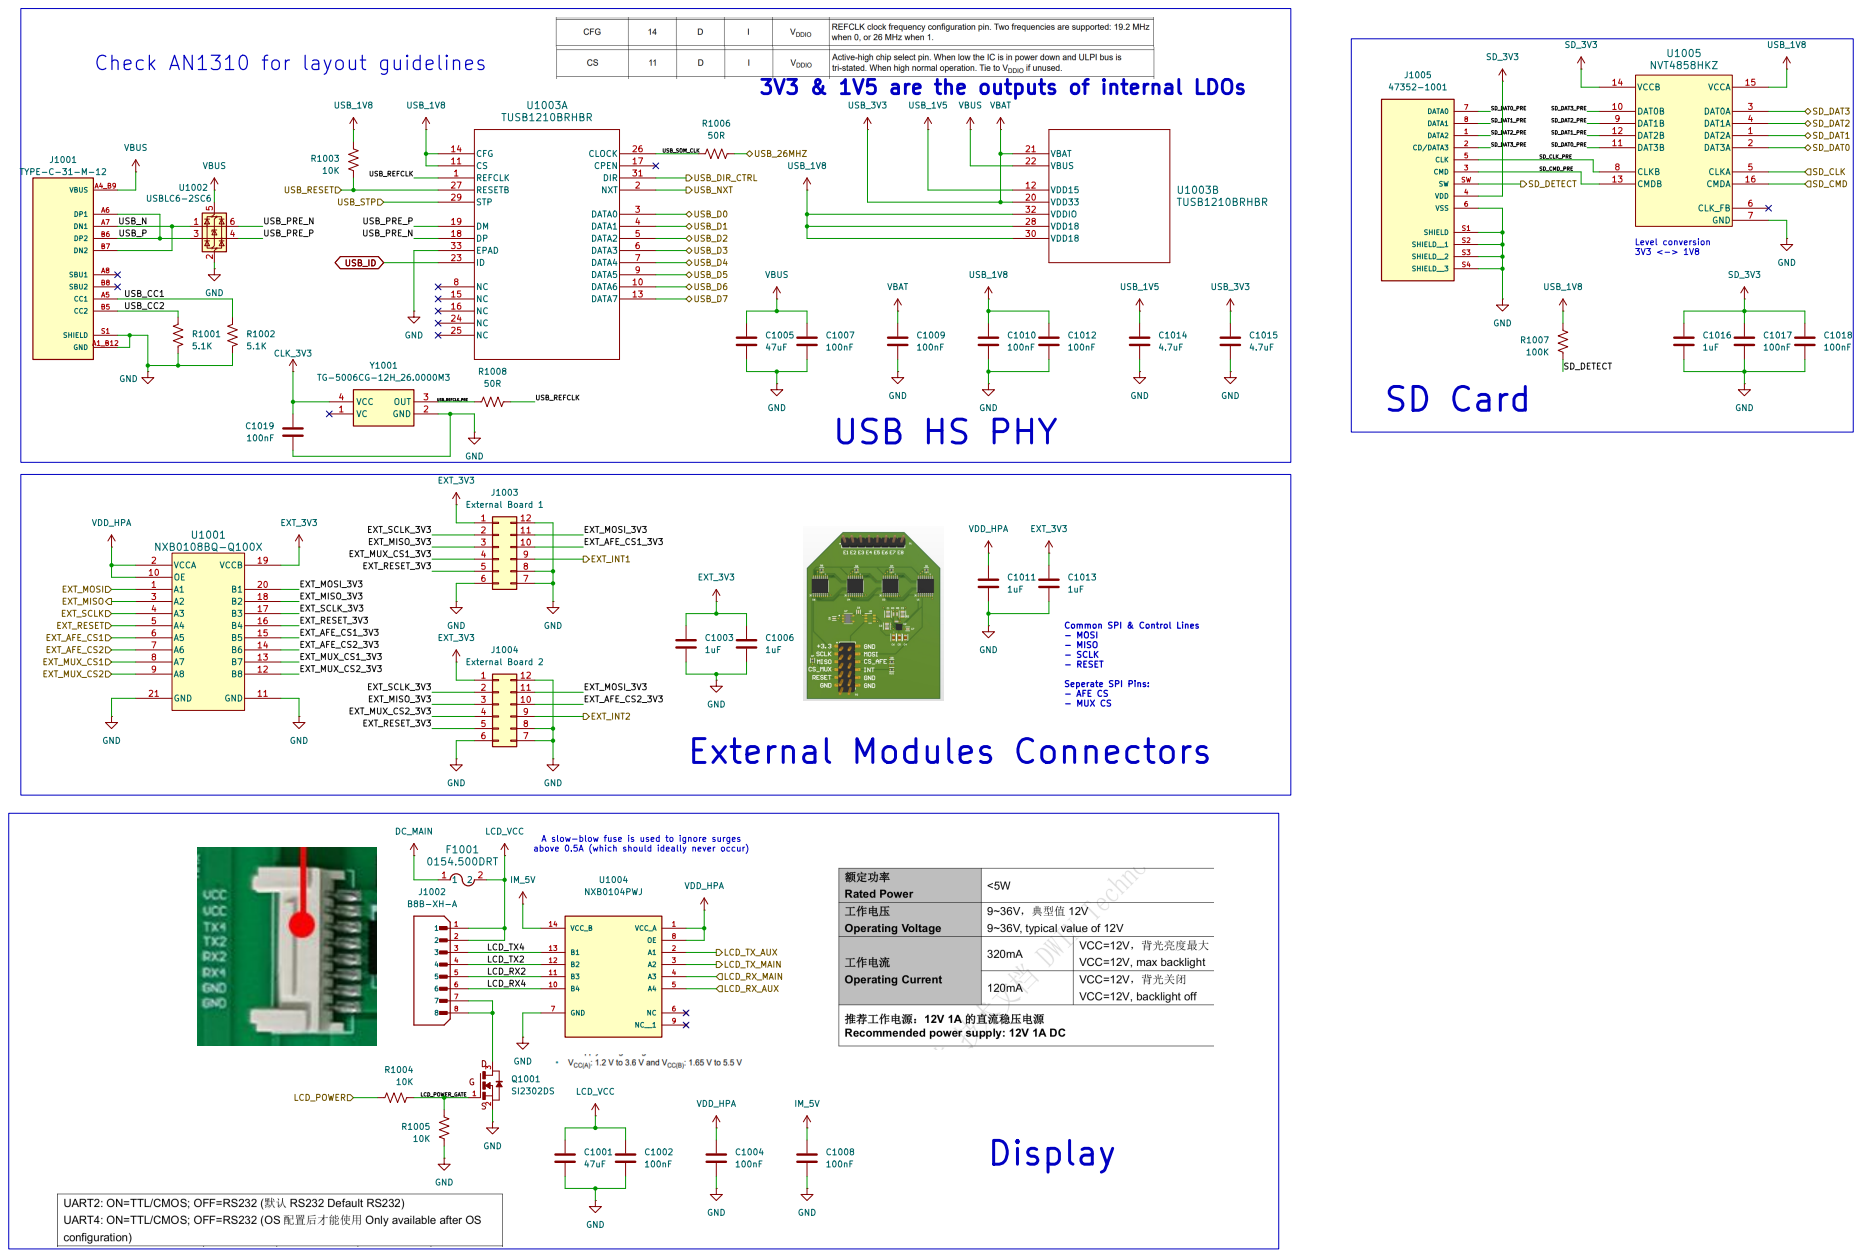
[picture p45: page 12]

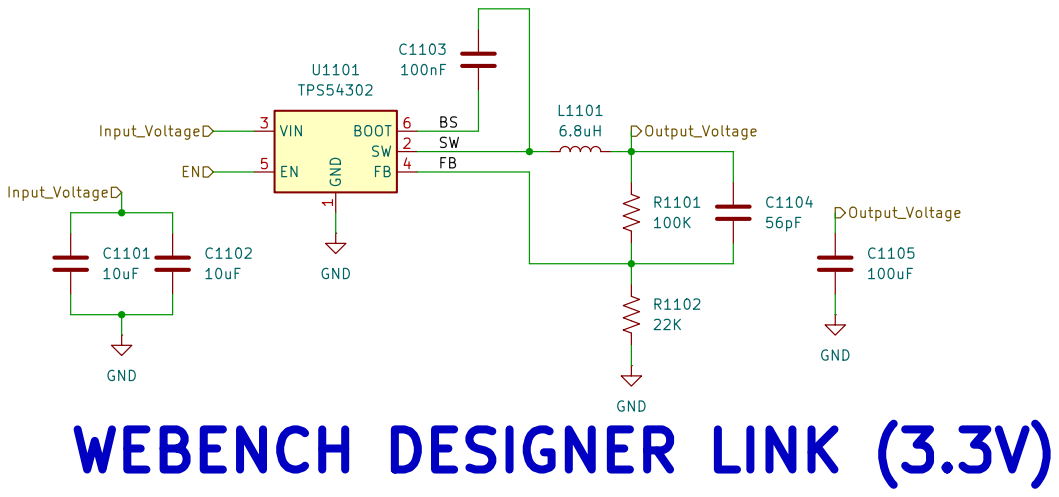
[picture p46: page 13]

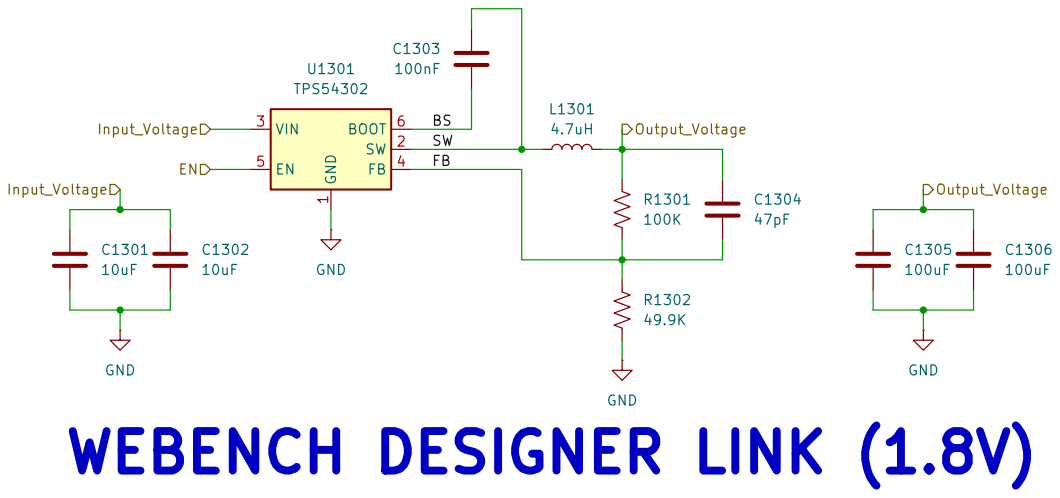
[picture p47: page 14]

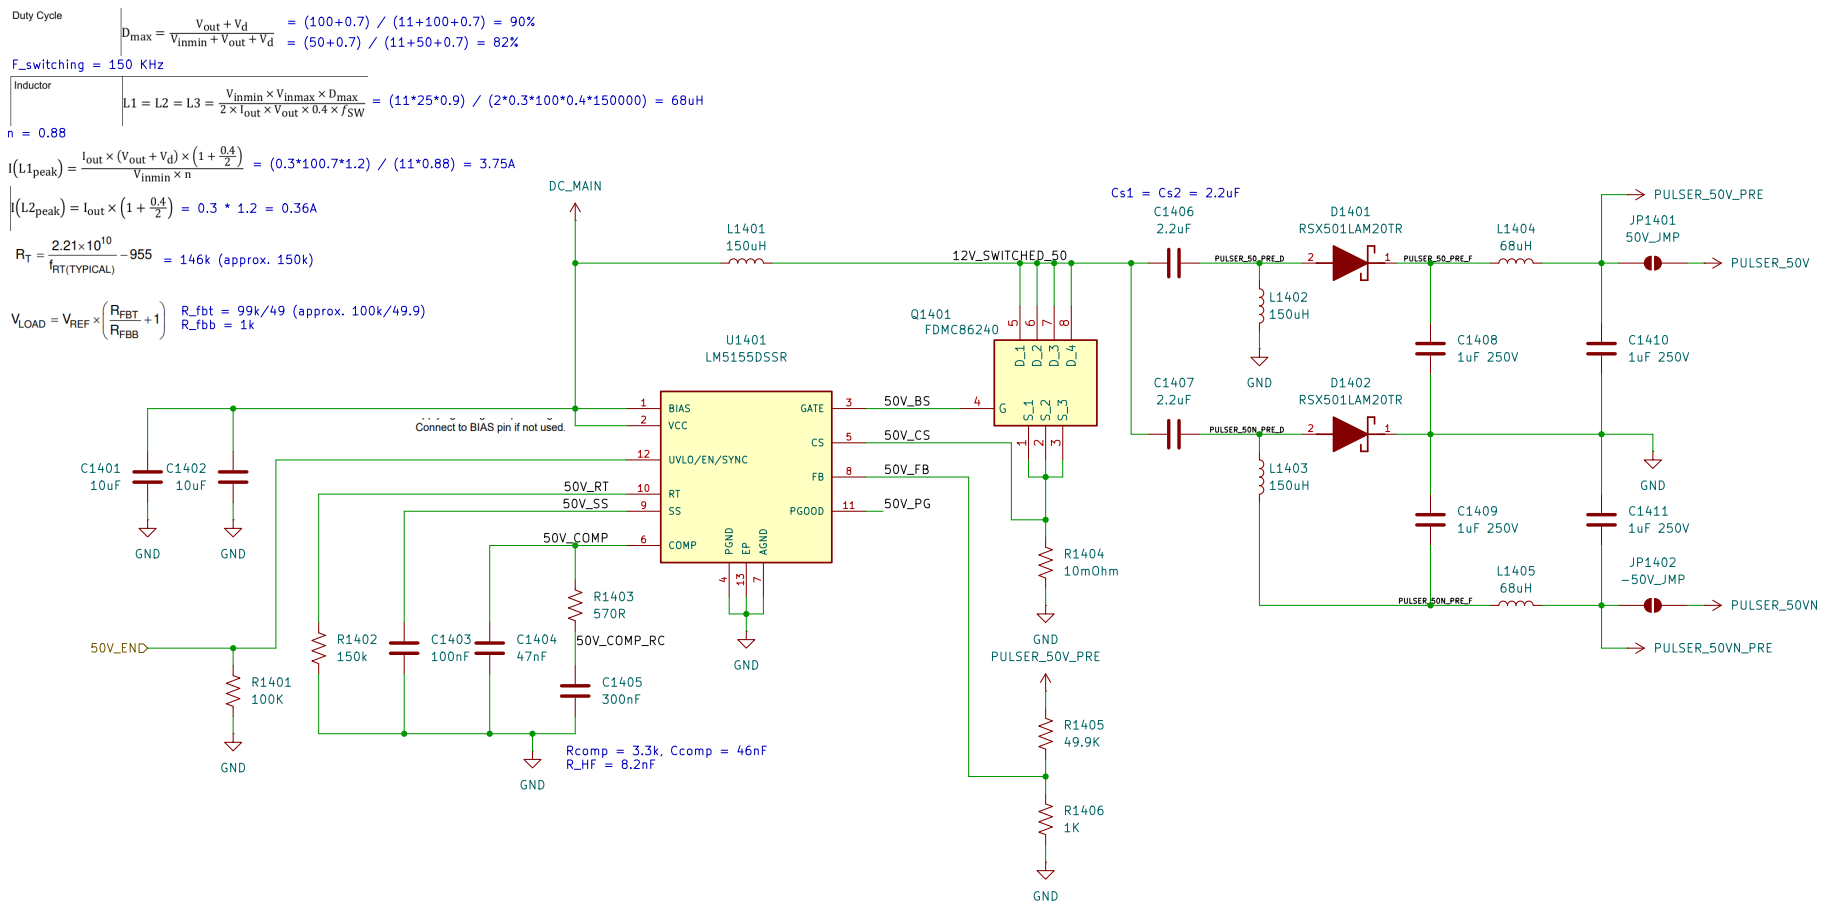
[picture p48: page 15]

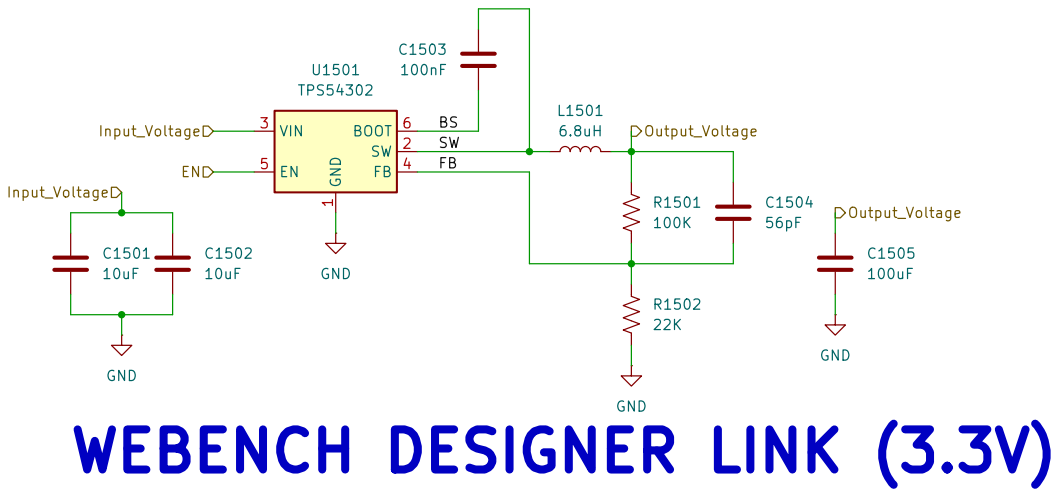
[picture p49: page 16]

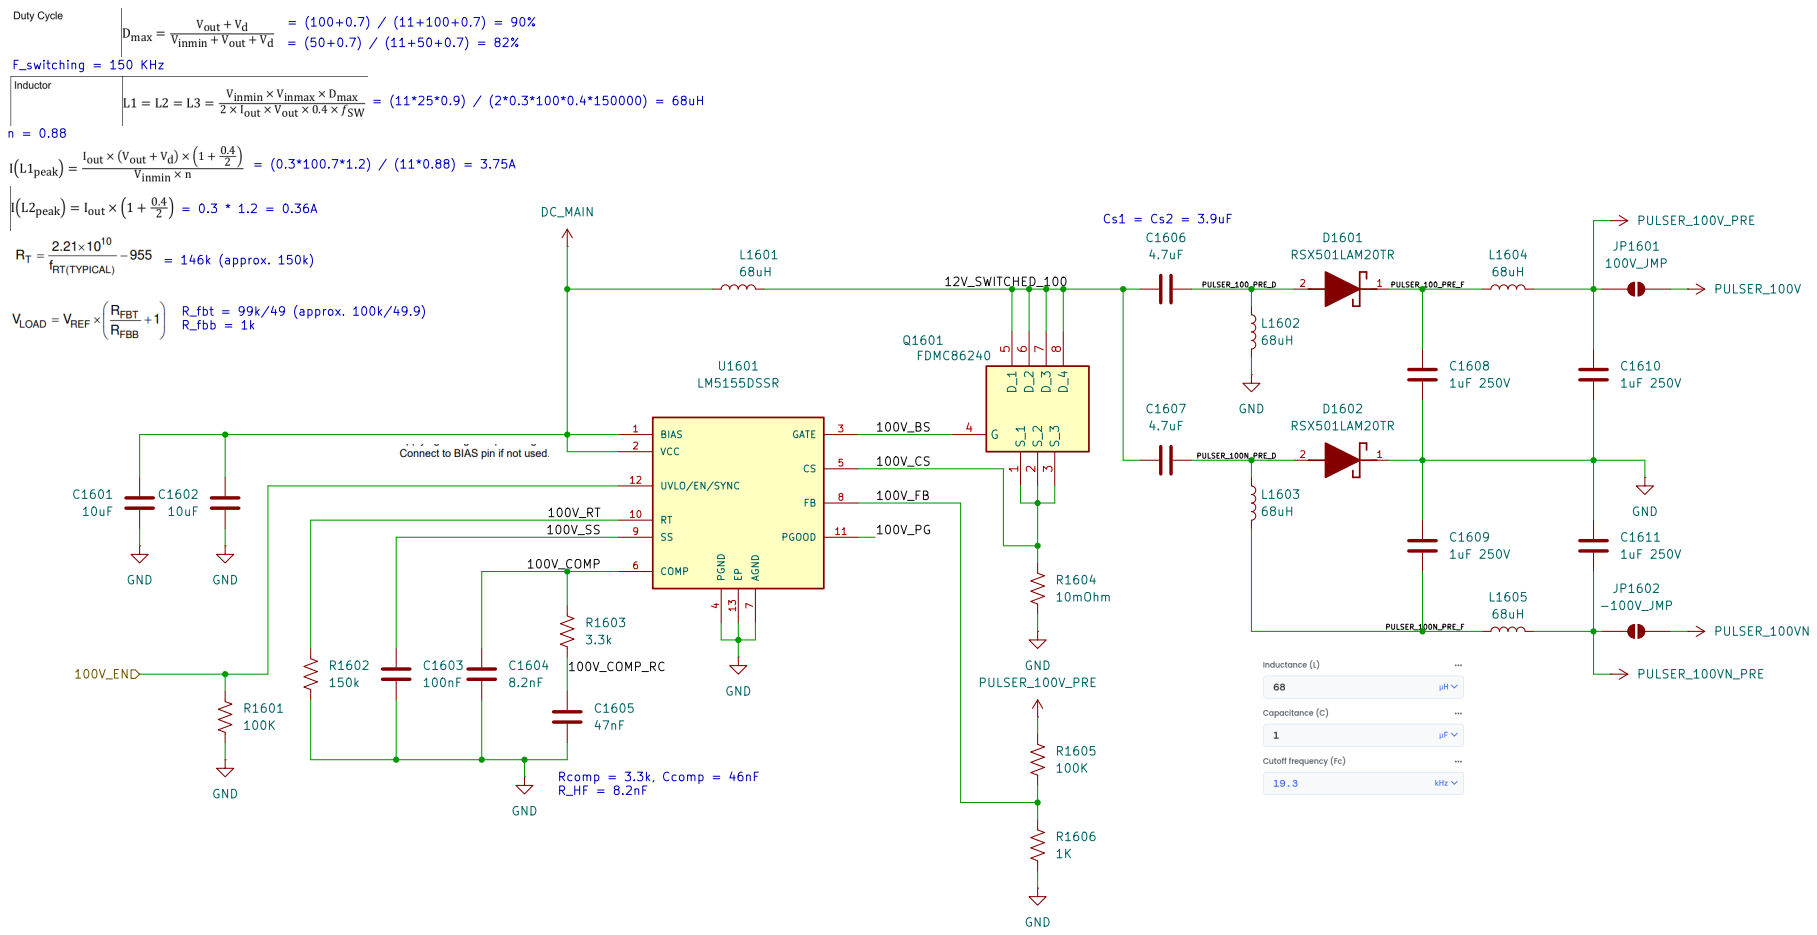
[picture p50: page 17]

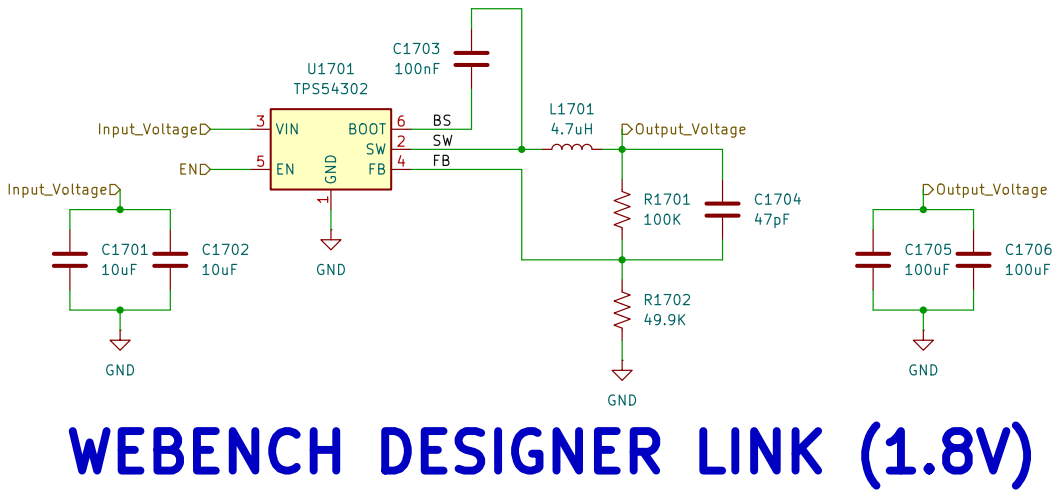
[picture p51: page 18]

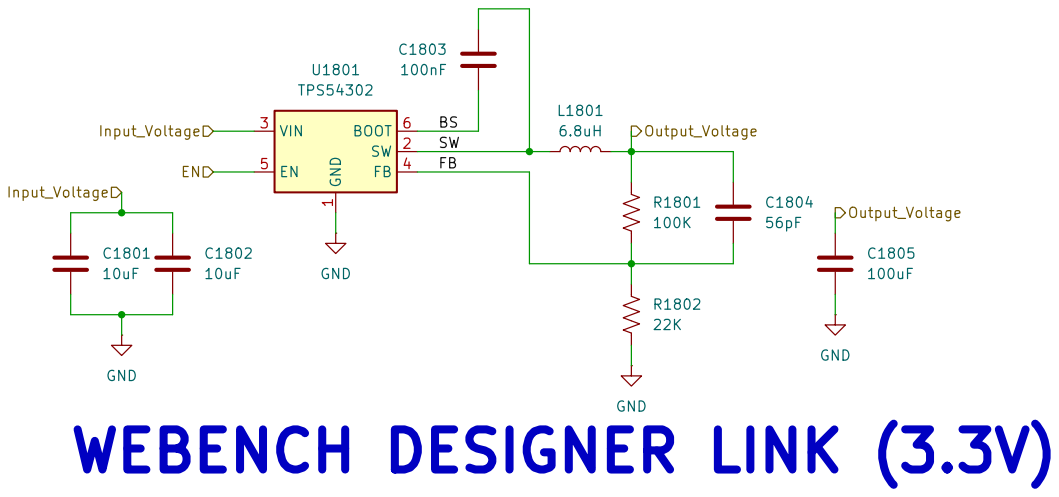
[picture p52: page 19]
