yusufElnady/Medical-Imager/(list of files, drawings)

Other design files:
AltiumProject/MedicalImager.PrjPcb
AltiumProject/Schematics/Main.SchDoc
AltiumProject/Schematics/Power.SchDoc
AltiumProject/Schematics/RX.SchDoc
AltiumProject/Schematics/TX.SchDoc
