yusufElnady/Medical-Imager/MedicalImager.kicad_pcb

## KiCad design MedicalImager.kicad_pcb (2026-11-13)

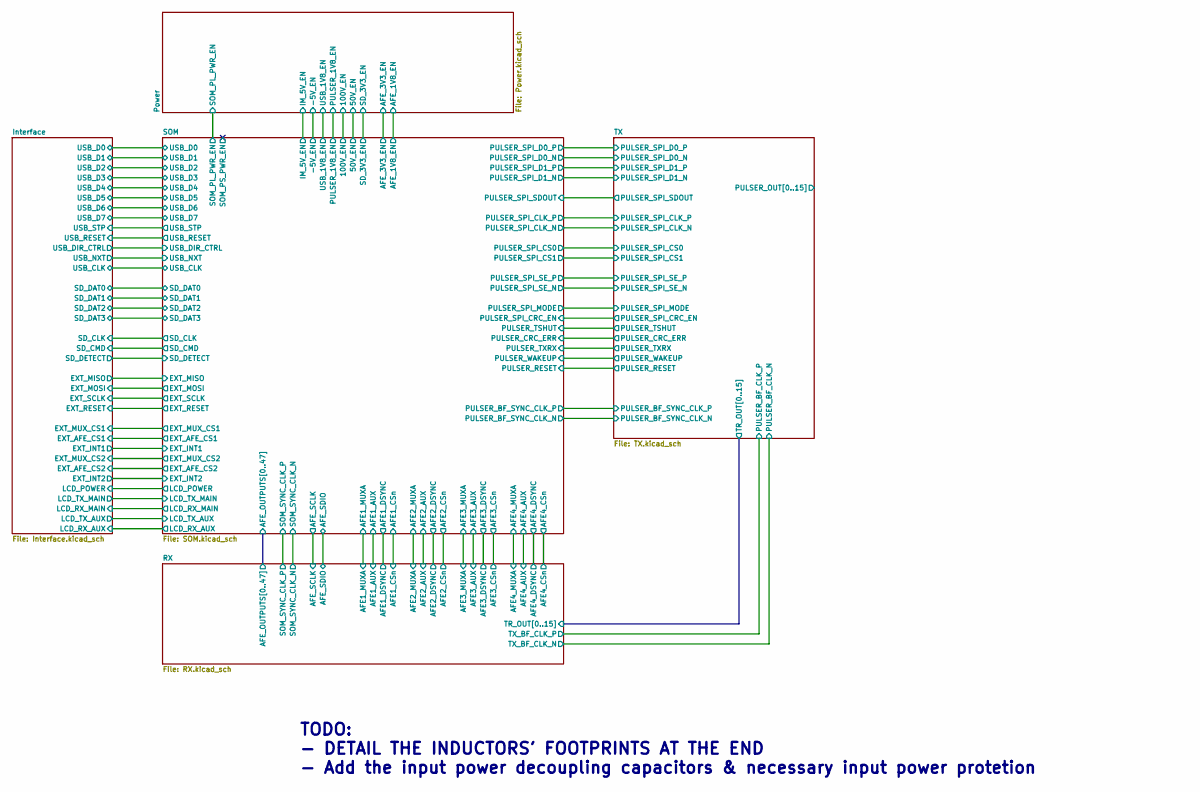
[picture p57: schematic MedicalImager.kicad_sch]

Notes on the sheet:
TODO: - DETAIL THE INDUCTORS' FOOTPRINTS AT THE END - Add the input power decoupling capacitors & necessary input power protetion

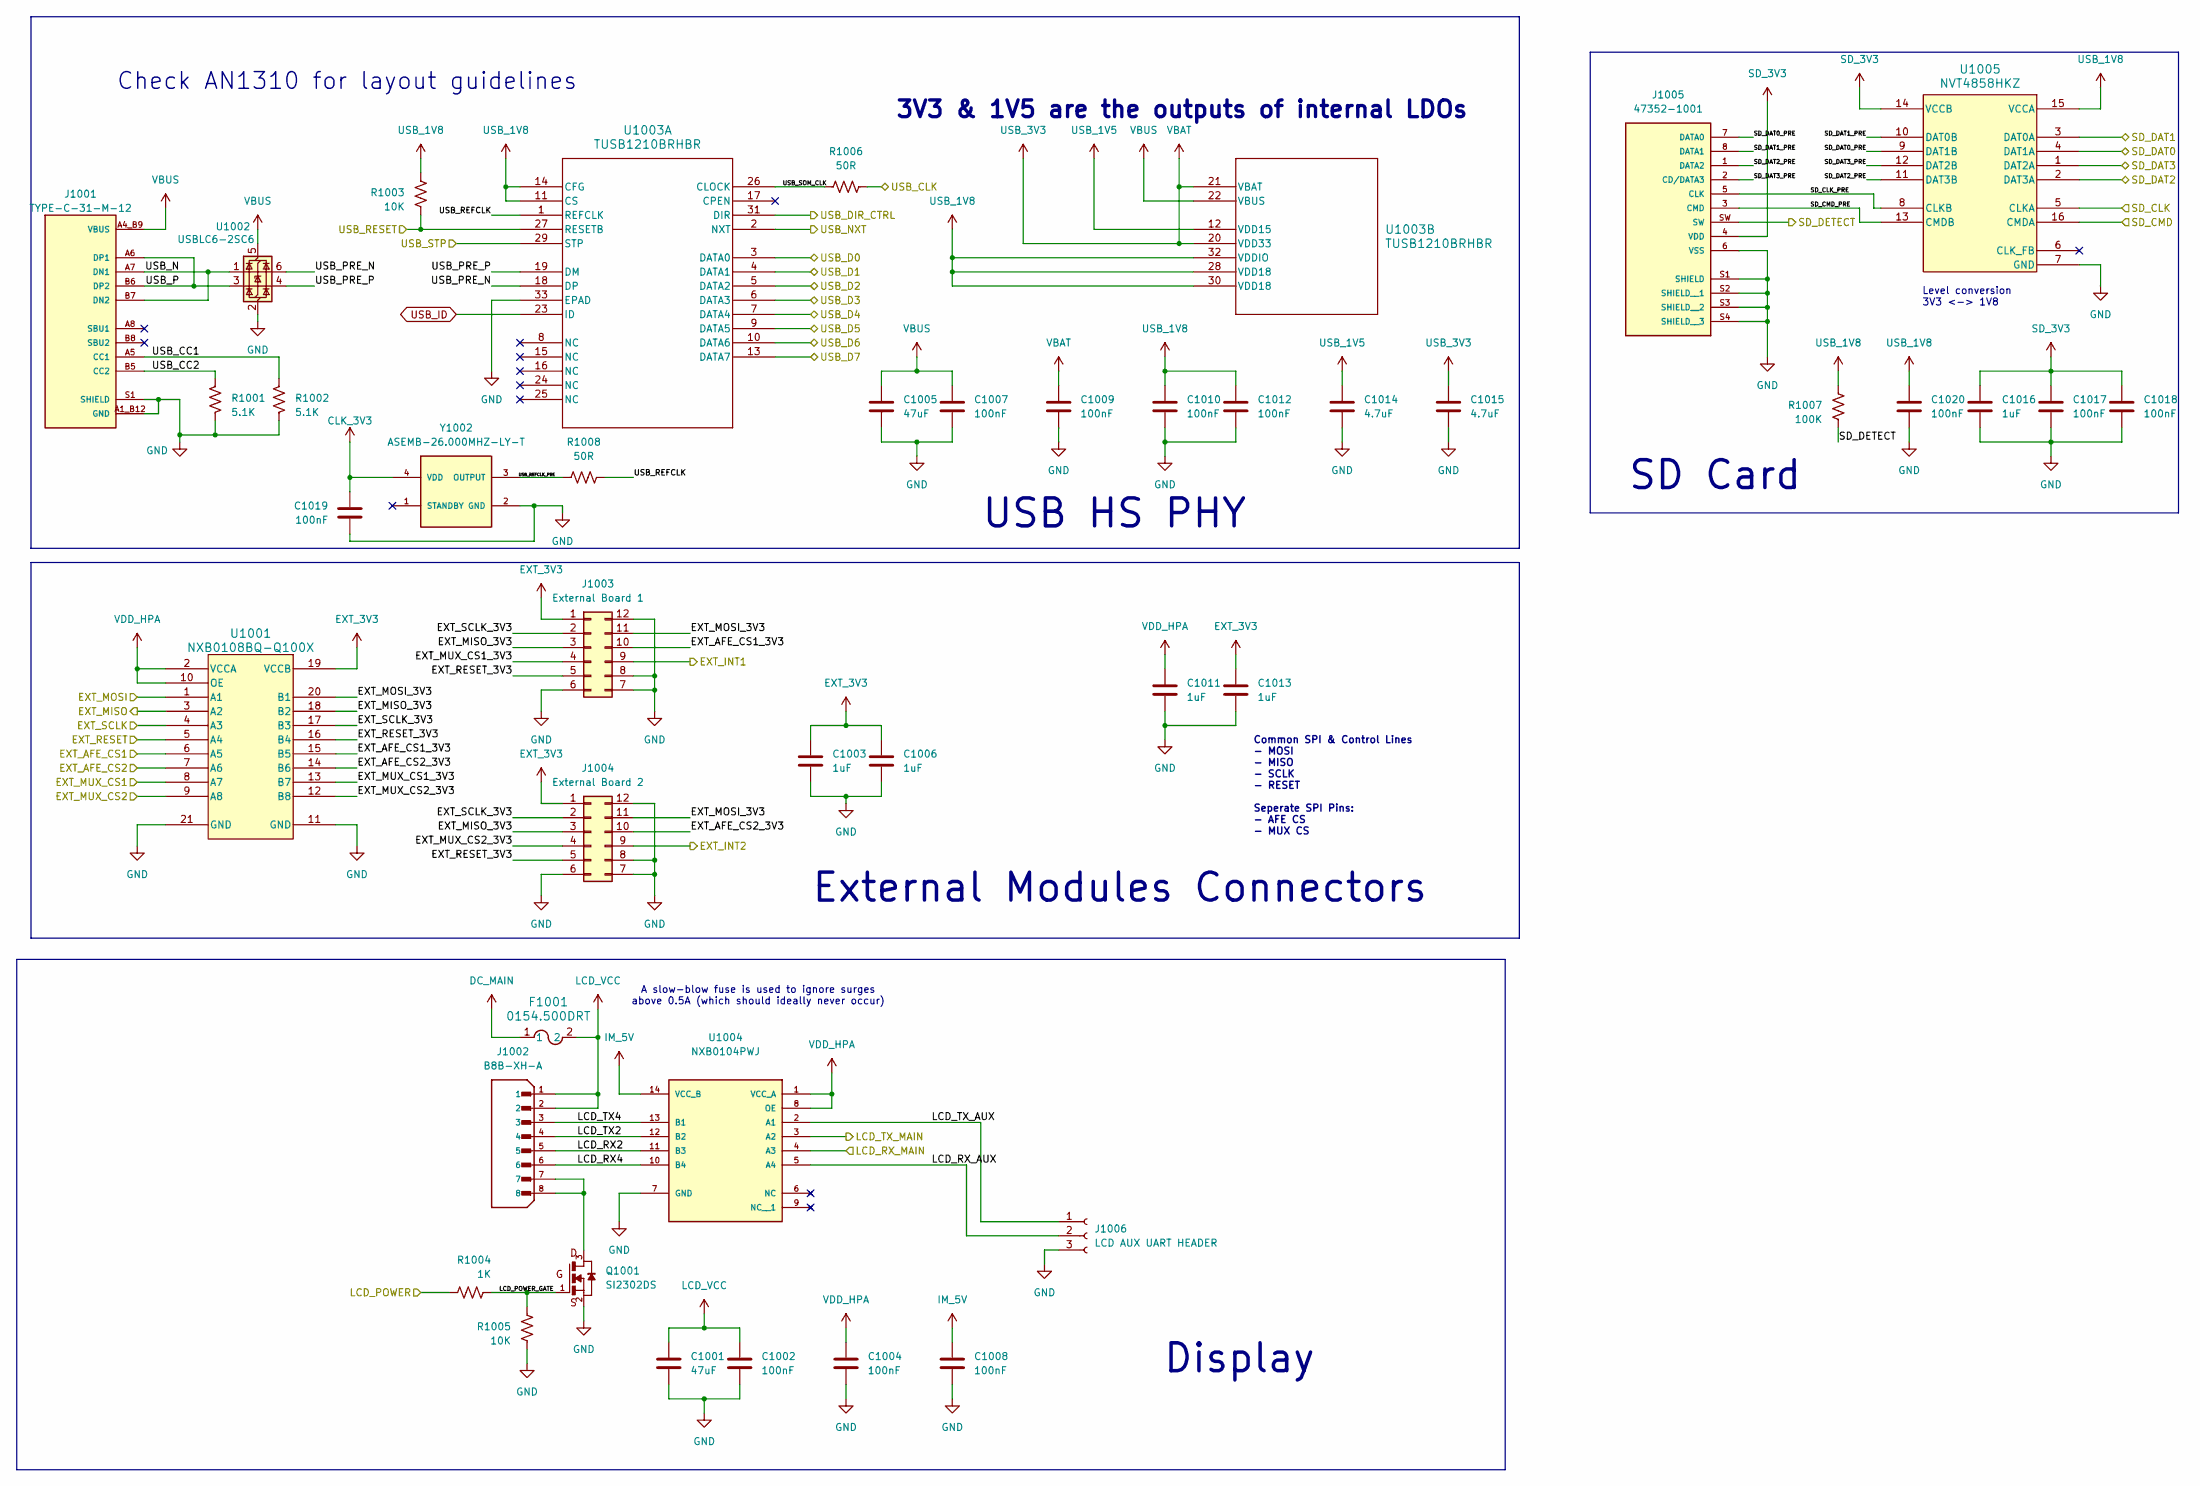
[picture p58: schematic Interface.kicad_sch]

Parts:
C1001, C1005: 47uF; C_0805_2012Metric
C1002: 100nF; C_0805_2012Metric
C1003, C1006, C1011, C1013, C1016: 1uF; C_0402_1005Metric
C1004, C1007, C1008, C1009, C1010, C1012, C1017, C1018, C1019, C1020: 100nF; C_0402_1005Metric
C1014, C1015: 4.7uF; C_0402_1005Metric
F1001: 0154.500DRT; 0154Series_LTF
J1001: TYPE-C-31-M-12; HRO_TYPE-C-31-M-12; PARTREV 2020.12.08
J1002: B8B-XH-A; JST_B8B-XH-A; PARTREV 7/4/21
J1003: External Board 1; PinHeader_2x06_P2.54mm_Vertical
J1004: External Board 2; PinHeader_2x06_P2.54mm_Vertical
J1005: 47352-1001; MOLEX_47352-1001; PARTREV K
J1006: LCD AUX UART HEADER; PinSocket_1x03_P2.54mm_Vertical
Q1001: SI2302DS; SOT23-3_TO-236AB
R1001, R1002: 5.1K; R_0402_1005Metric
R1003, R1005: 10K; R_0402_1005Metric
R1004: 1K; R_0402_1005Metric
R1006, R1008: 50R; R_0402_1005Metric
R1007: 100K; R_0402_1005Metric
U1001: NXB0108BQ-Q100X; DHVQFN20_SOT764-1_NEX
U1002: USBLC6-2SC6; SOT-23-6
U1003: TUSB1210BRHBR; RHB32_3P45X3P45
U1004: NXB0104PWJ; SOP65P640X120-14N; PARTREV 4
U1005: NVT4858HKZ; NVT4858_NXP
Y1002: ASEMB-26.000MHZ-LY-T; XTAL_ASEMB-26.000MHZ-LY-T; PARTREV 1.4.2021

Connections:
/Interface/EXT_AFE_CS1: U1001.6 (A5); also elsewhere on the board
/Interface/EXT_AFE_CS1_3V3: J1003.10, U1001.15 (B5)
/Interface/EXT_AFE_CS2: U1001.7 (A6); also elsewhere on the board
/Interface/EXT_AFE_CS2_3V3: J1004.10, U1001.14 (B6)
/Interface/EXT_INT1: J1003.9; also elsewhere on the board
/Interface/EXT_INT2: J1004.9; also elsewhere on the board
/Interface/EXT_MISO: U1001.3 (A2); also elsewhere on the board
/Interface/EXT_MISO_3V3: J1003.3, J1004.3, U1001.18 (B2)
/Interface/EXT_MOSI: U1001.1 (A1); also elsewhere on the board
/Interface/EXT_MOSI_3V3: J1003.11, J1004.11, U1001.20 (B1)
/Interface/EXT_MUX_CS1: U1001.8 (A7); also elsewhere on the board
/Interface/EXT_MUX_CS1_3V3: J1003.4, U1001.13 (B7)
/Interface/EXT_MUX_CS2: U1001.9 (A8); also elsewhere on the board
/Interface/EXT_MUX_CS2_3V3: J1004.4, U1001.12 (B8)
/Interface/EXT_RESET: U1001.5 (A4); also elsewhere on the board
/Interface/EXT_RESET_3V3: J1003.5, J1004.5, U1001.16 (B4)
/Interface/EXT_SCLK: U1001.4 (A3); also elsewhere on the board
/Interface/EXT_SCLK_3V3: J1003.2, J1004.2, U1001.17 (B3)
/Interface/LCD_POWER: R1004.2; also elsewhere on the board
/Interface/LCD_POWER_GATE: Q1001.1, R1004.1, R1005.1
/Interface/LCD_RX2: J1002.5, U1004.11 (B3)
/Interface/LCD_RX4: J1002.6, U1004.10 (B4)
/Interface/LCD_RX_AUX: J1006.2, U1004.5 (A4)
/Interface/LCD_RX_MAIN: U1004.4 (A3); also elsewhere on the board
/Interface/LCD_TX2: J1002.4, U1004.12 (B2)
/Interface/LCD_TX4: J1002.3, U1004.13 (B1)
/Interface/LCD_TX_AUX: J1006.1, U1004.2 (A1)
/Interface/LCD_TX_MAIN: U1004.3 (A2); also elsewhere on the board
/Interface/SD_CLK: U1005.5 (CLKA); also elsewhere on the board
/Interface/SD_CLK_PRE: J1005.5 (CLK), U1005.8 (CLKB)
/Interface/SD_CMD: U1005.16 (CMDA); also elsewhere on the board
/Interface/SD_CMD_PRE: J1005.3 (CMD), U1005.13 (CMDB)
/Interface/SD_DAT0: U1005.4 (DAT1A); also elsewhere on the board
/Interface/SD_DAT0_PRE: J1005.7 (DATA0), U1005.9 (DAT1B)
/Interface/SD_DAT1: U1005.3 (DAT0A); also elsewhere on the board
/Interface/SD_DAT1_PRE: J1005.8 (DATA1), U1005.10 (DAT0B)
/Interface/SD_DAT2: U1005.2 (DAT3A); also elsewhere on the board
/Interface/SD_DAT2_PRE: J1005.1 (DATA2), U1005.11 (DAT3B)
/Interface/SD_DAT3: U1005.1 (DAT2A); also elsewhere on the board
/Interface/SD_DAT3_PRE: J1005.2 (CD/DATA3), U1005.12 (DAT2B)
/Interface/SD_DETECT: J1005.SW, R1007.2; also elsewhere on the board
/Interface/USB_CC1: J1001.A5 (CC1), R1002.1
/Interface/USB_CC2: J1001.B5 (CC2), R1001.1
/Interface/USB_CLK: R1006.1; also elsewhere on the board
/Interface/USB_D0: U1003.3 (DATA0); also elsewhere on the board
/Interface/USB_D1: U1003.4 (DATA1); also elsewhere on the board
/Interface/USB_D2: U1003.5 (DATA2); also elsewhere on the board
/Interface/USB_D3: U1003.6 (DATA3); also elsewhere on the board
/Interface/USB_D4: U1003.7 (DATA4); also elsewhere on the board
/Interface/USB_D5: U1003.9 (DATA5); also elsewhere on the board
/Interface/USB_D6: U1003.10 (DATA6); also elsewhere on the board
/Interface/USB_D7: U1003.13 (DATA7); also elsewhere on the board
/Interface/USB_DIR_CTRL: U1003.31 (DIR); also elsewhere on the board
/Interface/USB_N: J1001.A7 (DN1), J1001.B7 (DN2), U1002.1 (I/O1)
/Interface/USB_NXT: U1003.2 (NXT); also elsewhere on the board
/Interface/USB_P: J1001.A6 (DP1), J1001.B6 (DP2), U1002.3 (I/O2)
/Interface/USB_PRE_N: U1002.6 (I/O1), U1003.18 (DP)
/Interface/USB_PRE_P: U1002.4 (I/O2), U1003.19 (DM)
/Interface/USB_REFCLK: R1008.1, U1003.1 (REFCLK)
/Interface/USB_REFCLK_PRE: R1008.2, Y1002.3 (OUTPUT)
/Interface/USB_RESET: R1003.2, U1003.27 (RESETB); also elsewhere on the board
/Interface/USB_SOM_CLK: R1006.2, U1003.26 (CLOCK)
/Interface/USB_STP: U1003.29 (STP); also elsewhere on the board
CLK_3V3: C1019.2, Y1002.4 (VDD); also elsewhere on the board
DC_MAIN: F1001.1; also elsewhere on the board
EXT_3V3: C1003.1, C1006.1, C1013.1, J1003.1, J1004.1, U1001.19 (VCCB); also elsewhere on the board
GND: C1001.2, C1002.1, C1003.2, C1004.1, C1005.2, C1006.2, C1007.1, C1008.1, C1009.1, C1010.1, C1011.2, C1012.1, C1013.2, C1014.1, C1015.1, C1016.2, C1017.2, C1018.2, C1019.1, C1020.2, J1001.A1_B12 (GND), J1001.B1_A12 (GND), J1001.S1 (SHIELD), J1001.S2 (SHIELD), J1001.S3 (SHIELD), J1001.S4 (SHIELD), J1003.6, J1003.7, J1003.8, J1003.12, J1004.6, J1004.7, J1004.8, J1004.12, J1005.6 (VSS), J1005.S1 (SHIELD), J1005.S2 (SHIELD__1), J1005.S3 (SHIELD__2), J1005.S4 (SHIELD__3), J1006.3, Q1001.2, R1001.2, R1002.2, R1005.2, U1001.11 (GND), U1001.21 (GND), U1002.2 (GND), U1003.33 (EPAD), U1004.7 (GND), U1005.7 (GND), Y1002.2 (GND); also elsewhere on the board
IM_5V: C1008.2, U1004.14 (VCC_B); also elsewhere on the board
LCD_VCC: C1001.1, C1002.2, F1001.2, J1002.1, J1002.2
unnamed: J1002.7, J1002.8, Q1001.3
SD_3V3: C1016.1, C1017.1, C1018.1, J1005.4 (VDD), U1005.14 (VCCB); also elsewhere on the board
USB_1V5: C1014.2, U1003.12 (VDD15)
USB_1V8: C1010.2, C1012.2, C1020.1, R1003.1, R1007.1, U1003.11 (CS), U1003.14 (CFG), U1003.28 (VDD18), U1003.30 (VDD18), U1003.32 (VDDIO), U1005.15 (VCCA); also elsewhere on the board
USB_3V3: C1009.2, C1015.2, U1003.20 (VDD33), U1003.21 (VBAT)
USB_ID: U1003.23 (ID)
VBUS: C1005.1, C1007.2, J1001.A4_B9 (VBUS), J1001.B4_A9 (VBUS), U1002.5 (VBUS), U1003.22 (VBUS)
VDD_HPA: C1004.2, C1011.1, U1001.2 (VCCA), U1001.10 (OE), U1004.1 (VCC_A), U1004.8 (OE); also elsewhere on the board

Notes on the sheet:
Level conversion 3V3 <-> 1V8
USB HS PHY
3V3 & 1V5 are the outputs of internal LDOs
SD Card
Display
Check AN1310 for layout guidelines
External Modules Connectors
A slow-blow fuse is used to ignore surges above 0.5A (which should ideally never occur)
Common SPI & Control Lines - MOSI - MISO - SCLK - RESET Seperate SPI Pins: - AFE CS - MUX CS

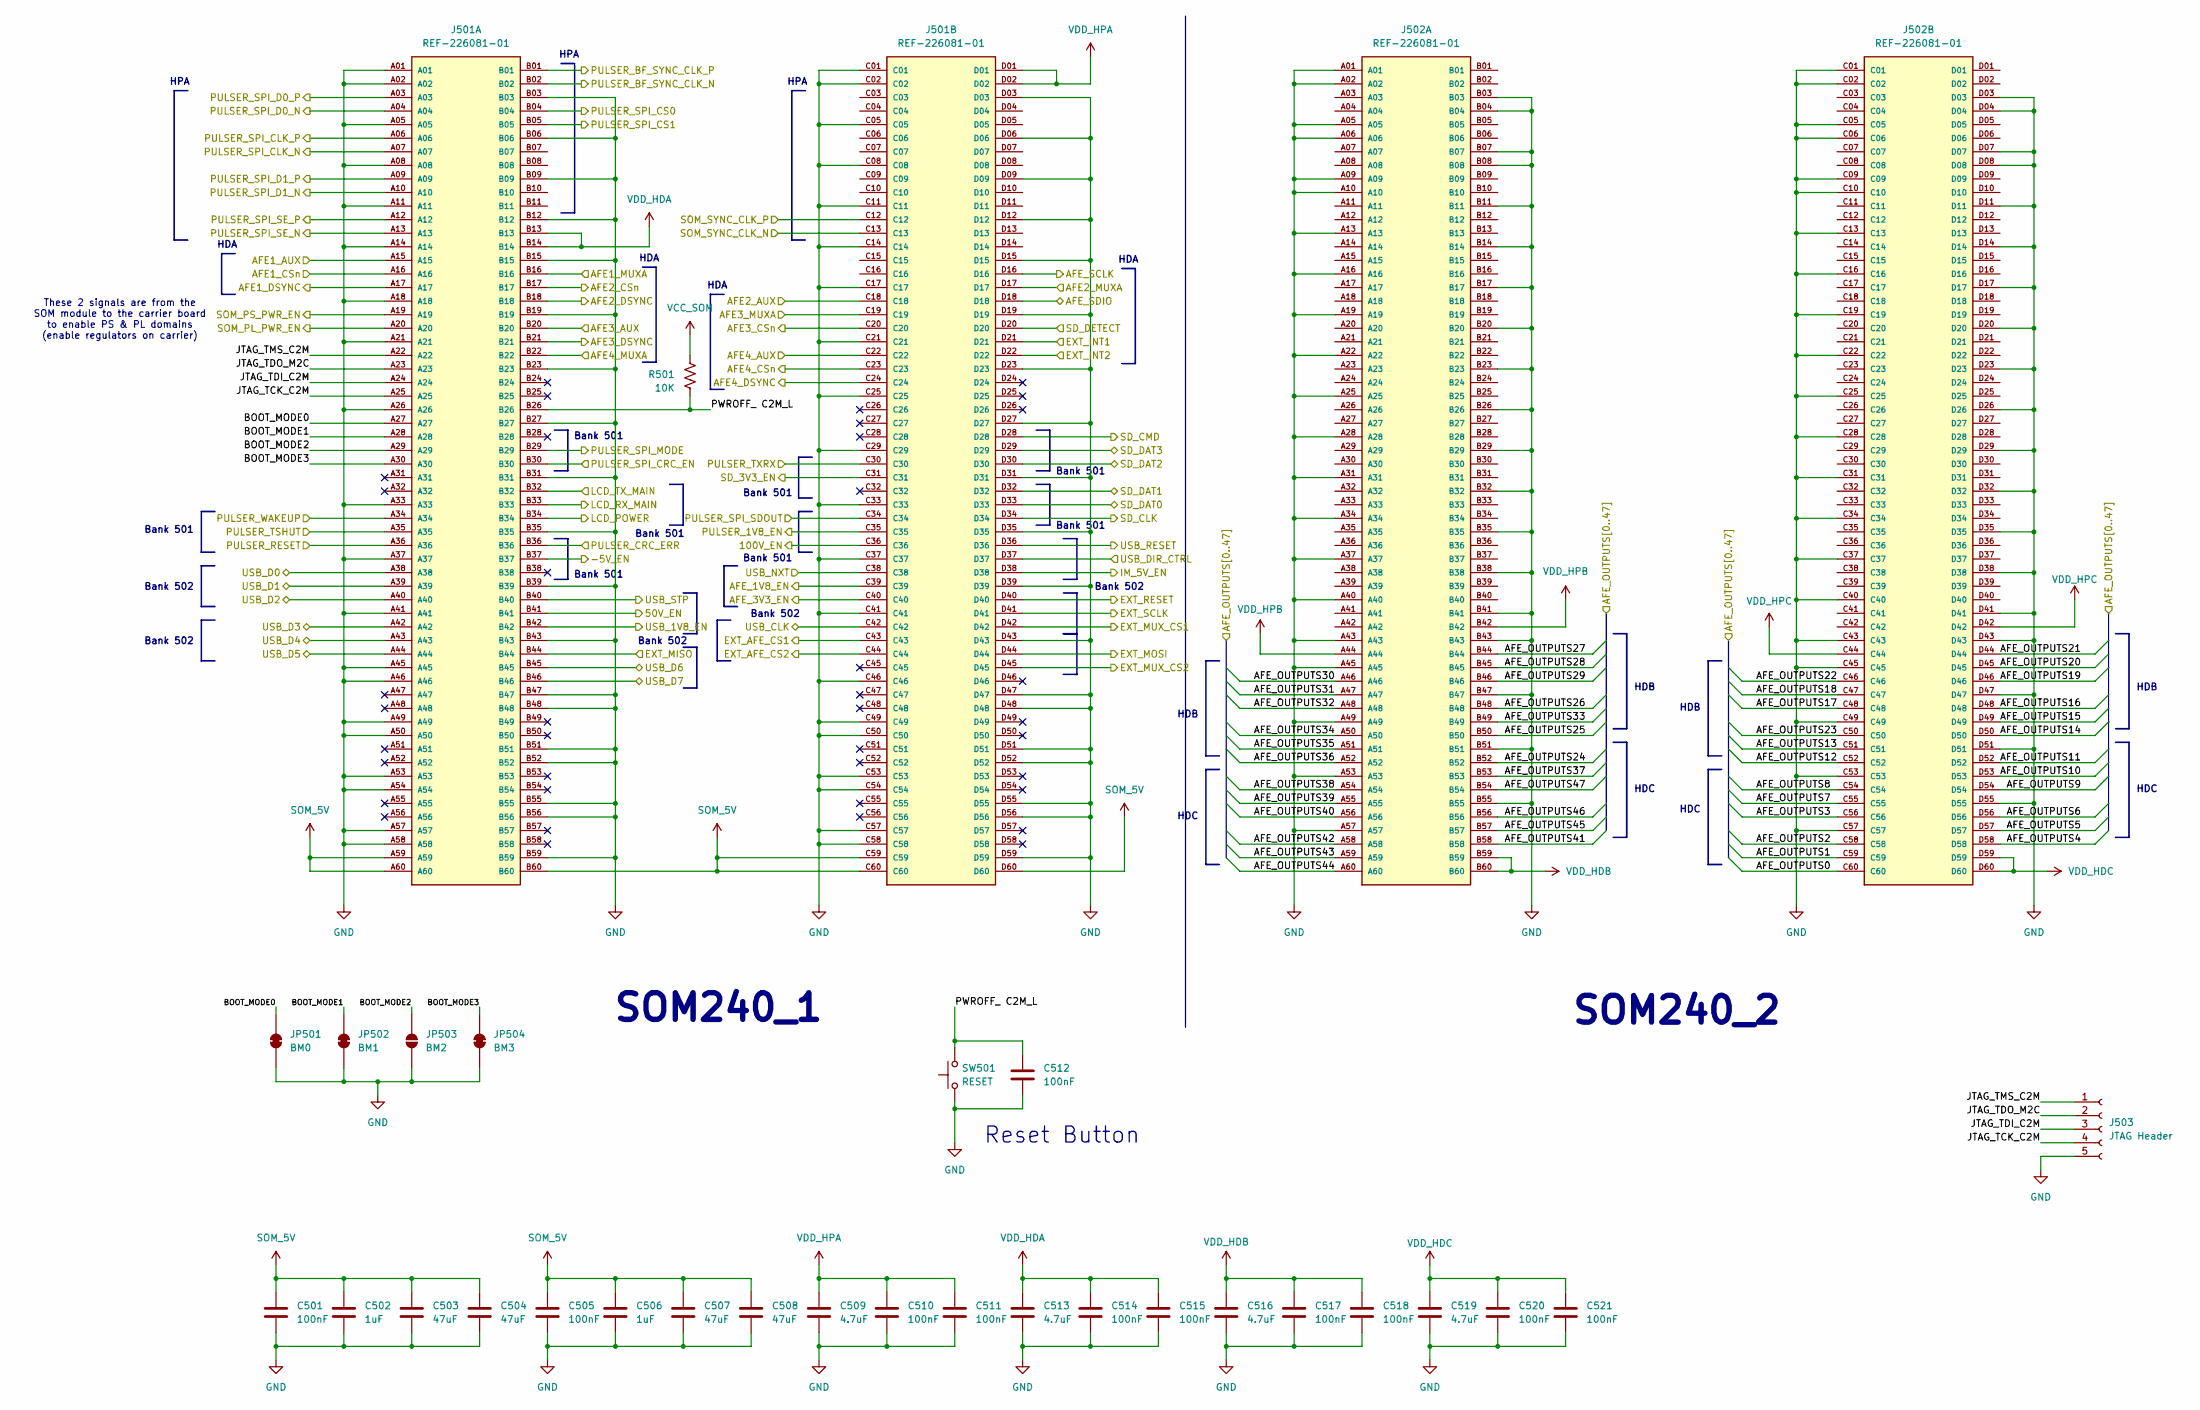
[picture p59: schematic SOM.kicad_sch]

Parts:
C501, C505, C510, C511, C512, C514, C515, C517, C518, C520, C521: 100nF; C_0402_1005Metric
C502, C506: 1uF; C_0402_1005Metric
C503, C504, C507, C508: 47uF; C_0805_2012Metric
C509, C513, C516, C519: 4.7uF; C_0805_2012Metric
J501, J502: REF-226081-01; SAMTEC_REF-226081-01; PARTREV C
J503: JTAG Header; PinSocket_1x05_P2.54mm_Vertical
JP501: BM0; SolderJumper-2_P1.3mm_Bridged_RoundedPad1.0x1.5mm
JP502: BM1; SolderJumper-2_P1.3mm_Bridged_RoundedPad1.0x1.5mm
JP503: BM2; SolderJumper-2_P1.3mm_Open_TrianglePad1.0x1.5mm
JP504: BM3; SolderJumper-2_P1.3mm_Bridged_RoundedPad1.0x1.5mm
R501: 10K; R_0402_1005Metric
SW501: RESET; SW_Push_SPST_NO_Alps_SKRK

Connections:
/Interface/EXT_AFE_CS1: J501.C43; also elsewhere on the board
/Interface/EXT_AFE_CS2: J501.C44; also elsewhere on the board
/Interface/EXT_INT1: J501.D21; also elsewhere on the board
/Interface/EXT_INT2: J501.D22; also elsewhere on the board
/Interface/EXT_MISO: J501.B44; also elsewhere on the board
/Interface/EXT_MOSI: J501.D44; also elsewhere on the board
/Interface/EXT_MUX_CS1: J501.D42; also elsewhere on the board
/Interface/EXT_MUX_CS2: J501.D45; also elsewhere on the board
/Interface/EXT_RESET: J501.D40; also elsewhere on the board
/Interface/EXT_SCLK: J501.D41; also elsewhere on the board
/Interface/LCD_POWER: J501.B34; also elsewhere on the board
/Interface/LCD_RX_MAIN: J501.B33; also elsewhere on the board
/Interface/LCD_TX_MAIN: J501.B32; also elsewhere on the board
/Interface/SD_CLK: J501.D34; also elsewhere on the board
/Interface/SD_CMD: J501.D28; also elsewhere on the board
/Interface/SD_DAT0: J501.D33; also elsewhere on the board
/Interface/SD_DAT1: J501.D32; also elsewhere on the board
/Interface/SD_DAT2: J501.D30; also elsewhere on the board
/Interface/SD_DAT3: J501.D29; also elsewhere on the board
/Interface/SD_DETECT: J501.D20; also elsewhere on the board
/Interface/USB_CLK: J501.C42; also elsewhere on the board
/Interface/USB_D0: J501.A38; also elsewhere on the board
/Interface/USB_D1: J501.A39; also elsewhere on the board
/Interface/USB_D2: J501.A40; also elsewhere on the board
/Interface/USB_D3: J501.A42; also elsewhere on the board
/Interface/USB_D4: J501.A43; also elsewhere on the board
/Interface/USB_D5: J501.A44; also elsewhere on the board
/Interface/USB_D6: J501.B45; also elsewhere on the board
/Interface/USB_D7: J501.B46; also elsewhere on the board
/Interface/USB_DIR_CTRL: J501.D37; also elsewhere on the board
/Interface/USB_NXT: J501.C38; also elsewhere on the board
/Interface/USB_RESET: J501.D36; also elsewhere on the board
/Interface/USB_STP: J501.B40; also elsewhere on the board
/Power/50V_EN: J501.B41; also elsewhere on the board
/Power/100V_EN: J501.C36; also elsewhere on the board
/Power/-5V_EN: J501.B37; also elsewhere on the board
/Power/AFE_1V8_EN: J501.C39; also elsewhere on the board
/Power/AFE_3V3_EN: J501.C40; also elsewhere on the board
/Power/IM_5V/5V_EN: J501.D38; also elsewhere on the board
/Power/PULSER_1V8_EN: J501.C35; also elsewhere on the board
/Power/SD_3V3_EN: J501.C31; also elsewhere on the board
/Power/SOM_PL_PWR_EN: J501.A20; also elsewhere on the board
/Power/USB_1V8_EN: J501.B42; also elsewhere on the board
/RX/AFE1_AUX: J501.A15; also elsewhere on the board
/RX/AFE1_CSn: J501.A16; also elsewhere on the board
/RX/AFE1_DSYNC: J501.A17; also elsewhere on the board
/RX/AFE1_MUXA: J501.B16; also elsewhere on the board
/RX/AFE2_AUX: J501.C18; also elsewhere on the board
/RX/AFE2_CSn: J501.B17; also elsewhere on the board
/RX/AFE2_DSYNC: J501.B18; also elsewhere on the board
/RX/AFE2_MUXA: J501.D17; also elsewhere on the board
/RX/AFE3_AUX: J501.B20; also elsewhere on the board
/RX/AFE3_CSn: J501.C20; also elsewhere on the board
/RX/AFE3_DSYNC: J501.B21; also elsewhere on the board
/RX/AFE3_MUXA: J501.C19; also elsewhere on the board
/RX/AFE4_AUX: J501.C22; also elsewhere on the board
/RX/AFE4_CSn: J501.C23; also elsewhere on the board
/RX/AFE4_DSYNC: J501.C24; also elsewhere on the board
/RX/AFE4_MUXA: J501.B22; also elsewhere on the board
/RX/AFE_OUTPUTS0: J502.C60; also elsewhere on the board
/RX/AFE_OUTPUTS1: J502.C59; also elsewhere on the board
/RX/AFE_OUTPUTS2: J502.C58; also elsewhere on the board
/RX/AFE_OUTPUTS3: J502.C56; also elsewhere on the board
/RX/AFE_OUTPUTS4: J502.D58; also elsewhere on the board
/RX/AFE_OUTPUTS5: J502.D57; also elsewhere on the board
/RX/AFE_OUTPUTS6: J502.D56; also elsewhere on the board
/RX/AFE_OUTPUTS7: J502.C55; also elsewhere on the board
/RX/AFE_OUTPUTS8: J502.C54; also elsewhere on the board
/RX/AFE_OUTPUTS9: J502.D54; also elsewhere on the board
/RX/AFE_OUTPUTS10: J502.D53; also elsewhere on the board
/RX/AFE_OUTPUTS11: J502.D52; also elsewhere on the board
/RX/AFE_OUTPUTS12: J502.C52; also elsewhere on the board
/RX/AFE_OUTPUTS13: J502.C51; also elsewhere on the board
/RX/AFE_OUTPUTS14: J502.D50; also elsewhere on the board
/RX/AFE_OUTPUTS15: J502.D49; also elsewhere on the board
/RX/AFE_OUTPUTS16: J502.D48; also elsewhere on the board
/RX/AFE_OUTPUTS17: J502.C48; also elsewhere on the board
/RX/AFE_OUTPUTS18: J502.C47; also elsewhere on the board
/RX/AFE_OUTPUTS19: J502.D46; also elsewhere on the board
/RX/AFE_OUTPUTS20: J502.D45; also elsewhere on the board
/RX/AFE_OUTPUTS21: J502.D44; also elsewhere on the board
/RX/AFE_OUTPUTS22: J502.C46; also elsewhere on the board
/RX/AFE_OUTPUTS23: J502.C50; also elsewhere on the board
/RX/AFE_OUTPUTS24: J502.B52; also elsewhere on the board
/RX/AFE_OUTPUTS25: J502.B50; also elsewhere on the board
/RX/AFE_OUTPUTS26: J502.B48; also elsewhere on the board
/RX/AFE_OUTPUTS27: J502.B44; also elsewhere on the board
/RX/AFE_OUTPUTS28: J502.B45; also elsewhere on the board
/RX/AFE_OUTPUTS29: J502.B46; also elsewhere on the board
/RX/AFE_OUTPUTS30: J502.A46; also elsewhere on the board
/RX/AFE_OUTPUTS31: J502.A47; also elsewhere on the board
/RX/AFE_OUTPUTS32: J502.A48; also elsewhere on the board
/RX/AFE_OUTPUTS33: J502.B49; also elsewhere on the board
/RX/AFE_OUTPUTS34: J502.A50; also elsewhere on the board
/RX/AFE_OUTPUTS35: J502.A51; also elsewhere on the board
/RX/AFE_OUTPUTS36: J502.A52; also elsewhere on the board
/RX/AFE_OUTPUTS37: J502.B53; also elsewhere on the board
/RX/AFE_OUTPUTS38: J502.A54; also elsewhere on the board
/RX/AFE_OUTPUTS39: J502.A55; also elsewhere on the board
/RX/AFE_OUTPUTS40: J502.A56; also elsewhere on the board
/RX/AFE_OUTPUTS41: J502.B58; also elsewhere on the board
/RX/AFE_OUTPUTS42: J502.A58; also elsewhere on the board
/RX/AFE_OUTPUTS43: J502.A59; also elsewhere on the board
/RX/AFE_OUTPUTS44: J502.A60; also elsewhere on the board
/RX/AFE_OUTPUTS45: J502.B57; also elsewhere on the board
/RX/AFE_OUTPUTS46: J502.B56; also elsewhere on the board
/RX/AFE_OUTPUTS47: J502.B54; also elsewhere on the board
/RX/AFE_SCLK: J501.D16; also elsewhere on the board
/RX/AFE_SDIO: J501.D18; also elsewhere on the board
/RX/SOM_SYNC_CLK_N: J501.C13; also elsewhere on the board
/RX/SOM_SYNC_CLK_P: J501.C12; also elsewhere on the board
/SOM/BOOT_MODE0: J501.A27, JP501.2 (B)
/SOM/BOOT_MODE1: J501.A28, JP502.2 (B)
/SOM/BOOT_MODE2: J501.A29, JP503.2 (B)
/SOM/BOOT_MODE3: J501.A30, JP504.2 (B)
/SOM/JTAG_TCK_C2M: J501.A25, J503.4
/SOM/JTAG_TDI_C2M: J501.A24, J503.3
/SOM/JTAG_TDO_M2C: J501.A23, J503.2
/SOM/JTAG_TMS_C2M: J501.A22, J503.1
/SOM/PULSER_BF_SYNC_CLK_N: J501.B02; also elsewhere on the board
/SOM/PULSER_BF_SYNC_CLK_P: J501.B01; also elsewhere on the board
/SOM/PULSER_RESET: J501.A36; also elsewhere on the board
/SOM/PULSER_SPI_CLK_N: J501.A07; also elsewhere on the board
/SOM/PULSER_SPI_CLK_P: J501.A06; also elsewhere on the board
/SOM/PULSER_SPI_CRC_EN: J501.B30; also elsewhere on the board
/SOM/PULSER_SPI_CS0: J501.B04; also elsewhere on the board
/SOM/PULSER_SPI_CS1: J501.B05; also elsewhere on the board
/SOM/PULSER_SPI_D0_N: J501.A04; also elsewhere on the board
/SOM/PULSER_SPI_D0_P: J501.A03; also elsewhere on the board
/SOM/PULSER_SPI_D1_N: J501.A10; also elsewhere on the board
/SOM/PULSER_SPI_D1_P: J501.A09; also elsewhere on the board
/SOM/PULSER_SPI_MODE: J501.B29; also elsewhere on the board
/SOM/PULSER_SPI_SDOUT: J501.C34; also elsewhere on the board
/SOM/PULSER_SPI_SE_N: J501.A13; also elsewhere on the board
/SOM/PULSER_SPI_SE_P: J501.A12; also elsewhere on the board
/SOM/PULSER_WAKEUP: J501.A34; also elsewhere on the board
/SOM/PWROFF_ C2M_L: C512.1, J501.B26, R501.2, SW501.2
/SOM/SOM_PS_PWR_EN: J501.A19
/TX/PULSER_CRC_ERR: J501.B36; also elsewhere on the board
/TX/PULSER_TSHUT: J501.A35; also elsewhere on the board
/TX/PULSER_TXRX: J501.C30; also elsewhere on the board
GND: C501.2, C502.2, C503.2, C504.2, C505.2, C506.2, C507.2, C508.2, C509.2, C510.2, C511.2, C512.2, C513.2, C514.2, C515.2, C516.2, C517.2, C518.2, C519.2, C520.2, C521.2, J501.A01, J501.A02, J501.A05, J501.A08, J501.A11, J501.A14, J501.A18, J501.A21, J501.A26, J501.A33, J501.A37, J501.A41, J501.A45, J501.A46, J501.A49, J501.A50, J501.A53, J501.A54, J501.A57, J501.A58, J501.B03, J501.B06, J501.B09, J501.B12, J501.B15, J501.B19, J501.B23, J501.B27, J501.B31, J501.B35, J501.B39, J501.B43, J501.B47, J501.B48, J501.B51, J501.B52, J501.B55, J501.B56, J501.B59, J501.C01, J501.C02, J501.C05, J501.C08, J501.C11, J501.C14, J501.C17, J501.C21, J501.C25, J501.C29, J501.C33, J501.C37, J501.C41, J501.C46, J501.C49, J501.C50, J501.C53, J501.C54, J501.C57, J501.C58, J501.D03, J501.D06, J501.D09, J501.D12, J501.D15, J501.D19, J501.D23, J501.D27, J501.D31, J501.D35, J501.D39, J501.D43, J501.D47, J501.D48, J501.D51, J501.D52, J501.D55, J501.D56, J501.D59, J502.A01, J502.A02, J502.A05, J502.A06, J502.A09, J502.A10, J502.A13, J502.A16, J502.A19, J502.A22, J502.A25, J502.A28, J502.A31, J502.A34, J502.A37, J502.A40, J502.A43, J502.A45, J502.A49, J502.A53, J502.A57, J502.B03, J502.B04, J502.B07, J502.B08, J502.B11, J502.B14, J502.B17, J502.B20, J502.B23, J502.B26, J502.B29, J502.B32, J502.B35, J502.B38, J502.B41, J502.B43, J502.B47, J502.B51, J502.B55, J502.C01, J502.C02, J502.C05, J502.C06, J502.C09, J502.C10, J502.C13, J502.C16, J502.C19, J502.C22, J502.C25, J502.C28, J502.C31, J502.C34, J502.C37, J502.C40, J502.C43, J502.C45, J502.C49, J502.C53, J502.C57, J502.D03, J502.D04, J502.D07, J502.D08, J502.D11, J502.D14, J502.D17, J502.D20, J502.D23, J502.D26, J502.D29, J502.D32, J502.D35, J502.D38, J502.D41, J502.D43, J502.D47, J502.D51, J502.D55, J503.5, JP501.1 (A), JP502.1 (A), JP503.1 (A), JP504.1 (A), SW501.1; also elsewhere on the board
SOM_5V: C501.1, C502.1, C503.1, C504.1, C505.1, C506.1, C507.1, C508.1, J501.A59, J501.A60, J501.B60, J501.C59, J501.C60, J501.D60; also elsewhere on the board
VCC_SOM: R501.1
VDD_HDA: C513.1, C514.1, C515.1, J501.B13, J501.B14; also elsewhere on the board
VDD_HDB: C516.1, C517.1, C518.1, C519.1, C520.1, C521.1, J502.B59, J502.B60, J502.D59, J502.D60; also elsewhere on the board
VDD_HPA: C509.1, C510.1, C511.1, J501.D01, J501.D02; also elsewhere on the board
VDD_HPB: J502.A44, J502.B42
VDD_HPC: J502.C44, J502.D42

Notes on the sheet:
HDA
Bank 501
SOM240_2
HDB
HDC
Bank 502
HPA
SOM240_1
These 2 signals are from the SOM module to the carrier board to enable PS & PL domains (enable regulators on carrier)
Reset Button
