yusufElnady/Medical-Imager/MedicalImager.kicad_pcb

## KiCad design MedicalImager.kicad_pcb (continued)

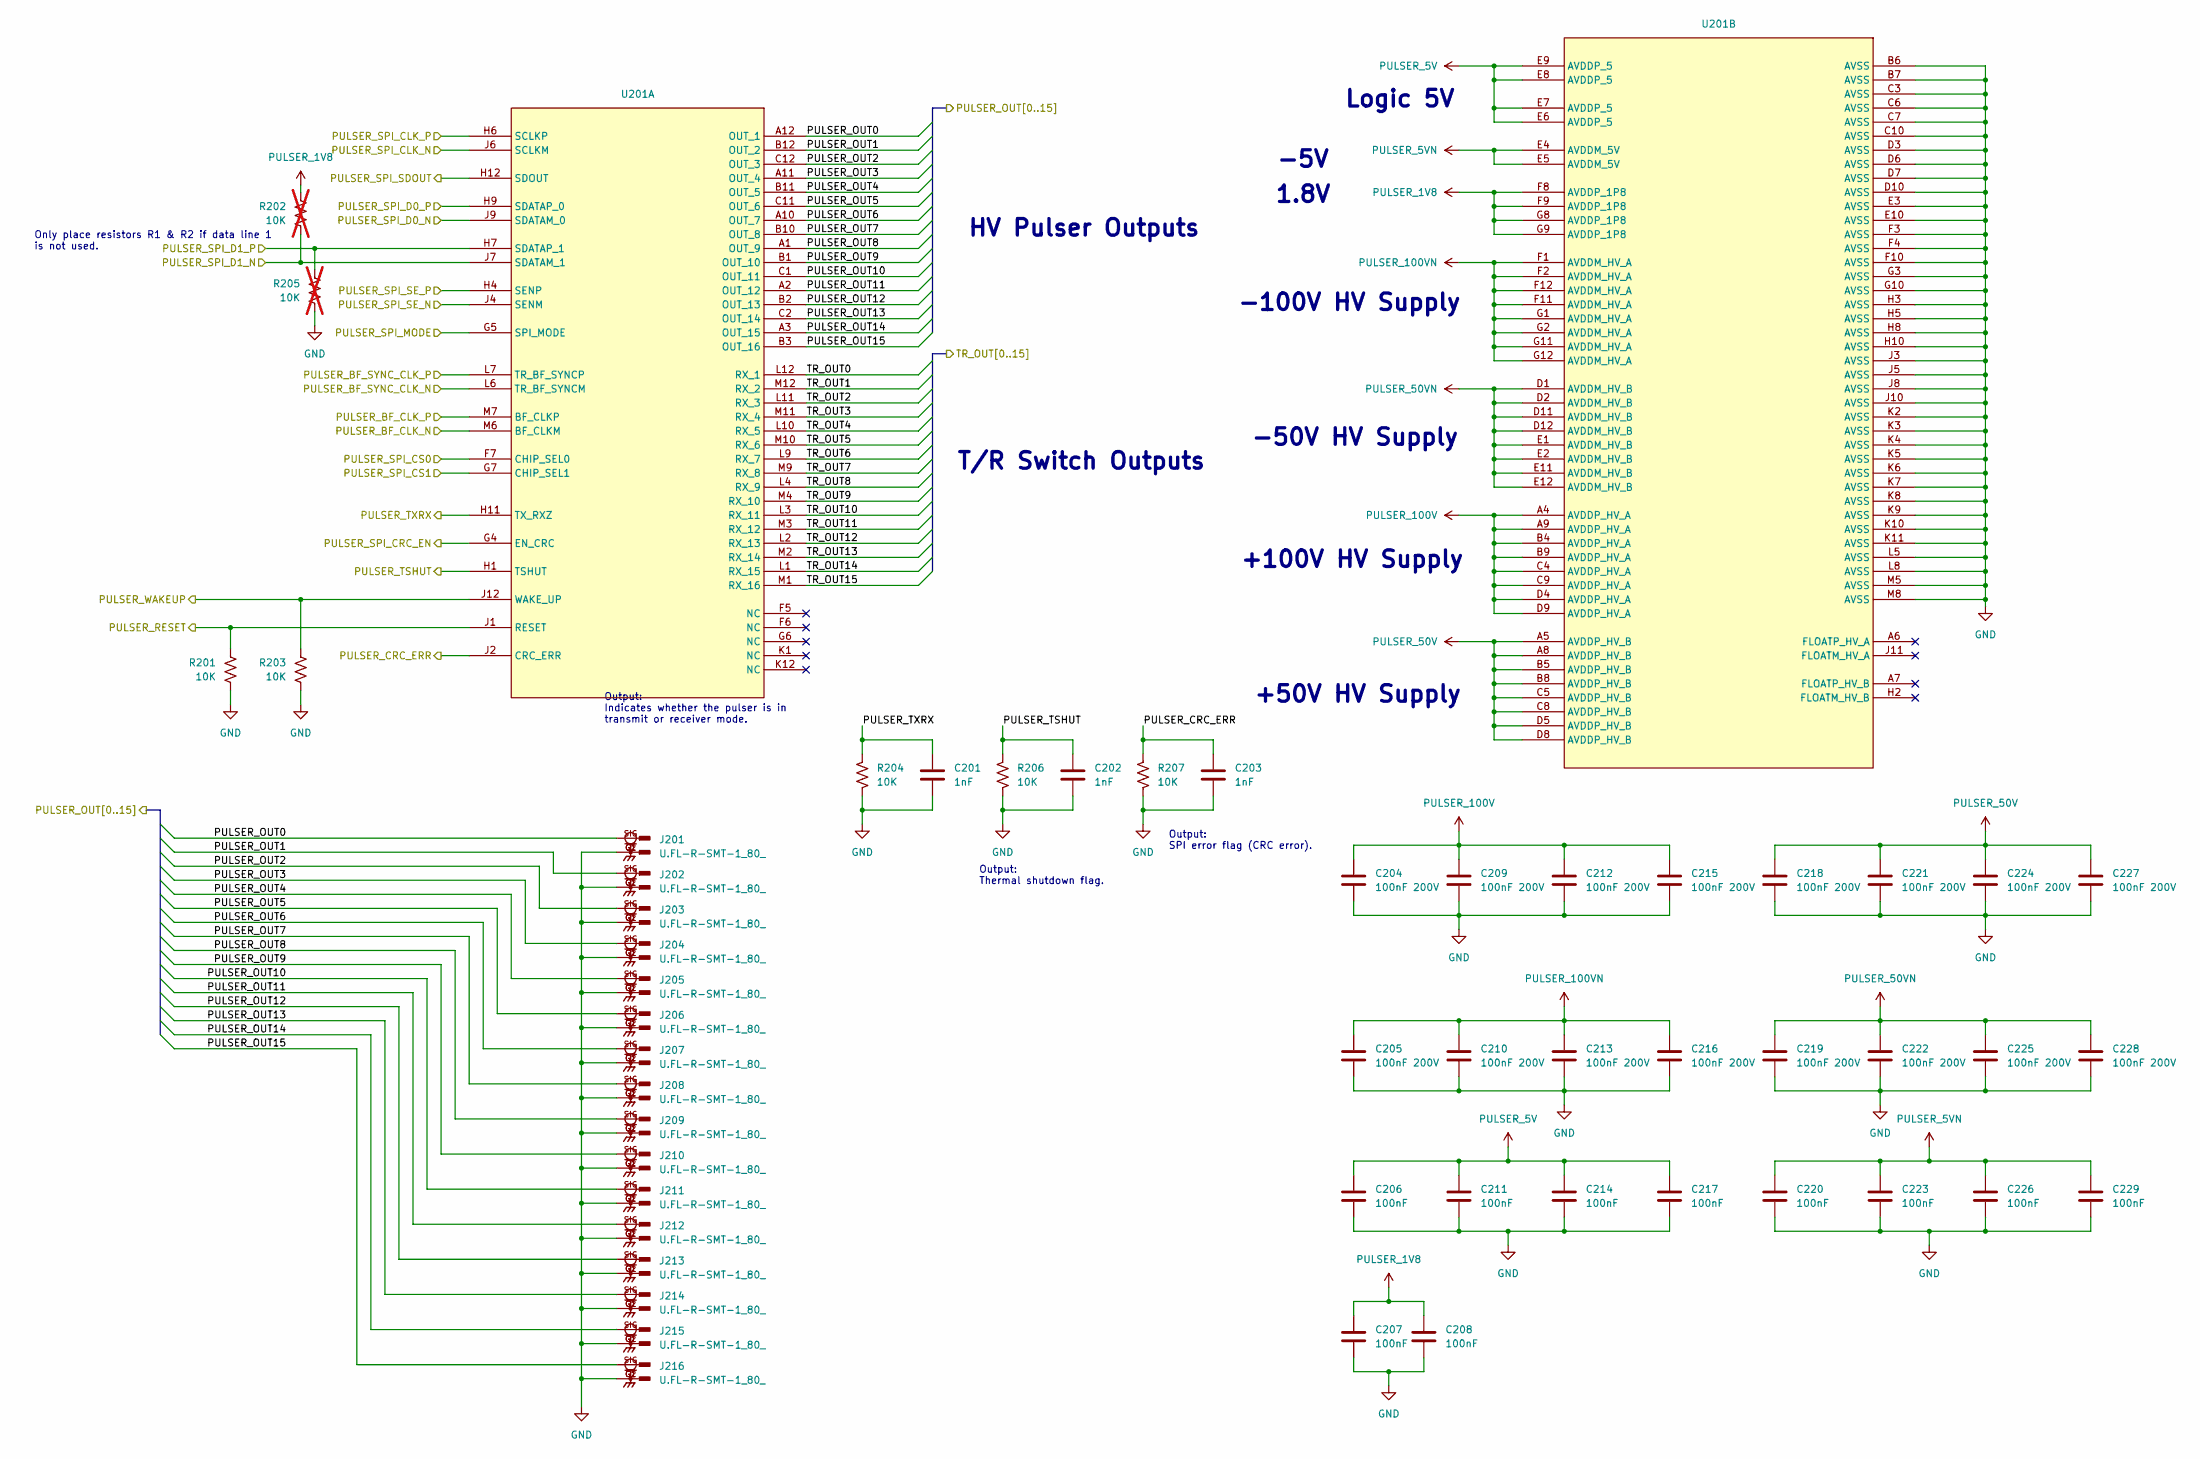
[picture p60: schematic TX.kicad_sch]

Parts:
C201, C202, C203: 1nF; C_0402_1005Metric
C204, C205, C209, C210, C212, C213, C215, C216, C218, C219, C221, C222, C224, C225, C227, C228: 100nF 200V; C_0805_2012Metric
C206, C207, C208, C211, C214, C217, C220, C223, C226, C229: 100nF; C_0402_1005Metric
J201, J202, J203, J204, J205, J206, J207, J208, J209, J210, J211, J212, J213, J214, J215, J216: U.FL-R-SMT-1_80_; HIROSE_U.FL-R-SMT-1_80_; PARTREV Jul.1.2022
R201, R203, R204, R206, R207: 10K; R_0402_1005Metric
R202, R205: 10K; R_0402_1005Metric; not fitted
U201: BGA-144_10.0x10.0mm_Layout12x12_P0.8mm_TI-ALH0144A

Connections:
/RX/TR_OUT0: U201.L12 (RX_1); also elsewhere on the board
/RX/TR_OUT1: U201.M12 (RX_2); also elsewhere on the board
/RX/TR_OUT2: U201.L11 (RX_3); also elsewhere on the board
/RX/TR_OUT3: U201.M11 (RX_4); also elsewhere on the board
/RX/TR_OUT4: U201.L10 (RX_5); also elsewhere on the board
/RX/TR_OUT5: U201.M10 (RX_6); also elsewhere on the board
/RX/TR_OUT6: U201.L9 (RX_7); also elsewhere on the board
/RX/TR_OUT7: U201.M9 (RX_8); also elsewhere on the board
/RX/TR_OUT8: U201.L4 (RX_9); also elsewhere on the board
/RX/TR_OUT9: U201.M4 (RX_10); also elsewhere on the board
/RX/TR_OUT10: U201.L3 (RX_11); also elsewhere on the board
/RX/TR_OUT11: U201.M3 (RX_12); also elsewhere on the board
/RX/TR_OUT12: U201.L2 (RX_13); also elsewhere on the board
/RX/TR_OUT13: U201.M2 (RX_14); also elsewhere on the board
/RX/TR_OUT14: U201.L1 (RX_15); also elsewhere on the board
/RX/TR_OUT15: U201.M1 (RX_16); also elsewhere on the board
/RX/TX_BF_CLK_N: U201.M6 (BF_CLKM); also elsewhere on the board
/RX/TX_BF_CLK_P: U201.M7 (BF_CLKP); also elsewhere on the board
/SOM/PULSER_BF_SYNC_CLK_N: U201.L6 (TR_BF_SYNCM); also elsewhere on the board
/SOM/PULSER_BF_SYNC_CLK_P: U201.L7 (TR_BF_SYNCP); also elsewhere on the board
/SOM/PULSER_RESET: R201.1, U201.J1 (RESET); also elsewhere on the board
/SOM/PULSER_SPI_CLK_N: U201.J6 (SCLKM); also elsewhere on the board
/SOM/PULSER_SPI_CLK_P: U201.H6 (SCLKP); also elsewhere on the board
/SOM/PULSER_SPI_CRC_EN: U201.G4 (EN_CRC); also elsewhere on the board
/SOM/PULSER_SPI_CS0: U201.F7 (CHIP_SEL0); also elsewhere on the board
/SOM/PULSER_SPI_CS1: U201.G7 (CHIP_SEL1); also elsewhere on the board
/SOM/PULSER_SPI_D0_N: U201.J9 (SDATAM_0); also elsewhere on the board
/SOM/PULSER_SPI_D0_P: U201.H9 (SDATAP_0); also elsewhere on the board
/SOM/PULSER_SPI_D1_N: R202.2, U201.J7 (SDATAM_1); also elsewhere on the board
/SOM/PULSER_SPI_D1_P: R205.1, U201.H7 (SDATAP_1); also elsewhere on the board
/SOM/PULSER_SPI_MODE: U201.G5 (SPI_MODE); also elsewhere on the board
/SOM/PULSER_SPI_SDOUT: U201.H12 (SDOUT); also elsewhere on the board
/SOM/PULSER_SPI_SE_N: U201.J4 (SENM); also elsewhere on the board
/SOM/PULSER_SPI_SE_P: U201.H4 (SENP); also elsewhere on the board
/SOM/PULSER_WAKEUP: R203.1, U201.J12 (WAKE_UP); also elsewhere on the board
/TX/PULSER_CRC_ERR: C203.1, R207.1, U201.J2 (CRC_ERR); also elsewhere on the board
/TX/PULSER_OUT0: J201.SIG, U201.A12 (OUT_1)
/TX/PULSER_OUT1: J202.SIG, U201.B12 (OUT_2)
/TX/PULSER_OUT2: J203.SIG, U201.C12 (OUT_3)
/TX/PULSER_OUT3: J204.SIG, U201.A11 (OUT_4)
/TX/PULSER_OUT4: J205.SIG, U201.B11 (OUT_5)
/TX/PULSER_OUT5: J206.SIG, U201.C11 (OUT_6)
/TX/PULSER_OUT6: J207.SIG, U201.A10 (OUT_7)
/TX/PULSER_OUT7: J208.SIG, U201.B10 (OUT_8)
/TX/PULSER_OUT8: J209.SIG, U201.A1 (OUT_9)
/TX/PULSER_OUT9: J210.SIG, U201.B1 (OUT_10)
/TX/PULSER_OUT10: J211.SIG, U201.C1 (OUT_11)
/TX/PULSER_OUT11: J212.SIG, U201.A2 (OUT_12)
/TX/PULSER_OUT12: J213.SIG, U201.B2 (OUT_13)
/TX/PULSER_OUT13: J214.SIG, U201.C2 (OUT_14)
/TX/PULSER_OUT14: J215.SIG, U201.A3 (OUT_15)
/TX/PULSER_OUT15: J216.SIG, U201.B3 (OUT_16)
/TX/PULSER_TSHUT: C202.1, R206.1, U201.H1 (TSHUT); also elsewhere on the board
/TX/PULSER_TXRX: C201.1, R204.1, U201.H11 (TX_RXZ); also elsewhere on the board
GND: C201.2, C202.2, C203.2, C204.2, C205.2, C206.2, C207.2, C208.2, C209.2, C210.2, C211.2, C212.2, C213.2, C214.2, C215.2, C216.2, C217.2, C218.2, C219.2, C220.2, C221.2, C222.2, C223.2, C224.2, C225.2, C226.2, C227.2, C228.2, C229.2, J201.G1, J201.G2, J202.G1, J202.G2, J203.G1, J203.G2, J204.G1, J204.G2, J205.G1, J205.G2, J206.G1, J206.G2, J207.G1, J207.G2, J208.G1, J208.G2, J209.G1, J209.G2, J210.G1, J210.G2, J211.G1, J211.G2, J212.G1, J212.G2, J213.G1, J213.G2, J214.G1, J214.G2, J215.G1, J215.G2, J216.G1, J216.G2, R201.2, R203.2, R204.2, R205.2, R206.2, R207.2, U201.B6 (AVSS), U201.B7 (AVSS), U201.C3 (AVSS), U201.C6 (AVSS), U201.C7 (AVSS), U201.C10 (AVSS), U201.D3 (AVSS), U201.D6 (AVSS), U201.D7 (AVSS), U201.D10 (AVSS), U201.E3 (AVSS), U201.E10 (AVSS), U201.F3 (AVSS), U201.F4 (AVSS), U201.F10 (AVSS), U201.G3 (AVSS), U201.G10 (AVSS), U201.H3 (AVSS), U201.H5 (AVSS), U201.H8 (AVSS), U201.H10 (AVSS), U201.J3 (AVSS), U201.J5 (AVSS), U201.J8 (AVSS), U201.J10 (AVSS), U201.K2 (AVSS), U201.K3 (AVSS), U201.K4 (AVSS), U201.K5 (AVSS), U201.K6 (AVSS), U201.K7 (AVSS), U201.K8 (AVSS), U201.K9 (AVSS), U201.K10 (AVSS), U201.K11 (AVSS), U201.L5 (AVSS), U201.L8 (AVSS), U201.M5 (AVSS), U201.M8 (AVSS); also elsewhere on the board
IM_5V: C206.1, C211.1, C214.1, C217.1, U201.E6 (AVDDP_5), U201.E7 (AVDDP_5), U201.E8 (AVDDP_5), U201.E9 (AVDDP_5); also elsewhere on the board
PULSER_1V8: C207.1, C208.1, R202.1, U201.F8 (AVDDP_1P8), U201.F9 (AVDDP_1P8), U201.G8 (AVDDP_1P8), U201.G9 (AVDDP_1P8); also elsewhere on the board
PULSER_5VN: C220.1, C223.1, C226.1, C229.1, U201.E4 (AVDDM_5V), U201.E5 (AVDDM_5V); also elsewhere on the board
PULSER_50V: C218.1, C221.1, C224.1, C227.1, U201.A5 (AVDDP_HV_B), U201.A8 (AVDDP_HV_B), U201.B5 (AVDDP_HV_B), U201.B8 (AVDDP_HV_B), U201.C5 (AVDDP_HV_B), U201.C8 (AVDDP_HV_B), U201.D5 (AVDDP_HV_B), U201.D8 (AVDDP_HV_B); also elsewhere on the board
PULSER_50VN: C219.1, C222.1, C225.1, C228.1, U201.D1 (AVDDM_HV_B), U201.D2 (AVDDM_HV_B), U201.D11 (AVDDM_HV_B), U201.D12 (AVDDM_HV_B), U201.E1 (AVDDM_HV_B), U201.E2 (AVDDM_HV_B), U201.E11 (AVDDM_HV_B), U201.E12 (AVDDM_HV_B); also elsewhere on the board
PULSER_100V: C204.1, C209.1, C212.1, C215.1, U201.A4 (AVDDP_HV_A), U201.A9 (AVDDP_HV_A), U201.B4 (AVDDP_HV_A), U201.B9 (AVDDP_HV_A), U201.C4 (AVDDP_HV_A), U201.C9 (AVDDP_HV_A), U201.D4 (AVDDP_HV_A), U201.D9 (AVDDP_HV_A); also elsewhere on the board
PULSER_100VN: C205.1, C210.1, C213.1, C216.1, U201.F1 (AVDDM_HV_A), U201.F2 (AVDDM_HV_A), U201.F11 (AVDDM_HV_A), U201.F12 (AVDDM_HV_A), U201.G1 (AVDDM_HV_A), U201.G2 (AVDDM_HV_A), U201.G11 (AVDDM_HV_A), U201.G12 (AVDDM_HV_A); also elsewhere on the board

Notes on the sheet:
-50V HV Supply
-5V
1.8V
+100V HV Supply
Logic 5V
HV Pulser Outputs
Only place resistors R1 & R2 if data line 1 is not used.
Output: Indicates whether the pulser is in transmit or receiver mode.
Output: SPI error flag (CRC error).
-100V HV Supply
+50V HV Supply
Output: Thermal shutdown flag.
T/R Switch Outputs

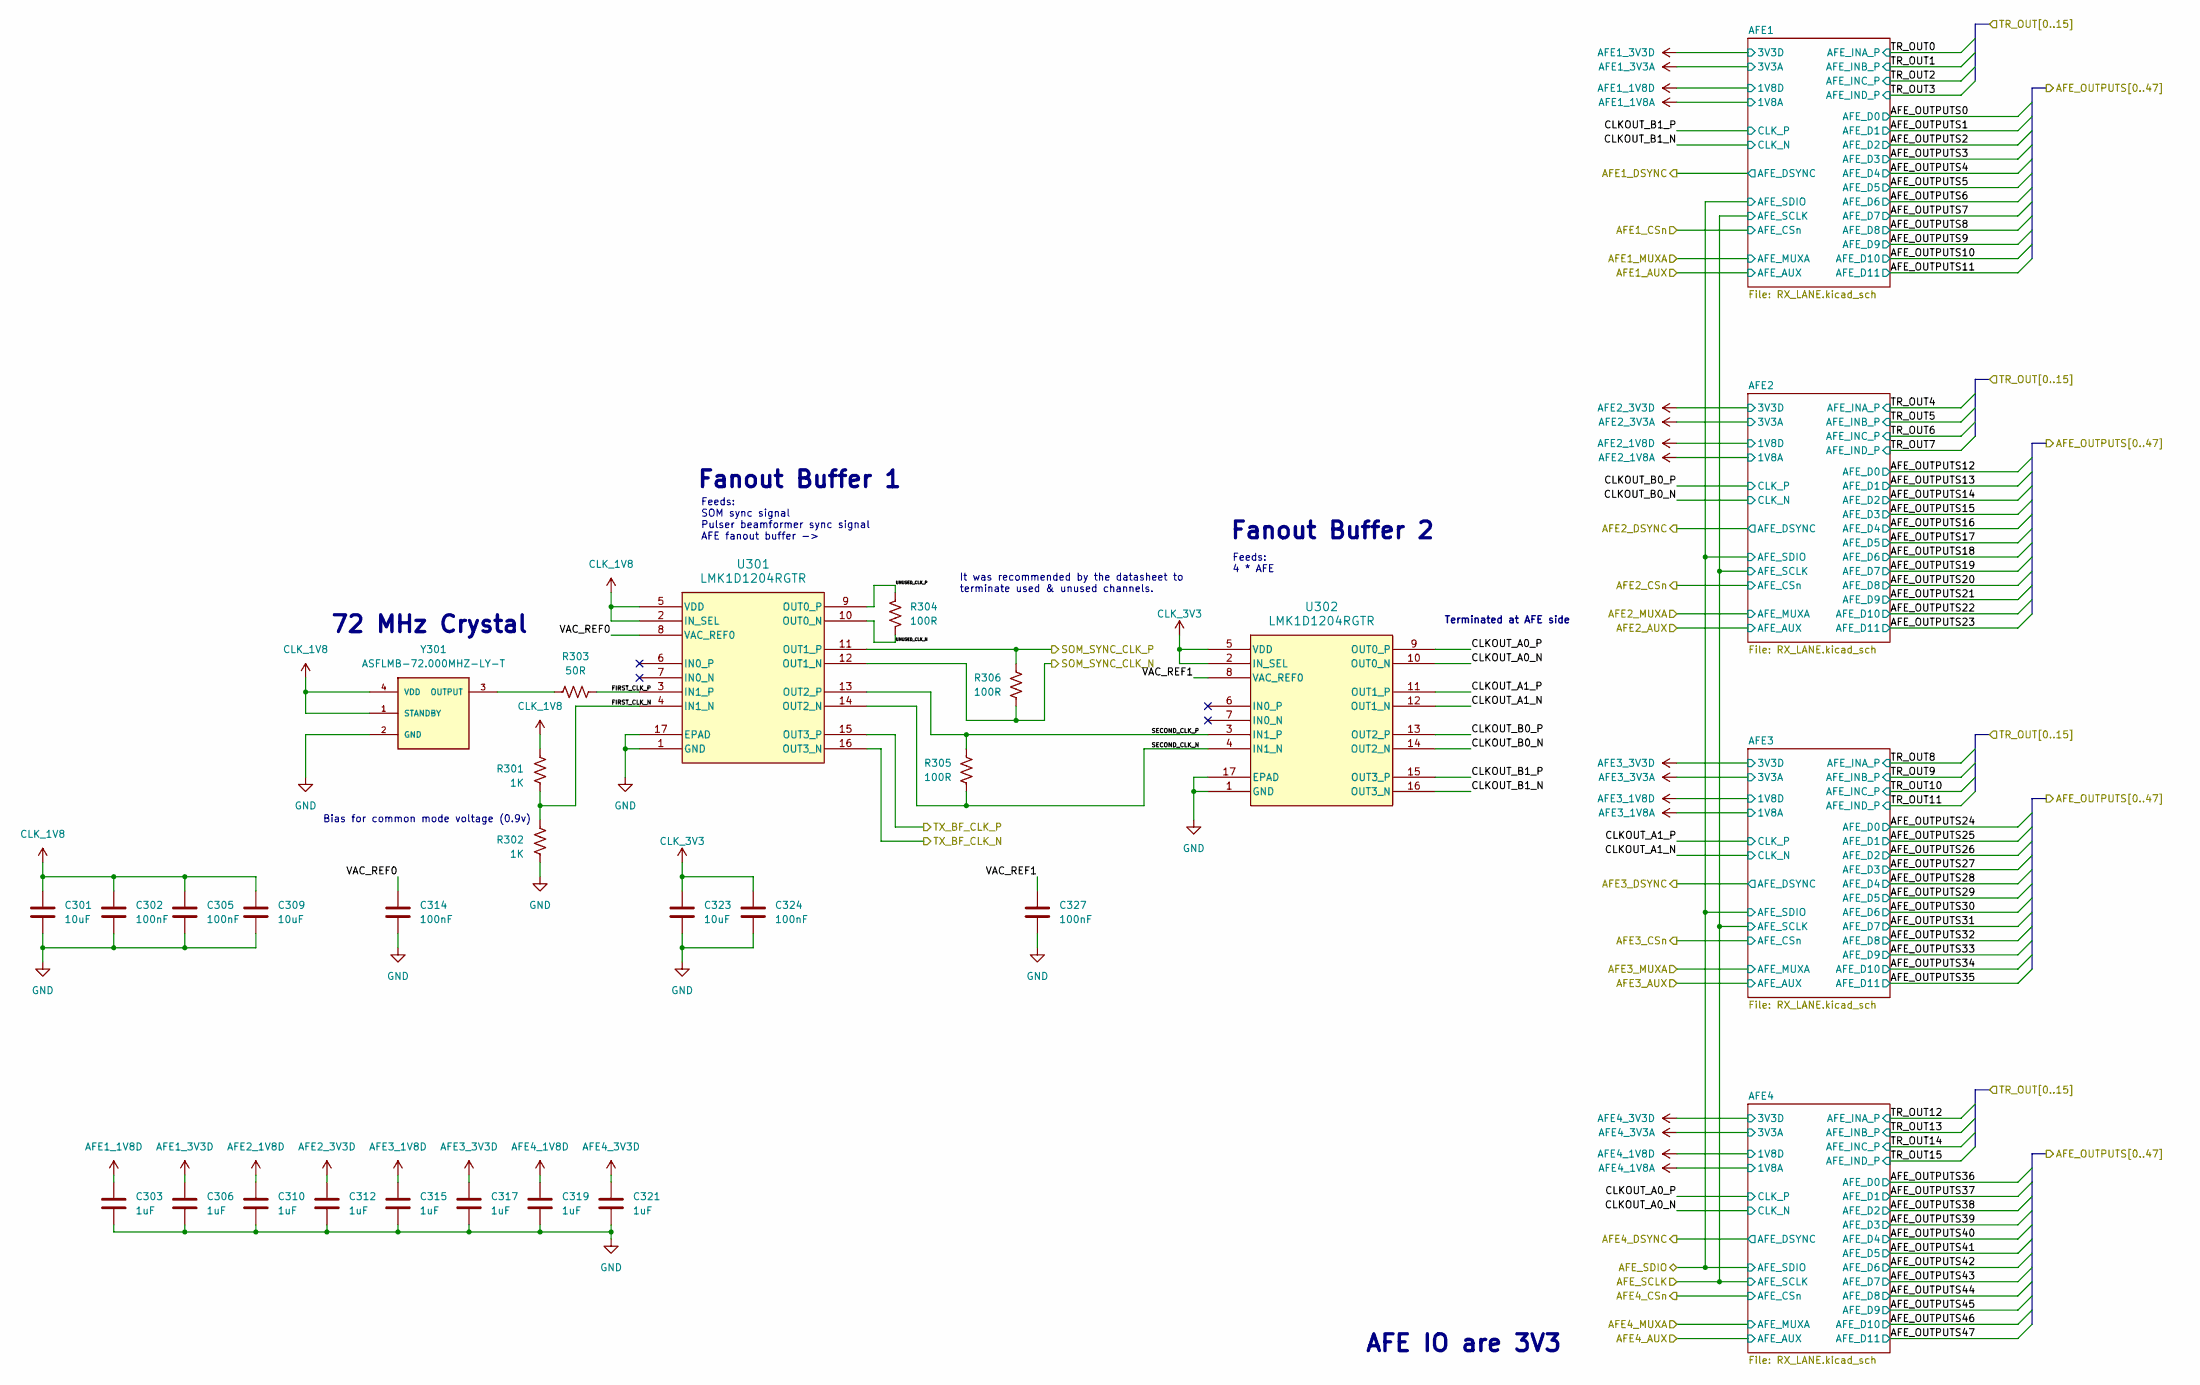
[picture p61: schematic RX.kicad_sch]

Parts:
C301, C309, C323: 10uF; C_0402_1005Metric
C302, C305, C314, C324, C327: 100nF; C_0402_1005Metric
C303, C306, C310, C312, C315, C317, C319, C321: 1uF; C_0402_1005Metric
R301, R302: 1K; R_0402_1005Metric
R303: 50R; R_0402_1005Metric
R304, R305, R306: 100R; R_0402_1005Metric
U301, U302: LMK1D1204RGTR; VQFN16_RGT_TEX
Y301: ASFLMB-72.000MHZ-LY-T; XTAL_ASFLMB-72.000MHZ-LY-T; PARTREV 1.4.2021

Connections:
/RX/CLKOUT_A0_N: U302.10 (OUT0_N); also elsewhere on the board
/RX/CLKOUT_A0_P: U302.9 (OUT0_P); also elsewhere on the board
/RX/CLKOUT_A1_N: U302.12 (OUT1_N); also elsewhere on the board
/RX/CLKOUT_A1_P: U302.11 (OUT1_P); also elsewhere on the board
/RX/CLKOUT_B0_N: U302.14 (OUT2_N); also elsewhere on the board
/RX/CLKOUT_B0_P: U302.13 (OUT2_P); also elsewhere on the board
/RX/CLKOUT_B1_N: U302.16 (OUT3_N); also elsewhere on the board
/RX/CLKOUT_B1_P: U302.15 (OUT3_P); also elsewhere on the board
/RX/FIRST_CLK_N: R301.2, R302.1, U301.4 (IN1_N)
/RX/FIRST_CLK_P: R303.1, U301.3 (IN1_P)
/RX/SECOND_CLK_N: R305.2, U301.14 (OUT2_N), U302.4 (IN1_N)
/RX/SECOND_CLK_P: R305.1, U301.13 (OUT2_P), U302.3 (IN1_P)
/RX/SOM_SYNC_CLK_N: R306.2, U301.12 (OUT1_N); also elsewhere on the board
/RX/SOM_SYNC_CLK_P: R306.1, U301.11 (OUT1_P); also elsewhere on the board
/RX/TX_BF_CLK_N: U301.16 (OUT3_N); also elsewhere on the board
/RX/TX_BF_CLK_P: U301.15 (OUT3_P); also elsewhere on the board
/RX/UNUSED_CLK_N: R304.2, U301.10 (OUT0_N)
/RX/UNUSED_CLK_P: R304.1, U301.9 (OUT0_P)
/RX/VAC_REF0: C314.2, U301.8 (VAC_REF0)
/RX/VAC_REF1: C327.2, U302.8 (VAC_REF0)
AFE1_1V8D: C303.1, C310.1; also elsewhere on the board
AFE1_3V3D: C306.1, C312.1; also elsewhere on the board
AFE3_1V8D: C315.1, C319.1; also elsewhere on the board
AFE3_3V3D: C317.1, C321.1; also elsewhere on the board
CLK_1V8: C301.2, C302.2, C305.2, C309.2, R301.1, U301.2 (IN_SEL), U301.5 (VDD), Y301.1 (STANDBY), Y301.4 (VDD); also elsewhere on the board
CLK_3V3: C323.2, C324.2, U302.2 (IN_SEL), U302.5 (VDD); also elsewhere on the board
GND: C301.1, C302.1, C303.2, C305.1, C306.2, C309.1, C310.2, C312.2, C314.1, C315.2, C317.2, C319.2, C321.2, C323.1, C324.1, C327.1, R302.2, U301.1 (GND), U301.17 (EPAD), U302.1 (GND), U302.17 (EPAD), Y301.2 (GND); also elsewhere on the board
unnamed: R303.2, Y301.3 (OUTPUT)

Notes on the sheet:
72 MHz Crystal
AFE IO are 3V3
Fanout Buffer 2
Fanout Buffer 1
Terminated at AFE side
It was recommended by the datasheet to terminate used & unused channels.
Feeds: SOM sync signal Pulser beamformer sync signal AFE fanout buffer ->
Bias for common mode voltage (0.9v)
Feeds: 4 * AFE

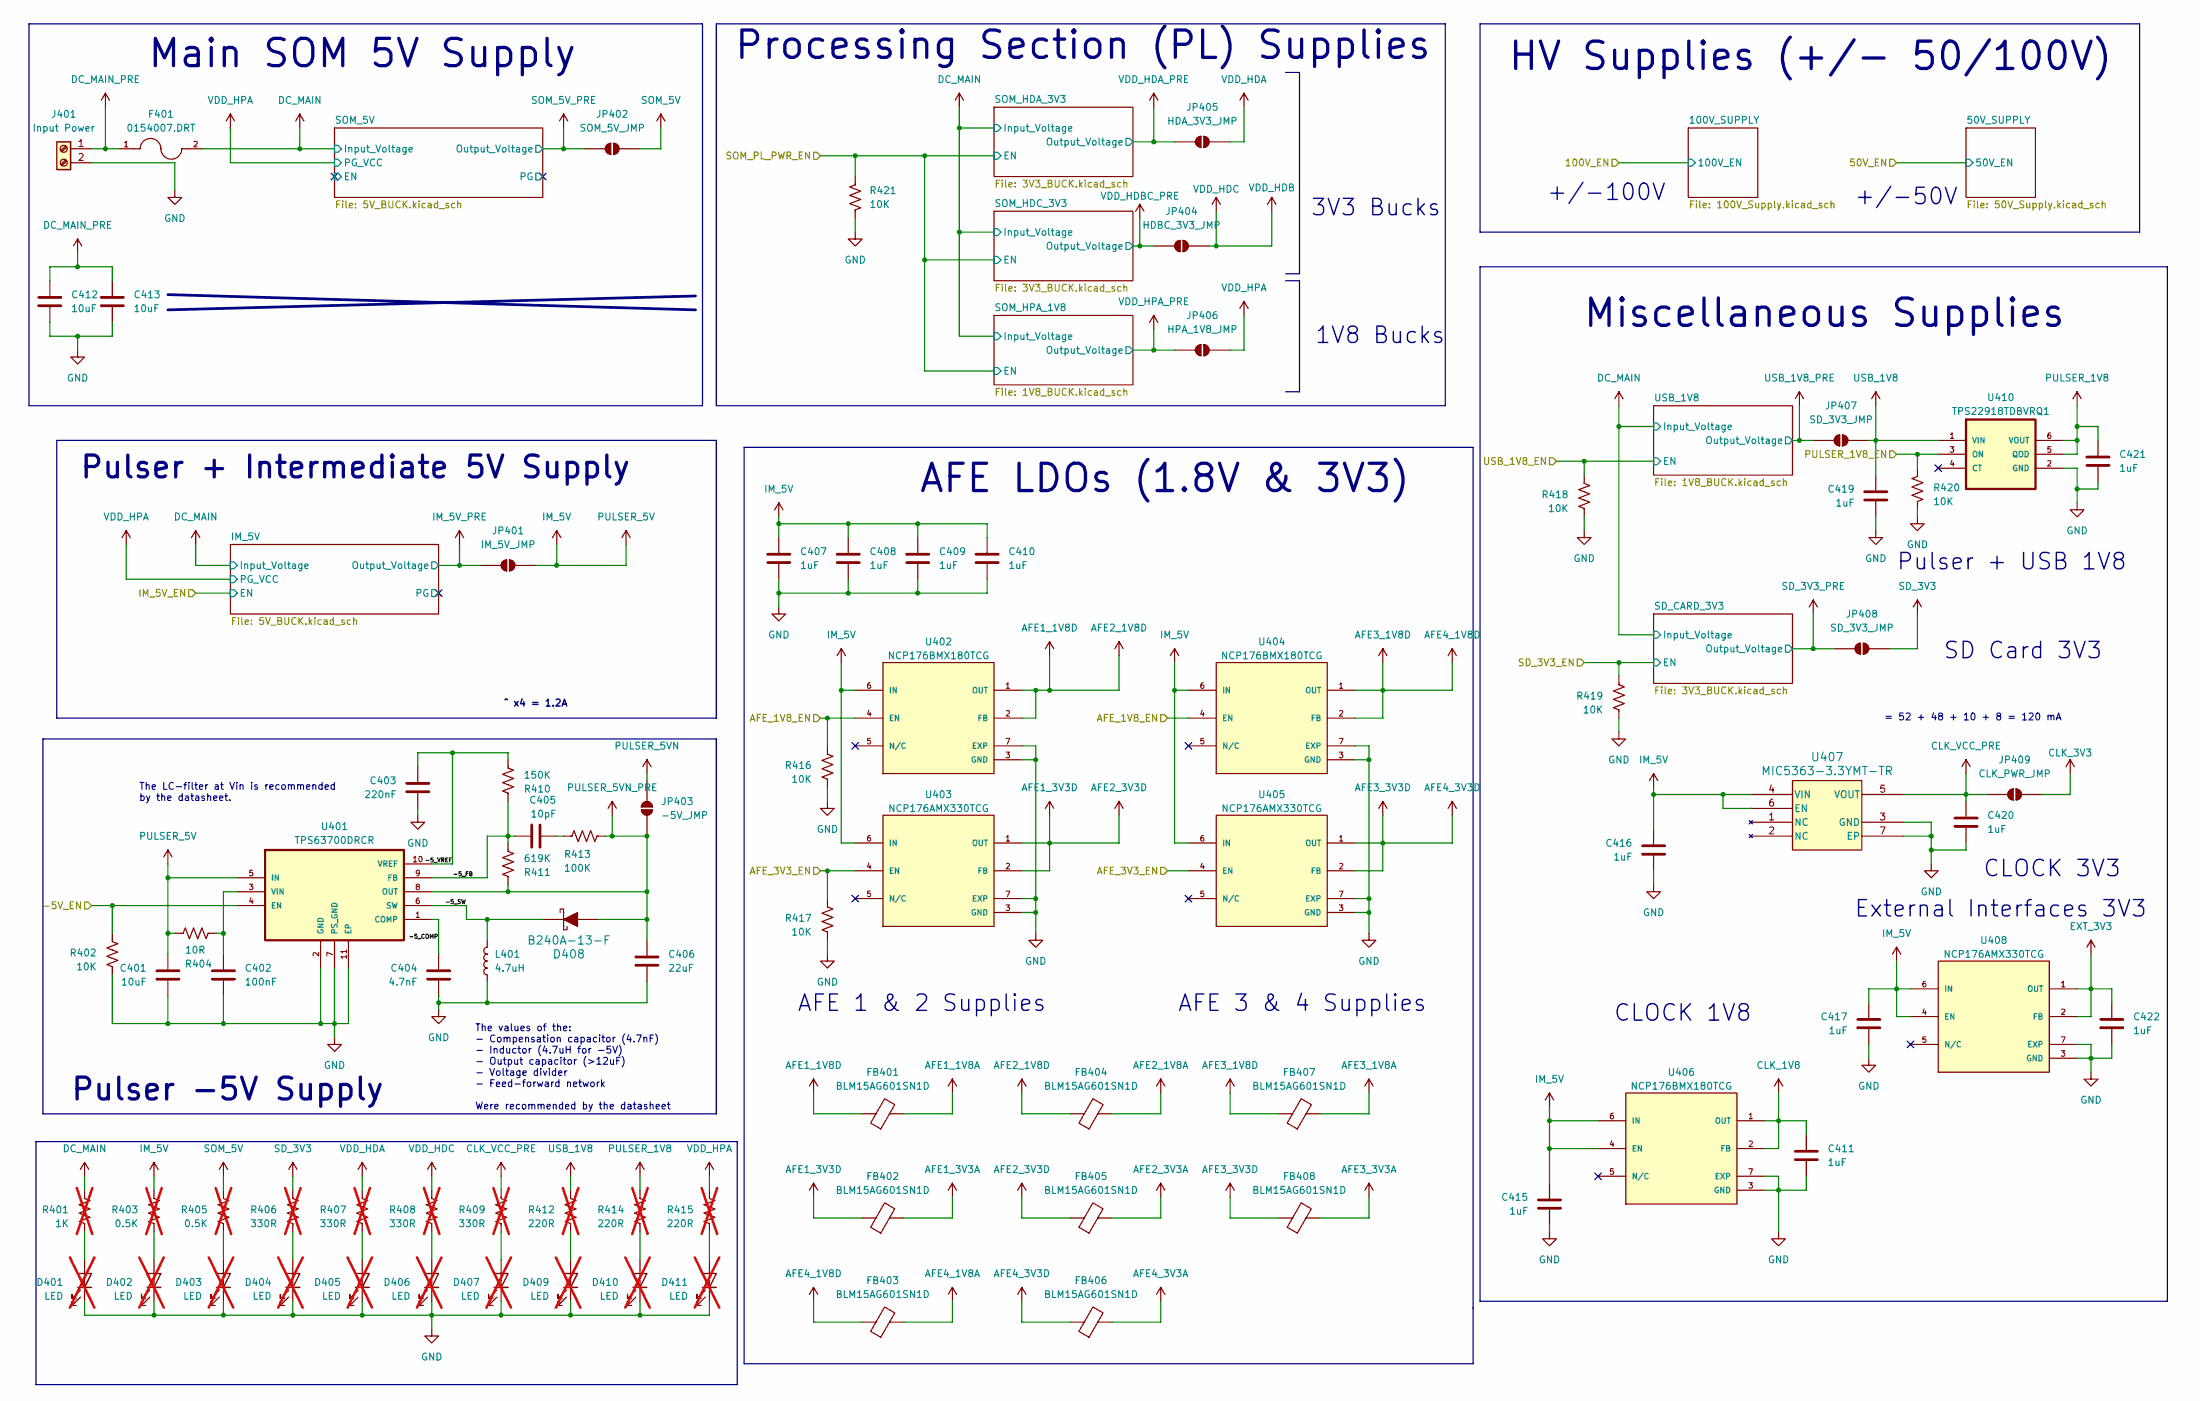
[picture p62: schematic Power.kicad_sch]

Parts:
C401, C412, C413: 10uF; C_0805_2012Metric
C402: 100nF; C_0402_1005Metric
C403: 220nF; C_0402_1005Metric
C404: 4.7nF; C_0603_1608Metric
C405: 10pF; C_0402_1005Metric
C406: 22uF; C_0805_2012Metric
C407, C408, C409, C410, C411, C415, C416, C417, C419, C420, C421, C422: 1uF; C_0402_1005Metric
D401, D402, D403, D404, D405, D406, D407, D409, D410, D411: LED; LED_0603_1608Metric; not fitted
D408: B240A-13-F; DO-214AC; MPN B240A-13-F; Digi-Key_PN B240A-FDICT-ND
F401: 0154007.DRT; FUSE_0154007.DRT; MPN 0154007.DRT
FB401, FB402, FB403, FB404, FB405, FB406, FB407, FB408: BLM15AG601SN1D; L_0402_1005Metric
J401: Input Power; TerminalBlock_MaiXu_MX126-5.0-02P_1x02_P5.00mm
JP401: IM_5V_JMP; SolderJumper-2_P1.3mm_Open_TrianglePad1.0x1.5mm
JP402: SOM_5V_JMP; SolderJumper-2_P1.3mm_Open_TrianglePad1.0x1.5mm
JP403: -5V_JMP; SolderJumper-2_P1.3mm_Open_TrianglePad1.0x1.5mm
JP404: HDBC_3V3_JMP; SolderJumper-2_P1.3mm_Open_TrianglePad1.0x1.5mm
JP405: HDA_3V3_JMP; SolderJumper-2_P1.3mm_Open_TrianglePad1.0x1.5mm
JP406: HPA_1V8_JMP; SolderJumper-2_P1.3mm_Open_TrianglePad1.0x1.5mm
JP407, JP408: SD_3V3_JMP; SolderJumper-2_P1.3mm_Open_TrianglePad1.0x1.5mm
JP409: CLK_PWR_JMP; SolderJumper-2_P1.3mm_Open_TrianglePad1.0x1.5mm
L401: 4.7uH; L_0805_2012Metric
R401: 1K; R_0402_1005Metric; not fitted
R402, R416, R417, R418, R419, R420, R421: 10K; R_0402_1005Metric
R403, R405: 0.5K; R_0402_1005Metric; not fitted
R404: 10R; R_0402_1005Metric
R406, R407, R408, R409: 330R; R_0402_1005Metric; not fitted
R410: 150K; R_0402_1005Metric
R411: 619K; R_0402_1005Metric
R412, R414, R415: 220R; R_0402_1005Metric; not fitted
R413: 100K; R_0402_1005Metric
U401: TPS63700DRCR; VREG_V62_16624-01YE
U402, U404, U406: NCP176BMX180TCG; PSON40P120X120X45-7N_NCP176BMX180TCG; PARTREV 5
U403, U405, U408: NCP176AMX330TCG; PSON40P120X120X45-7N_NCP176AMX330TCG; PARTREV 5
U407: MIC5363-3.3YMT-TR; TMLF-6_MT_MCH
U410: TPS22918TDBVRQ1; SOT95P280X145-6N

Connections:
/Power/-5V_EN: R402.1, U401.4 (EN); also elsewhere on the board
/Power/-5_COMP: C404.1, U401.1 (COMP)
/Power/-5_FB: C405.1, R410.1, R411.2, U401.9 (FB)
/Power/-5_SW: D408.K, L401.2, U401.6 (SW)
/Power/-5_VREF: C403.1, R410.2, U401.10 (VREF)
/Power/AFE_1V8_EN: R416.1, U402.4 (EN), U404.4 (EN); also elsewhere on the board
/Power/AFE_3V3_EN: R417.1, U403.4 (EN), U405.4 (EN); also elsewhere on the board
/Power/PULSER_1V8_EN: R420.1, U410.3 (ON); also elsewhere on the board
/Power/SD_3V3_EN: R419.1; also elsewhere on the board
/Power/SOM_PL_PWR_EN: R421.1; also elsewhere on the board
/Power/USB_1V8_EN: R418.1; also elsewhere on the board
AFE1_1V8A: FB401.2; also elsewhere on the board
AFE1_1V8D: FB401.1, FB404.1, U402.1 (OUT), U402.2 (FB); also elsewhere on the board
AFE1_3V3A: FB402.2; also elsewhere on the board
AFE1_3V3D: FB402.1, FB405.1, U403.1 (OUT), U403.2 (FB); also elsewhere on the board
AFE2_1V8A: FB404.2; also elsewhere on the board
AFE2_3V3A: FB405.2; also elsewhere on the board
AFE3_1V8A: FB407.2; also elsewhere on the board
AFE3_1V8D: FB403.1, FB407.1, U404.1 (OUT), U404.2 (FB); also elsewhere on the board
AFE3_3V3A: FB408.2; also elsewhere on the board
AFE3_3V3D: FB406.1, FB408.1, U405.1 (OUT), U405.2 (FB); also elsewhere on the board
AFE4_1V8A: FB403.2; also elsewhere on the board
AFE4_3V3A: FB406.2; also elsewhere on the board
CLK_1V8: C411.1, U406.1 (OUT), U406.2 (FB); also elsewhere on the board
CLK_3V3: JP409.2 (B); also elsewhere on the board
CLK_VCC_PRE: C420.1, JP409.1 (A), R409.1, U407.5 (VOUT)
DC_MAIN: F401.2, R401.1; also elsewhere on the board
DC_MAIN_PRE: C412.1, C413.1, F401.1, J401.1
EXT_3V3: C422.1, U408.1 (OUT), U408.2 (FB); also elsewhere on the board
GND: C401.2, C402.2, C403.2, C404.2, C406.2, C407.2, C408.2, C409.2, C410.2, C411.2, C412.2, C413.2, C415.2, C416.2, C417.2, C419.2, C420.2, C421.2, C422.2, D401.1 (K), D402.1 (K), D403.1 (K), D404.1 (K), D405.1 (K), D406.1 (K), D407.1 (K), D409.1 (K), D410.1 (K), D411.1 (K), J401.2, L401.1, R402.2, R416.2, R417.2, R418.2, R419.2, R420.2, R421.2, U401.2 (GND), U401.7 (PS_GND), U401.11 (EP), U402.3 (GND), U402.7 (EXP), U403.3 (GND), U403.7 (EXP), U404.3 (GND), U404.7 (EXP), U405.3 (GND), U405.7 (EXP), U406.3 (GND), U406.7 (EXP), U407.3 (GND), U407.7 (EP), U408.3 (GND), U408.7 (EXP), U410.2 (GND); also elsewhere on the board
IM_5V: C401.1, C407.1, C408.1, C409.1, C410.1, C415.1, C416.1, C417.1, JP401.2 (B), R403.1, R404.1, U401.5 (IN), U402.6 (IN), U403.6 (IN), U404.6 (IN), U405.6 (IN), U406.4 (EN), U406.6 (IN), U407.4 (VIN), U407.6 (EN), U408.4 (EN), U408.6 (IN); also elsewhere on the board
IM_5V_PRE: JP401.1 (A); also elsewhere on the board
unnamed: C405.2, R413.1
unnamed: D401.2 (A), R401.2
unnamed: D402.2 (A), R403.2
unnamed: D403.2 (A), R405.2
unnamed: D404.2 (A), R406.2
unnamed: D405.2 (A), R407.2
unnamed: D406.2 (A), R408.2
unnamed: D407.2 (A), R409.2
unnamed: D409.2 (A), R412.2
unnamed: D410.2 (A), R414.2
unnamed: D411.2 (A), R415.2
unnamed: C402.1, R404.2, U401.3 (VIN)
PULSER_1V8: C421.1, R414.1, U410.5 (QOD), U410.6 (VOUT); also elsewhere on the board
PULSER_5VN: JP403.2 (B); also elsewhere on the board
PULSER_5VN_PRE: C406.1, D408.A, JP403.1 (A), R411.1, R413.2, U401.8 (OUT)
SD_3V3: JP408.2 (B), R406.1; also elsewhere on the board
SD_3V3_PRE: JP408.1 (A); also elsewhere on the board
SOM_5V: JP402.2 (B), R405.1; also elsewhere on the board
SOM_5V_PRE: JP402.1 (A); also elsewhere on the board
USB_1V8: C419.1, JP407.2 (B), R412.1, U410.1 (VIN); also elsewhere on the board
USB_1V8_PRE: JP407.1 (A); also elsewhere on the board
VDD_HDA: JP405.2 (B), R407.1; also elsewhere on the board
VDD_HDA_PRE: JP405.1 (A); also elsewhere on the board
VDD_HDB: JP404.2 (B), R408.1; also elsewhere on the board
VDD_HDBC_PRE: JP404.1 (A); also elsewhere on the board
VDD_HPA: JP406.2 (B), R415.1; also elsewhere on the board
VDD_HPA_PRE: JP406.1 (A); also elsewhere on the board

Notes on the sheet:
AFE 1 & 2 Supplies
+/-100V
^ x4 = 1.2A
= 52 + 48 + 10 + 8 = 120 mA
HV Supplies (+/- 50/100V)
Main SOM 5V Supply
+/-50V
Pulser -5V Supply
CLOCK 3V3
1V8 Bucks
Processing Section (PL) Supplies
SD Card 3V3
The values of the: - Compensation capacitor (4.7nF) - Inductor (4.7uH for -5V) - Output capacitor (>12uF) - Voltage divider - Feed-forward network Were recommended by the datasheet
Pulser + USB 1V8
CLOCK 1V8
Miscellaneous Supplies
3V3 Bucks
External Interfaces 3V3
AFE LDOs (1.8V & 3V3)
The LC-filter at Vin is recommended by the datasheet.
Pulser + Intermediate 5V Supply
AFE 3 & 4 Supplies
