yusufElnady/Medical-Imager/MedicalImager.kicad_pcb

## KiCad design MedicalImager.kicad_pcb (continued)

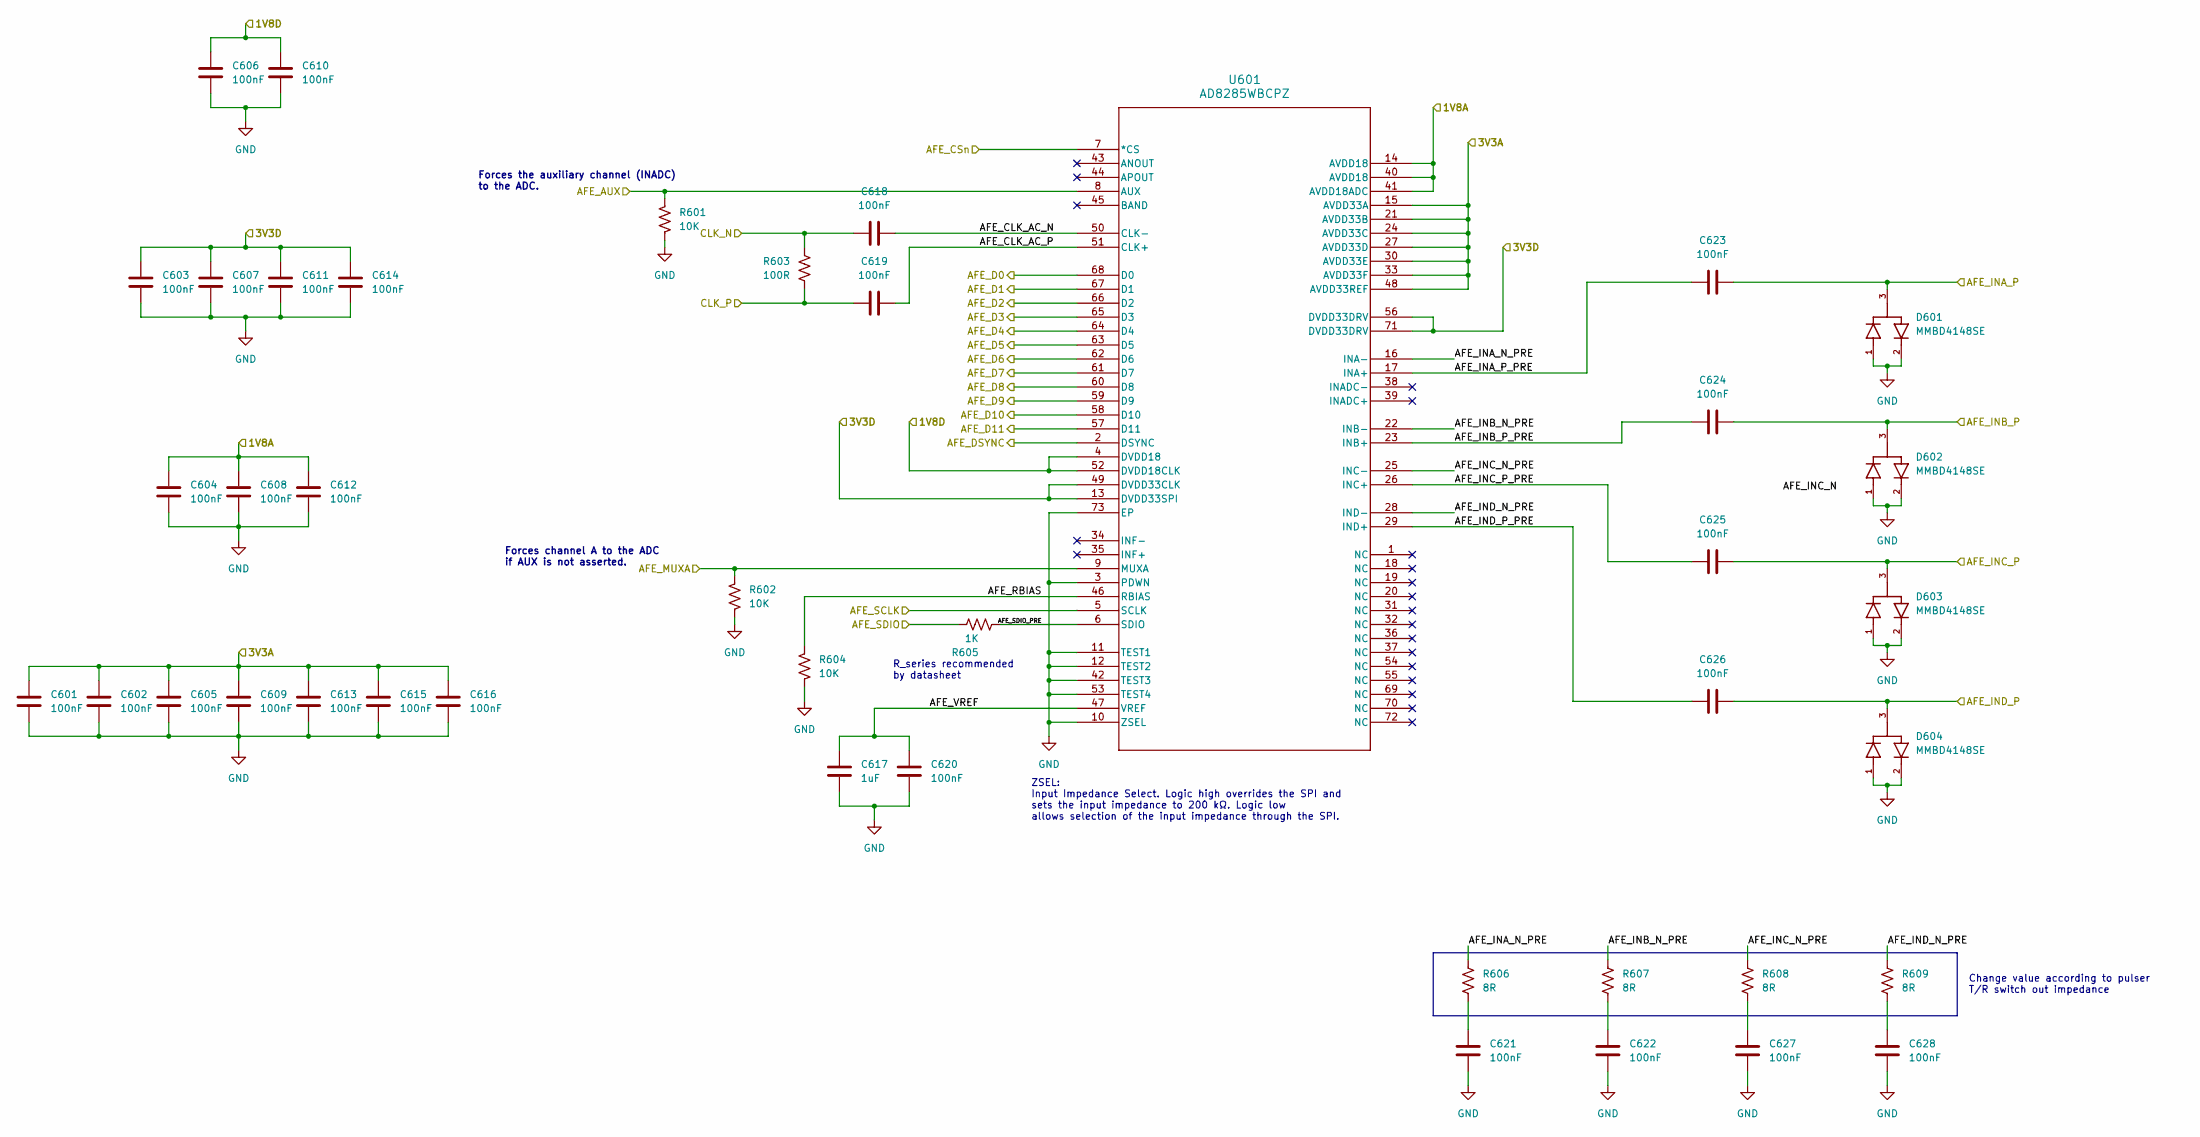
[picture p63: schematic RX_LANE.kicad_sch]

Parts:
C601, C602, C603, C604, C605, C606, C607, C608, C609, C610, C611, C612, C613, C614, C615, C616, C618, C619, C620, C621, C622, C623, C624, C625, C626, C627, C628: 100nF; C_0402_1005Metric
C617: 1uF; C_0402_1005Metric
D601, D602, D603, D604: MMBD4148SE; SOT95P237X112-3N; PARTREV E2001
R601, R602, R604: 10K; R_0402_1005Metric
R603: 100R; R_0402_1005Metric
R605: 1K; R_0402_1005Metric
R606, R607, R608, R609: 8R; R_0402_1005Metric
U601: AD8285WBCPZ; CP_72_5_ADI

Connections:
/RX/AFE1/AFE_CLK_AC_N: C618.2, U601.50 (CLK-)
/RX/AFE1/AFE_CLK_AC_P: C619.2, U601.51 (CLK+)
/RX/AFE1/AFE_INA_N_PRE: R606.1, U601.16 (INA-)
/RX/AFE1/AFE_INA_P_PRE: C623.2, U601.17 (INA+)
/RX/AFE1/AFE_INB_N_PRE: R607.1, U601.22 (INB-)
/RX/AFE1/AFE_INB_P_PRE: C624.2, U601.23 (INB+)
/RX/AFE1/AFE_INC_N_PRE: R608.1, U601.25 (INC-)
/RX/AFE1/AFE_INC_P_PRE: C625.2, U601.26 (INC+)
/RX/AFE1/AFE_IND_N_PRE: R609.1, U601.28 (IND-)
/RX/AFE1/AFE_IND_P_PRE: C626.2, U601.29 (IND+)
/RX/AFE1/AFE_RBIAS: R604.1, U601.46 (RBIAS)
/RX/AFE1/AFE_SDIO_PRE: R605.2, U601.6 (SDIO)
/RX/AFE1/AFE_VREF: C617.1, C620.1, U601.47 (VREF)
/RX/AFE1_AUX: R601.1, U601.8 (AUX); also elsewhere on the board
/RX/AFE1_CSn: U601.7 (*CS); also elsewhere on the board
/RX/AFE1_DSYNC: U601.2 (DSYNC); also elsewhere on the board
/RX/AFE1_MUXA: R602.1, U601.9 (MUXA); also elsewhere on the board
/RX/AFE_OUTPUTS0: U601.68 (D0); also elsewhere on the board
/RX/AFE_OUTPUTS1: U601.67 (D1); also elsewhere on the board
/RX/AFE_OUTPUTS2: U601.66 (D2); also elsewhere on the board
/RX/AFE_OUTPUTS3: U601.65 (D3); also elsewhere on the board
/RX/AFE_OUTPUTS4: U601.64 (D4); also elsewhere on the board
/RX/AFE_OUTPUTS5: U601.63 (D5); also elsewhere on the board
/RX/AFE_OUTPUTS6: U601.62 (D6); also elsewhere on the board
/RX/AFE_OUTPUTS7: U601.61 (D7); also elsewhere on the board
/RX/AFE_OUTPUTS8: U601.60 (D8); also elsewhere on the board
/RX/AFE_OUTPUTS9: U601.59 (D9); also elsewhere on the board
/RX/AFE_OUTPUTS10: U601.58 (D10); also elsewhere on the board
/RX/AFE_OUTPUTS11: U601.57 (D11); also elsewhere on the board
/RX/AFE_SCLK: U601.5 (SCLK); also elsewhere on the board
/RX/AFE_SDIO: R605.1; also elsewhere on the board
/RX/CLKOUT_B1_N: C618.1, R603.1; also elsewhere on the board
/RX/CLKOUT_B1_P: C619.1, R603.2; also elsewhere on the board
/RX/TR_OUT0: C623.1, D601.3; also elsewhere on the board
/RX/TR_OUT1: C624.1, D602.3; also elsewhere on the board
/RX/TR_OUT2: C625.1, D603.3; also elsewhere on the board
/RX/TR_OUT3: C626.1, D604.3; also elsewhere on the board
AFE1_1V8A: C604.1, C608.1, C612.1, U601.14 (AVDD18), U601.40 (AVDD18), U601.41 (AVDD18ADC); also elsewhere on the board
AFE1_1V8D: C606.1, C610.1, U601.4 (DVDD18), U601.52 (DVDD18CLK); also elsewhere on the board
AFE1_3V3A: C601.1, C602.1, C605.1, C609.1, C613.1, C615.1, C616.1, U601.15 (AVDD33A), U601.21 (AVDD33B), U601.24 (AVDD33C), U601.27 (AVDD33D), U601.30 (AVDD33E), U601.33 (AVDD33F), U601.48 (AVDD33REF); also elsewhere on the board
AFE1_3V3D: C603.1, C607.1, C611.1, C614.1, U601.13 (DVDD33SPI), U601.49 (DVDD33CLK), U601.56 (DVDD33DRV), U601.71 (DVDD33DRV); also elsewhere on the board
GND: C601.2, C602.2, C603.2, C604.2, C605.2, C606.2, C607.2, C608.2, C609.2, C610.2, C611.2, C612.2, C613.2, C614.2, C615.2, C616.2, C617.2, C620.2, C621.2, C622.2, C627.2, C628.2, D601.1, D601.2, D602.1, D602.2, D603.1, D603.2, D604.1, D604.2, R601.2, R602.2, R604.2, U601.3 (PDWN), U601.10 (ZSEL), U601.11 (TEST1), U601.12 (TEST2), U601.42 (TEST3), U601.53 (TEST4), U601.73 (EP); also elsewhere on the board
unnamed: C621.1, R606.2
unnamed: C622.1, R607.2
unnamed: C627.1, R608.2
unnamed: C628.1, R609.2

Parts of its further copies:
C701, C702, C703, C704, C705, C706, C707, C708, C709, C710, C711, C712, C713, C714, C715, C716, C718, C719, C720, C721, C722, C723, C724, C725, C726, C727, C728, C801, C802, C803, C804, C805, C806, C807, C808, C809, C810, C811, C812, C813, C814, C815, C816, C818, C819, C820, C821, C822, C823, C824, C825, C826, C827, C828, C901, C902, C903, C904, C905, C906, C907, C908, C909, C910, C911, C912, C913, C914, C915, C916, C918, C919, C920, C921, C922, C923, C924, C925, C926, C927, C928: 100nF; C_0402_1005Metric
C717, C817, C917: 1uF; C_0402_1005Metric
D701, D702, D703, D704, D801, D802, D803, D804, D901, D902, D903, D904: MMBD4148SE; SOT95P237X112-3N; PARTREV E2001
R701, R702, R704, R801, R802, R804, R901, R902, R904: 10K; R_0402_1005Metric
R703, R803, R903: 100R; R_0402_1005Metric
R705, R805, R905: 1K; R_0402_1005Metric
R706, R707, R708, R709, R806, R807, R808, R809, R906, R907, R908, R909: 8R; R_0402_1005Metric
U701, U801, U901: AD8285WBCPZ; CP_72_5_ADI

Connections of its further copies:
/RX/AFE2/AFE_CLK_AC_N: C718.2, U701.50 (CLK-)
/RX/AFE2/AFE_CLK_AC_P: C719.2, U701.51 (CLK+)
/RX/AFE2/AFE_INA_N_PRE: R706.1, U701.16 (INA-)
/RX/AFE2/AFE_INA_P_PRE: C723.2, U701.17 (INA+)
/RX/AFE2/AFE_INB_N_PRE: R707.1, U701.22 (INB-)
/RX/AFE2/AFE_INB_P_PRE: C724.2, U701.23 (INB+)
/RX/AFE2/AFE_INC_N_PRE: R708.1, U701.25 (INC-)
/RX/AFE2/AFE_INC_P_PRE: C725.2, U701.26 (INC+)
/RX/AFE2/AFE_IND_N_PRE: R709.1, U701.28 (IND-)
/RX/AFE2/AFE_IND_P_PRE: C726.2, U701.29 (IND+)
/RX/AFE2/AFE_RBIAS: R704.1, U701.46 (RBIAS)
/RX/AFE2/AFE_SDIO_PRE: R705.2, U701.6 (SDIO)
/RX/AFE2/AFE_VREF: C717.1, C720.1, U701.47 (VREF)
/RX/AFE2_AUX: R701.1, U701.8 (AUX); also elsewhere on the board
/RX/AFE2_CSn: U701.7 (*CS); also elsewhere on the board
/RX/AFE2_DSYNC: U701.2 (DSYNC); also elsewhere on the board
/RX/AFE2_MUXA: R702.1, U701.9 (MUXA); also elsewhere on the board
/RX/AFE3/AFE_CLK_AC_N: C818.2, U801.50 (CLK-)
/RX/AFE3/AFE_CLK_AC_P: C819.2, U801.51 (CLK+)
/RX/AFE3/AFE_INA_N_PRE: R806.1, U801.16 (INA-)
/RX/AFE3/AFE_INA_P_PRE: C823.2, U801.17 (INA+)
/RX/AFE3/AFE_INB_N_PRE: R807.1, U801.22 (INB-)
/RX/AFE3/AFE_INB_P_PRE: C824.2, U801.23 (INB+)
/RX/AFE3/AFE_INC_N_PRE: R808.1, U801.25 (INC-)
/RX/AFE3/AFE_INC_P_PRE: C825.2, U801.26 (INC+)
/RX/AFE3/AFE_IND_N_PRE: R809.1, U801.28 (IND-)
/RX/AFE3/AFE_IND_P_PRE: C826.2, U801.29 (IND+)
/RX/AFE3/AFE_RBIAS: R804.1, U801.46 (RBIAS)
/RX/AFE3/AFE_SDIO_PRE: R805.2, U801.6 (SDIO)
/RX/AFE3/AFE_VREF: C817.1, C820.1, U801.47 (VREF)
/RX/AFE3_AUX: R801.1, U801.8 (AUX); also elsewhere on the board
/RX/AFE3_CSn: U801.7 (*CS); also elsewhere on the board
/RX/AFE3_DSYNC: U801.2 (DSYNC); also elsewhere on the board
/RX/AFE3_MUXA: R802.1, U801.9 (MUXA); also elsewhere on the board
/RX/AFE4/AFE_CLK_AC_N: C918.2, U901.50 (CLK-)
/RX/AFE4/AFE_CLK_AC_P: C919.2, U901.51 (CLK+)
/RX/AFE4/AFE_INA_N_PRE: R906.1, U901.16 (INA-)
/RX/AFE4/AFE_INA_P_PRE: C923.2, U901.17 (INA+)
/RX/AFE4/AFE_INB_N_PRE: R907.1, U901.22 (INB-)
/RX/AFE4/AFE_INB_P_PRE: C924.2, U901.23 (INB+)
/RX/AFE4/AFE_INC_N_PRE: R908.1, U901.25 (INC-)
/RX/AFE4/AFE_INC_P_PRE: C925.2, U901.26 (INC+)
/RX/AFE4/AFE_IND_N_PRE: R909.1, U901.28 (IND-)
/RX/AFE4/AFE_IND_P_PRE: C926.2, U901.29 (IND+)
/RX/AFE4/AFE_RBIAS: R904.1, U901.46 (RBIAS)
/RX/AFE4/AFE_SDIO_PRE: R905.2, U901.6 (SDIO)
/RX/AFE4/AFE_VREF: C917.1, C920.1, U901.47 (VREF)
/RX/AFE4_AUX: R901.1, U901.8 (AUX); also elsewhere on the board
/RX/AFE4_CSn: U901.7 (*CS); also elsewhere on the board
/RX/AFE4_DSYNC: U901.2 (DSYNC); also elsewhere on the board
/RX/AFE4_MUXA: R902.1, U901.9 (MUXA); also elsewhere on the board
/RX/AFE_OUTPUTS12: U701.68 (D0); also elsewhere on the board
/RX/AFE_OUTPUTS13: U701.67 (D1); also elsewhere on the board
/RX/AFE_OUTPUTS14: U701.66 (D2); also elsewhere on the board
/RX/AFE_OUTPUTS15: U701.65 (D3); also elsewhere on the board
/RX/AFE_OUTPUTS16: U701.64 (D4); also elsewhere on the board
/RX/AFE_OUTPUTS17: U701.63 (D5); also elsewhere on the board
/RX/AFE_OUTPUTS18: U701.62 (D6); also elsewhere on the board
/RX/AFE_OUTPUTS19: U701.61 (D7); also elsewhere on the board
/RX/AFE_OUTPUTS20: U701.60 (D8); also elsewhere on the board
/RX/AFE_OUTPUTS21: U701.59 (D9); also elsewhere on the board
/RX/AFE_OUTPUTS22: U701.58 (D10); also elsewhere on the board
/RX/AFE_OUTPUTS23: U701.57 (D11); also elsewhere on the board
/RX/AFE_OUTPUTS24: U801.68 (D0); also elsewhere on the board
/RX/AFE_OUTPUTS25: U801.67 (D1); also elsewhere on the board
/RX/AFE_OUTPUTS26: U801.66 (D2); also elsewhere on the board
/RX/AFE_OUTPUTS27: U801.65 (D3); also elsewhere on the board
/RX/AFE_OUTPUTS28: U801.64 (D4); also elsewhere on the board
/RX/AFE_OUTPUTS29: U801.63 (D5); also elsewhere on the board
/RX/AFE_OUTPUTS30: U801.62 (D6); also elsewhere on the board
/RX/AFE_OUTPUTS31: U801.61 (D7); also elsewhere on the board
/RX/AFE_OUTPUTS32: U801.60 (D8); also elsewhere on the board
/RX/AFE_OUTPUTS33: U801.59 (D9); also elsewhere on the board
/RX/AFE_OUTPUTS34: U801.58 (D10); also elsewhere on the board
/RX/AFE_OUTPUTS35: U801.57 (D11); also elsewhere on the board
/RX/AFE_OUTPUTS36: U901.68 (D0); also elsewhere on the board
/RX/AFE_OUTPUTS37: U901.67 (D1); also elsewhere on the board
/RX/AFE_OUTPUTS38: U901.66 (D2); also elsewhere on the board
/RX/AFE_OUTPUTS39: U901.65 (D3); also elsewhere on the board
/RX/AFE_OUTPUTS40: U901.64 (D4); also elsewhere on the board
/RX/AFE_OUTPUTS41: U901.63 (D5); also elsewhere on the board
/RX/AFE_OUTPUTS42: U901.62 (D6); also elsewhere on the board
/RX/AFE_OUTPUTS43: U901.61 (D7); also elsewhere on the board
/RX/AFE_OUTPUTS44: U901.60 (D8); also elsewhere on the board
/RX/AFE_OUTPUTS45: U901.59 (D9); also elsewhere on the board
/RX/AFE_OUTPUTS46: U901.58 (D10); also elsewhere on the board
/RX/AFE_OUTPUTS47: U901.57 (D11); also elsewhere on the board
/RX/AFE_SCLK: U701.5 (SCLK), U801.5 (SCLK), U901.5 (SCLK); also elsewhere on the board
/RX/AFE_SDIO: R705.1, R805.1, R905.1; also elsewhere on the board
/RX/CLKOUT_A0_N: C918.1, R903.1; also elsewhere on the board
/RX/CLKOUT_A0_P: C919.1, R903.2; also elsewhere on the board
/RX/CLKOUT_A1_N: C818.1, R803.1; also elsewhere on the board
/RX/CLKOUT_A1_P: C819.1, R803.2; also elsewhere on the board
/RX/CLKOUT_B0_N: C718.1, R703.1; also elsewhere on the board
/RX/CLKOUT_B0_P: C719.1, R703.2; also elsewhere on the board
/RX/TR_OUT4: C723.1, D701.3; also elsewhere on the board
/RX/TR_OUT5: C724.1, D702.3; also elsewhere on the board
/RX/TR_OUT6: C725.1, D703.3; also elsewhere on the board
/RX/TR_OUT7: C726.1, D704.3; also elsewhere on the board
/RX/TR_OUT8: C823.1, D801.3; also elsewhere on the board
/RX/TR_OUT9: C824.1, D802.3; also elsewhere on the board
/RX/TR_OUT10: C825.1, D803.3; also elsewhere on the board
/RX/TR_OUT11: C826.1, D804.3; also elsewhere on the board
/RX/TR_OUT12: C923.1, D901.3; also elsewhere on the board
/RX/TR_OUT13: C924.1, D902.3; also elsewhere on the board
/RX/TR_OUT14: C925.1, D903.3; also elsewhere on the board
/RX/TR_OUT15: C926.1, D904.3; also elsewhere on the board
AFE1_1V8D: C706.1, C710.1, U701.4 (DVDD18), U701.52 (DVDD18CLK); also elsewhere on the board
AFE1_3V3D: C703.1, C707.1, C711.1, C714.1, U701.13 (DVDD33SPI), U701.49 (DVDD33CLK), U701.56 (DVDD33DRV), U701.71 (DVDD33DRV); also elsewhere on the board
AFE2_1V8A: C704.1, C708.1, C712.1, U701.14 (AVDD18), U701.40 (AVDD18), U701.41 (AVDD18ADC); also elsewhere on the board
AFE2_3V3A: C701.1, C702.1, C705.1, C709.1, C713.1, C715.1, C716.1, U701.15 (AVDD33A), U701.21 (AVDD33B), U701.24 (AVDD33C), U701.27 (AVDD33D), U701.30 (AVDD33E), U701.33 (AVDD33F), U701.48 (AVDD33REF); also elsewhere on the board
AFE3_1V8A: C804.1, C808.1, C812.1, U801.14 (AVDD18), U801.40 (AVDD18), U801.41 (AVDD18ADC); also elsewhere on the board
AFE3_1V8D: C806.1, C810.1, C906.1, C910.1, U801.4 (DVDD18), U801.52 (DVDD18CLK), U901.4 (DVDD18), U901.52 (DVDD18CLK); also elsewhere on the board
AFE3_3V3A: C801.1, C802.1, C805.1, C809.1, C813.1, C815.1, C816.1, U801.15 (AVDD33A), U801.21 (AVDD33B), U801.24 (AVDD33C), U801.27 (AVDD33D), U801.30 (AVDD33E), U801.33 (AVDD33F), U801.48 (AVDD33REF); also elsewhere on the board
AFE3_3V3D: C803.1, C807.1, C811.1, C814.1, C903.1, C907.1, C911.1, C914.1, U801.13 (DVDD33SPI), U801.49 (DVDD33CLK), U801.56 (DVDD33DRV), U801.71 (DVDD33DRV), U901.13 (DVDD33SPI), U901.49 (DVDD33CLK), U901.56 (DVDD33DRV), U901.71 (DVDD33DRV); also elsewhere on the board
AFE4_1V8A: C904.1, C908.1, C912.1, U901.14 (AVDD18), U901.40 (AVDD18), U901.41 (AVDD18ADC); also elsewhere on the board
AFE4_3V3A: C901.1, C902.1, C905.1, C909.1, C913.1, C915.1, C916.1, U901.15 (AVDD33A), U901.21 (AVDD33B), U901.24 (AVDD33C), U901.27 (AVDD33D), U901.30 (AVDD33E), U901.33 (AVDD33F), U901.48 (AVDD33REF); also elsewhere on the board
GND: C701.2, C702.2, C703.2, C704.2, C705.2, C706.2, C707.2, C708.2, C709.2, C710.2, C711.2, C712.2, C713.2, C714.2, C715.2, C716.2, C717.2, C720.2, C721.2, C722.2, C727.2, C728.2, C801.2, C802.2, C803.2, C804.2, C805.2, C806.2, C807.2, C808.2, C809.2, C810.2, C811.2, C812.2, C813.2, C814.2, C815.2, C816.2, C817.2, C820.2, C821.2, C822.2, C827.2, C828.2, C901.2, C902.2, C903.2, C904.2, C905.2, C906.2, C907.2, C908.2, C909.2, C910.2, C911.2, C912.2, C913.2, C914.2, C915.2, C916.2, C917.2, C920.2, C921.2, C922.2, C927.2, C928.2, D701.1, D701.2, D702.1, D702.2, D703.1, D703.2, D704.1, D704.2, D801.1, D801.2, D802.1, D802.2, D803.1, D803.2, D804.1, D804.2, D901.1, D901.2, D902.1, D902.2, D903.1, D903.2, D904.1, D904.2, R701.2, R702.2, R704.2, R801.2, R802.2, R804.2, R901.2, R902.2, R904.2, U701.3 (PDWN), U701.10 (ZSEL), U701.11 (TEST1), U701.12 (TEST2), U701.42 (TEST3), U701.53 (TEST4), U701.73 (EP), U801.3 (PDWN), U801.10 (ZSEL), U801.11 (TEST1), U801.12 (TEST2), U801.42 (TEST3), U801.53 (TEST4), U801.73 (EP), U901.3 (PDWN), U901.10 (ZSEL), U901.11 (TEST1), U901.12 (TEST2), U901.42 (TEST3), U901.53 (TEST4), U901.73 (EP); also elsewhere on the board
unnamed: C721.1, R706.2
unnamed: C722.1, R707.2
unnamed: C727.1, R708.2
unnamed: C728.1, R709.2
unnamed: C821.1, R806.2
unnamed: C822.1, R807.2
unnamed: C827.1, R808.2
unnamed: C828.1, R809.2
unnamed: C921.1, R906.2
unnamed: C922.1, R907.2
unnamed: C927.1, R908.2
unnamed: C928.1, R909.2

Notes on the sheet:
ZSEL: Input Impedance Select. Logic high overrides the SPI and sets the input impedance to 200 kΩ. Logic low allows selection of the input impedance through the SPI.
Forces channel A to the ADC if AUX is not asserted.
R_series recommended by datasheet
Change value according to pulser T/R switch out impedance
Forces the auxiliary channel (INADC) to the ADC.

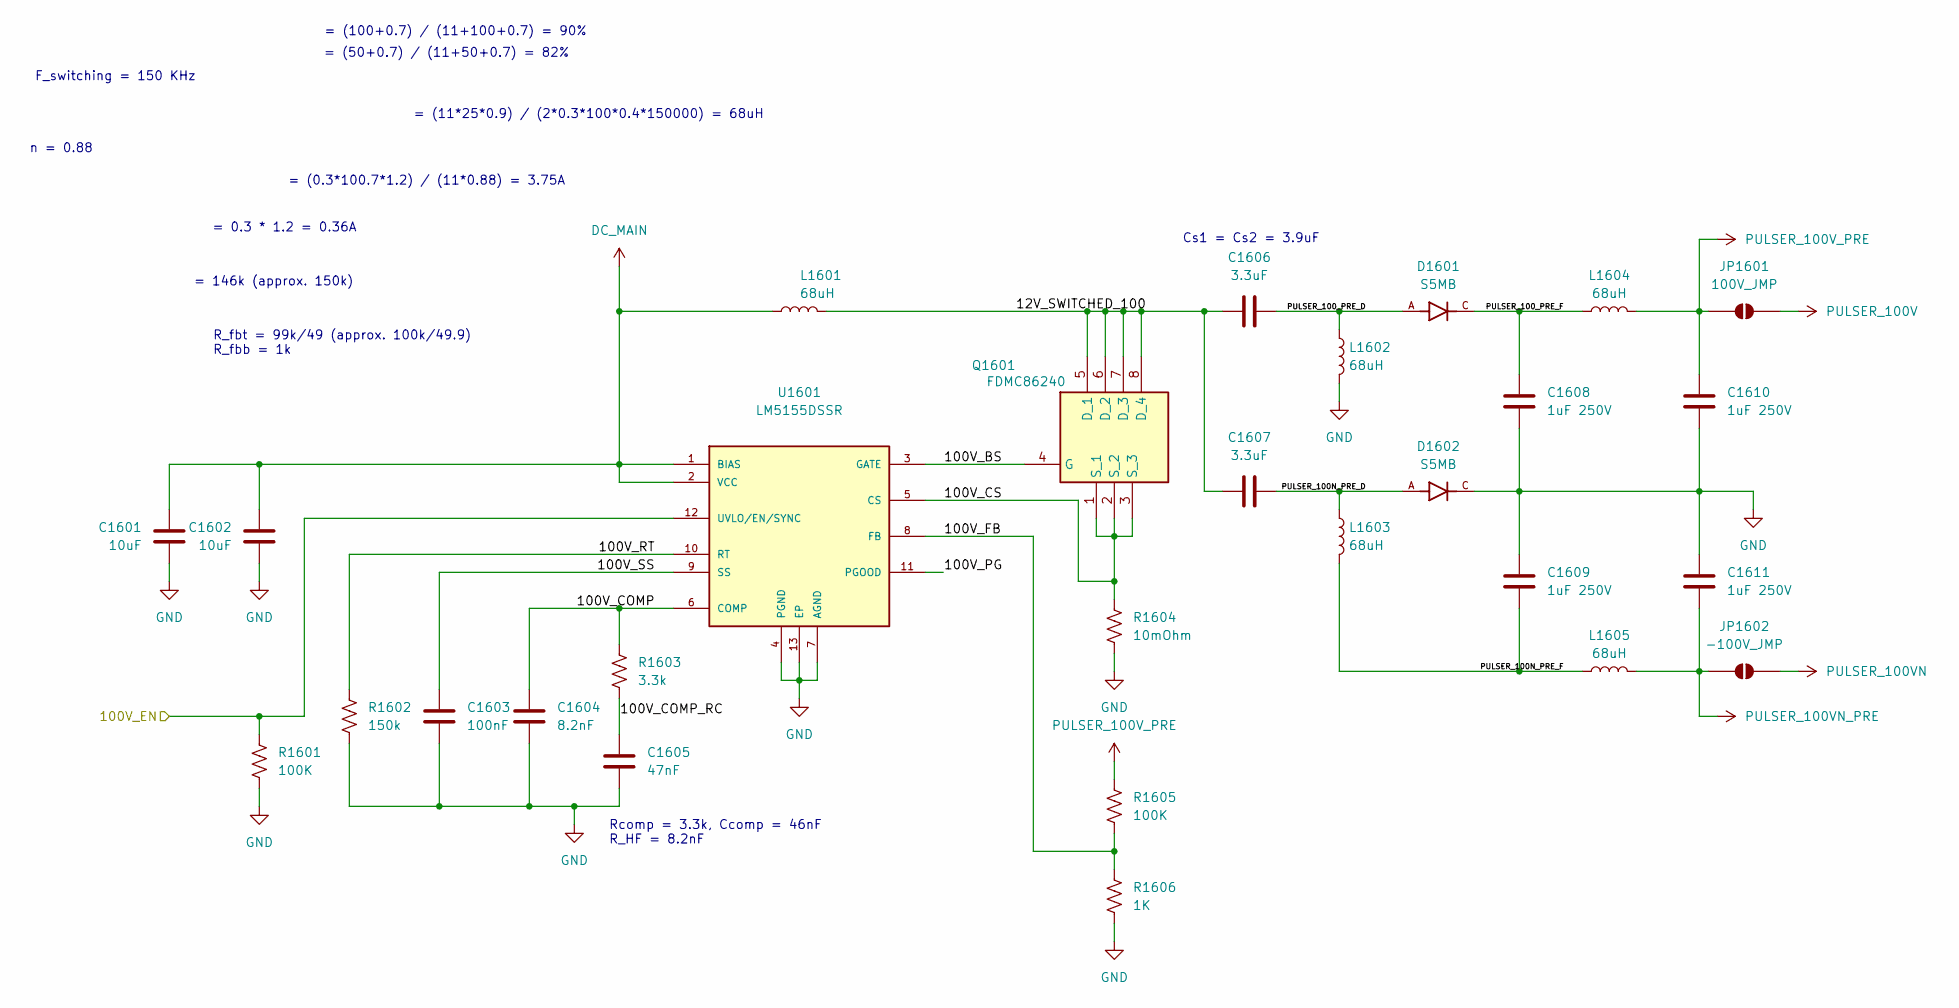
[picture p64: schematic 100V_Supply.kicad_sch]

Parts:
C1601, C1602: 10uF; C_0805_2012Metric
C1603: 100nF; C_0402_1005Metric
C1604: 8.2nF; C_0402_1005Metric
C1605: 47nF; C_0402_1005Metric
C1606, C1607: 3.3uF; C_2220_5750Metric
C1608, C1609, C1610, C1611: 1uF 250V; C_1812_4532Metric
D1601, D1602: S5MB; DIOM4336X265N; PARTREV K2102
JP1601: 100V_JMP; SolderJumper-2_P1.3mm_Open_TrianglePad1.0x1.5mm
JP1602: -100V_JMP; SolderJumper-2_P1.3mm_Open_TrianglePad1.0x1.5mm
L1601: 68uH; L_Panasonic_PCC-M0854M
L1602, L1603, L1604, L1605: 68uH; L_Cenker_CKCS4018
Q1601: FDMC86240; FDMC86139P; Manufacturer_Part_Number FDMC86240; Mouser Part Number 512-FDMC86240
R1601, R1605: 100K; R_0402_1005Metric
R1602: 150k; R_0402_1005Metric
R1603: 3.3k; R_0402_1005Metric
R1604: 10mOhm; R_0603_1608Metric
R1606: 1K; R_0402_1005Metric
U1601: LM5155DSSR; IC_LM5155DSSR; PARTREV E

Connections:
/Power/100V_EN: R1601.1, U1601.12 (UVLO/EN/SYNC); also elsewhere on the board
/Power/100V_SUPPLY/12V_SWITCHED_100: C1606.1, C1607.1, L1601.1, Q1601.5 (D_1), Q1601.6 (D_2), Q1601.7 (D_3), Q1601.8 (D_4)
/Power/100V_SUPPLY/100V_BS: Q1601.4 (G), U1601.3 (GATE)
/Power/100V_SUPPLY/100V_COMP: C1604.1, R1603.1, U1601.6 (COMP)
/Power/100V_SUPPLY/100V_COMP_RC: C1605.1, R1603.2
/Power/100V_SUPPLY/100V_CS: Q1601.1 (S_1), Q1601.2 (S_2), Q1601.3 (S_3), R1604.2, U1601.5 (CS)
/Power/100V_SUPPLY/100V_FB: R1605.2, R1606.1, U1601.8 (FB)
/Power/100V_SUPPLY/100V_PG: U1601.11 (PGOOD)
/Power/100V_SUPPLY/100V_RT: R1602.1, U1601.10 (RT)
/Power/100V_SUPPLY/100V_SS: C1603.2, U1601.9 (SS)
/Power/100V_SUPPLY/PULSER_100N_PRE_D: C1607.2, D1602.A, L1603.1
/Power/100V_SUPPLY/PULSER_100N_PRE_F: C1609.2, L1603.2, L1605.1
/Power/100V_SUPPLY/PULSER_100_PRE_D: C1606.2, D1601.A, L1602.1
/Power/100V_SUPPLY/PULSER_100_PRE_F: C1608.1, D1601.C, L1604.1
DC_MAIN: C1601.1, C1602.1, L1601.2, U1601.1 (BIAS), U1601.2 (VCC); also elsewhere on the board
GND: C1601.2, C1602.2, C1603.1, C1604.2, C1605.2, C1608.2, C1609.1, C1610.2, C1611.1, D1602.C, L1602.2, R1601.2, R1602.2, R1604.1, R1606.2, U1601.4 (PGND), U1601.7 (AGND), U1601.13 (EP); also elsewhere on the board
PULSER_100V: JP1601.2 (B); also elsewhere on the board
PULSER_100VN: JP1602.2 (B); also elsewhere on the board
PULSER_100VN_PRE: C1611.2, JP1602.1 (A), L1605.2
PULSER_100V_PRE: C1610.1, JP1601.1 (A), L1604.2, R1605.1

Notes on the sheet:
F_switching = 150 KHz
Cs1 = Cs2 = 3.9uF
= (100+0.7) / (11+100+0.7) = 90%
Rcomp = 3.3k, Ccomp = 46nF R_HF = 8.2nF
= 146k (approx. 150k)
n = 0.88
= (11*25*0.9) / (2*0.3*100*0.4*150000) = 68uH
= 0.3 * 1.2 = 0.36A
R_fbt = 99k/49 (approx. 100k/49.9) R_fbb = 1k
= (50+0.7) / (11+50+0.7) = 82%
= (0.3*100.7*1.2) / (11*0.88) = 3.75A

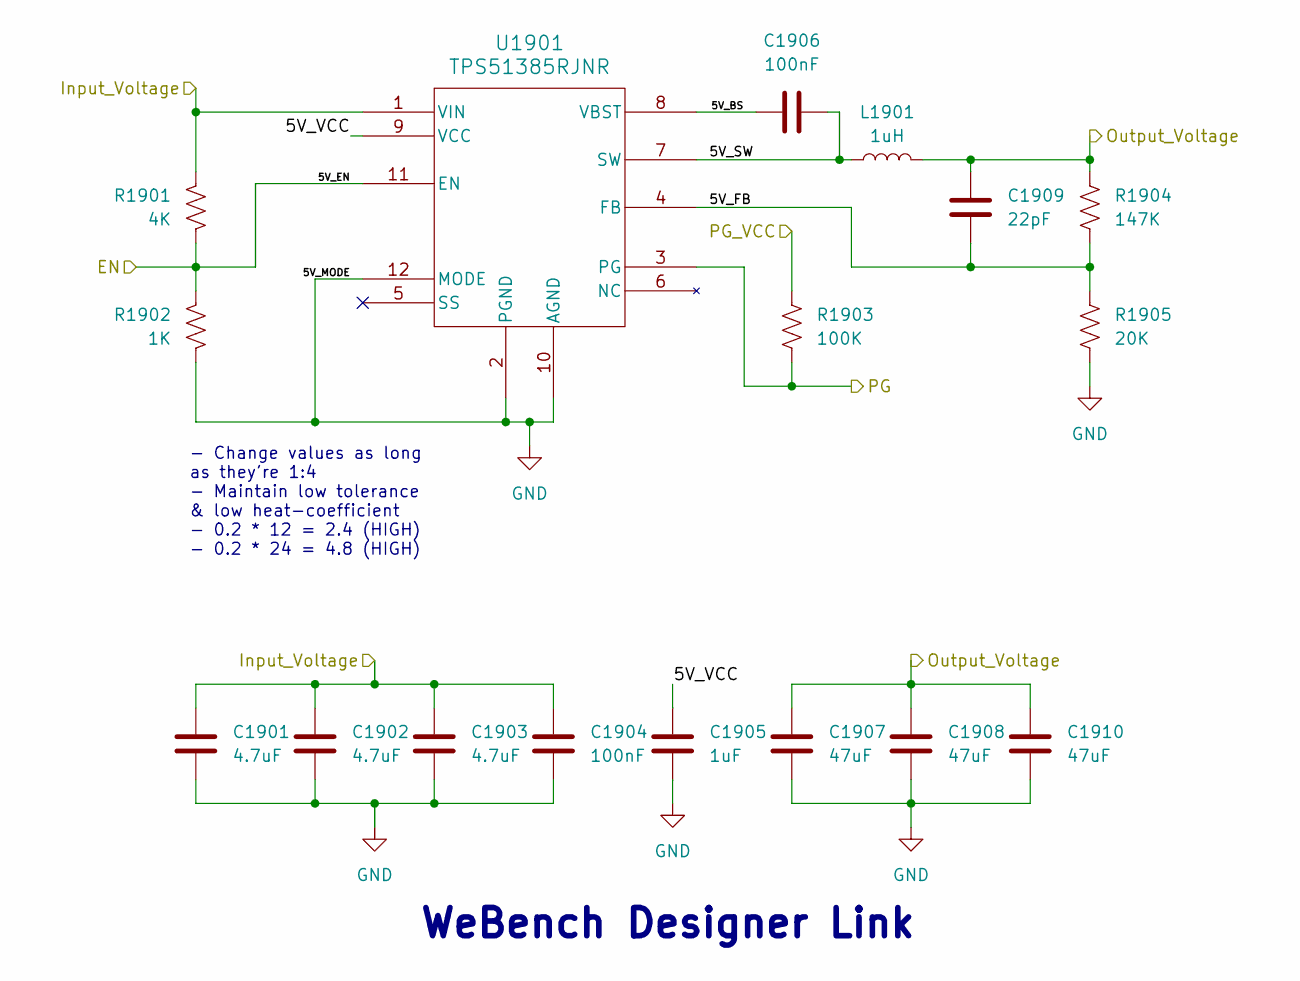
[picture p65: schematic 5V_BUCK.kicad_sch]

Parts:
C1901, C1902, C1903: 4.7uF; C_0805_2012Metric
C1904, C1906: 100nF; C_0402_1005Metric
C1905: 1uF; C_0402_1005Metric
C1907, C1908, C1910: 47uF; C_0805_2012Metric
C1909: 22pF; C_0402_1005Metric
L1901: 1uH; L_10.4x10.4_H4.8
R1901: 4K; R_0402_1005Metric
R1902: 1K; R_0402_1005Metric
R1903: 100K; R_0402_1005Metric
R1904: 147K; R_0402_1005Metric
R1905: 20K; R_0402_1005Metric
U1901: TPS51385RJNR; VQFN-HR12_RJN_TEX

Connections:
/Power/SOM_5V/5V_BS: C1906.1, U1901.8 (VBST)
/Power/SOM_5V/5V_EN: R1901.2, R1902.1, U1901.11 (EN)
/Power/SOM_5V/5V_FB: C1909.2, R1904.2, R1905.1, U1901.4 (FB)
/Power/SOM_5V/5V_SW: C1906.2, L1901.1, U1901.7 (SW)
/Power/SOM_5V/5V_VCC: C1905.1, U1901.9 (VCC)
/Power/SOM_5V/PG: R1903.2, U1901.3 (PG)
DC_MAIN: C1901.1, C1902.1, C1903.1, C1904.1, R1901.1, U1901.1 (VIN); also elsewhere on the board
GND: C1901.2, C1902.2, C1903.2, C1904.2, C1905.2, C1907.2, C1908.2, C1910.2, R1902.2, R1905.2, U1901.2 (PGND), U1901.10 (AGND), U1901.12 (MODE); also elsewhere on the board
SOM_5V_PRE: C1907.1, C1908.1, C1909.1, C1910.1, L1901.2, R1904.1; also elsewhere on the board
VDD_HPA: R1903.1; also elsewhere on the board

Parts of its further copies:
C2001, C2002, C2003: 4.7uF; C_0805_2012Metric
C2004, C2006: 100nF; C_0402_1005Metric
C2005: 1uF; C_0402_1005Metric
C2007, C2008, C2010: 47uF; C_0805_2012Metric
C2009: 22pF; C_0402_1005Metric
L2001: 1uH; L_10.4x10.4_H4.8
R2001: 4K; R_0402_1005Metric
R2002: 1K; R_0402_1005Metric
R2003: 100K; R_0402_1005Metric
R2004: 147K; R_0402_1005Metric
R2005: 20K; R_0402_1005Metric
U2001: TPS51385RJNR; VQFN-HR12_RJN_TEX

Connections of its further copies:
/Power/IM_5V/5V_BS: C2006.1, U2001.8 (VBST)
/Power/IM_5V/5V_EN: R2001.2, R2002.1, U2001.11 (EN); also elsewhere on the board
/Power/IM_5V/5V_FB: C2009.2, R2004.2, R2005.1, U2001.4 (FB)
/Power/IM_5V/5V_SW: C2006.2, L2001.1, U2001.7 (SW)
/Power/IM_5V/5V_VCC: C2005.1, U2001.9 (VCC)
/Power/IM_5V/PG: R2003.2, U2001.3 (PG)
DC_MAIN: C2001.1, C2002.1, C2003.1, C2004.1, R2001.1, U2001.1 (VIN); also elsewhere on the board
GND: C2001.2, C2002.2, C2003.2, C2004.2, C2005.2, C2007.2, C2008.2, C2010.2, R2002.2, R2005.2, U2001.2 (PGND), U2001.10 (AGND), U2001.12 (MODE); also elsewhere on the board
IM_5V_PRE: C2007.1, C2008.1, C2009.1, C2010.1, L2001.2, R2004.1; also elsewhere on the board
VDD_HPA: R2003.1; also elsewhere on the board

Notes on the sheet:
- Change values as long as they're 1:4 - Maintain low tolerance & low heat-coefficient - 0.2 * 12 = 2.4 (HIGH) - 0.2 * 24 = 4.8 (HIGH)
WeBench Designer Link

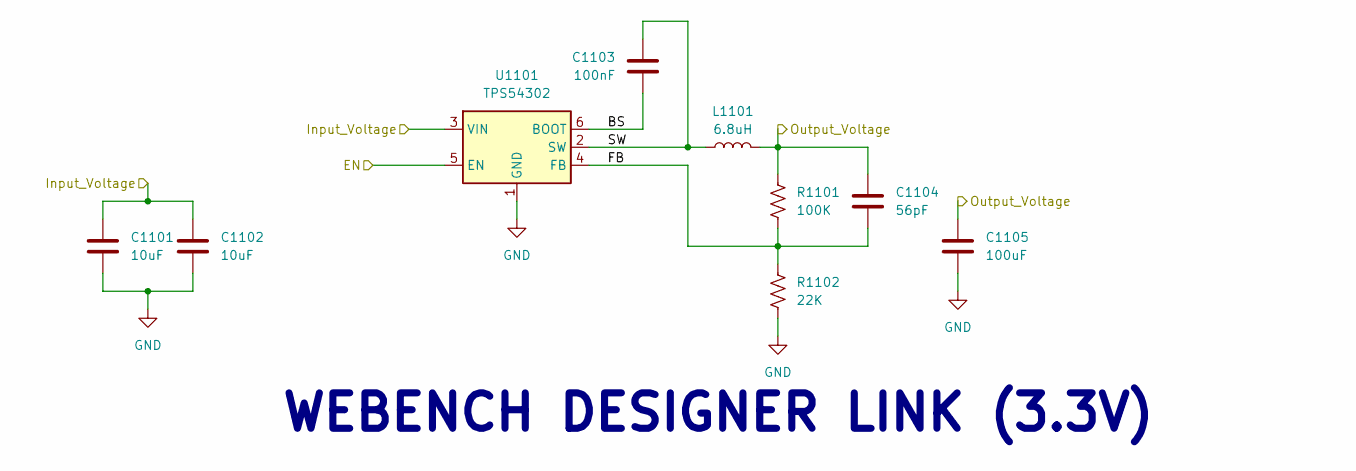
[picture p66: schematic 3V3_BUCK.kicad_sch]

Parts:
C1101, C1102: 10uF; C_0805_2012Metric
C1103: 100nF; C_0402_1005Metric
C1104: 56pF; C_0402_1005Metric
C1105: 100uF; C_0805_2012Metric
L1101: 6.8uH; L_6.3x6.3_H3
R1101: 100K; R_0402_1005Metric
R1102: 22K; R_0402_1005Metric
U1101: TPS54302; SOT-23-6

Connections:
/Power/SOM_HDC_3V3/BS: C1103.1, U1101.6 (BOOT)
/Power/SOM_HDC_3V3/FB: C1104.2, R1101.2, R1102.1, U1101.4 (FB)
/Power/SOM_HDC_3V3/SW: C1103.2, L1101.1, U1101.2 (SW)
/Power/SOM_PL_PWR_EN: U1101.5 (EN); also elsewhere on the board
DC_MAIN: C1101.1, C1102.1, U1101.3 (VIN); also elsewhere on the board
GND: C1101.2, C1102.2, C1105.2, R1102.2, U1101.1 (GND); also elsewhere on the board
VDD_HDBC_PRE: C1104.1, C1105.1, L1101.2, R1101.1; also elsewhere on the board

Parts of its further copies:
C1501, C1502, C1801, C1802: 10uF; C_0805_2012Metric
C1503, C1803: 100nF; C_0402_1005Metric
C1504, C1804: 56pF; C_0402_1005Metric
C1505, C1805: 100uF; C_0805_2012Metric
L1501, L1801: 6.8uH; L_6.3x6.3_H3
R1501, R1801: 100K; R_0402_1005Metric
R1502, R1802: 22K; R_0402_1005Metric
U1501, U1801: TPS54302; SOT-23-6

Connections of its further copies:
/Power/SD_3V3_EN: U1801.5 (EN); also elsewhere on the board
/Power/SD_CARD_3V3/BS: C1803.1, U1801.6 (BOOT)
/Power/SD_CARD_3V3/FB: C1804.2, R1801.2, R1802.1, U1801.4 (FB)
/Power/SD_CARD_3V3/SW: C1803.2, L1801.1, U1801.2 (SW)
/Power/SOM_HDA_3V3/BS: C1503.1, U1501.6 (BOOT)
/Power/SOM_HDA_3V3/FB: C1504.2, R1501.2, R1502.1, U1501.4 (FB)
/Power/SOM_HDA_3V3/SW: C1503.2, L1501.1, U1501.2 (SW)
/Power/SOM_PL_PWR_EN: U1501.5 (EN); also elsewhere on the board
DC_MAIN: C1501.1, C1502.1, C1801.1, C1802.1, U1501.3 (VIN), U1801.3 (VIN); also elsewhere on the board
GND: C1501.2, C1502.2, C1505.2, C1801.2, C1802.2, C1805.2, R1502.2, R1802.2, U1501.1 (GND), U1801.1 (GND); also elsewhere on the board
SD_3V3_PRE: C1804.1, C1805.1, L1801.2, R1801.1; also elsewhere on the board
VDD_HDA_PRE: C1504.1, C1505.1, L1501.2, R1501.1; also elsewhere on the board

Notes on the sheet:
WEBENCH DESIGNER LINK (3.3V)

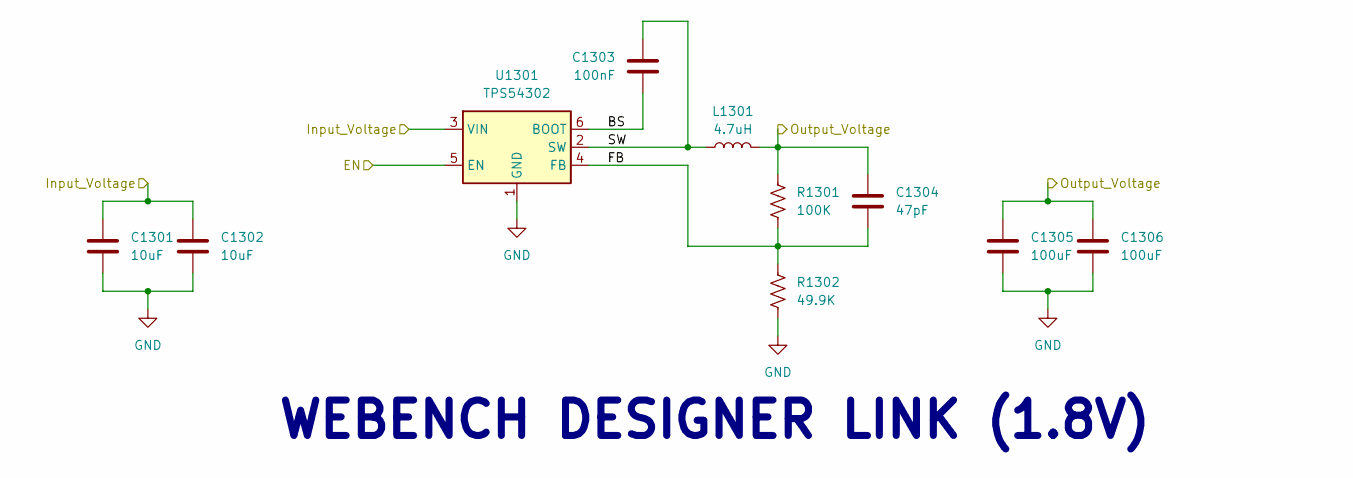
[picture p67: schematic 1V8_BUCK.kicad_sch]

Parts:
C1301, C1302: 10uF; C_0805_2012Metric
C1303: 100nF; C_0402_1005Metric
C1304: 47pF; C_0402_1005Metric
C1305, C1306: 100uF; C_0805_2012Metric
L1301: 4.7uH; L_6.3x6.3_H3
R1301: 100K; R_0402_1005Metric
R1302: 49.9K; R_0402_1005Metric
U1301: TPS54302; SOT-23-6

Connections:
/Power/USB_1V8/BS: C1303.1, U1301.6 (BOOT)
/Power/USB_1V8/FB: C1304.2, R1301.2, R1302.1, U1301.4 (FB)
/Power/USB_1V8/SW: C1303.2, L1301.1, U1301.2 (SW)
/Power/USB_1V8_EN: U1301.5 (EN); also elsewhere on the board
DC_MAIN: C1301.1, C1302.1, U1301.3 (VIN); also elsewhere on the board
GND: C1301.2, C1302.2, C1305.2, C1306.2, R1302.2, U1301.1 (GND); also elsewhere on the board
USB_1V8_PRE: C1304.1, C1305.1, C1306.1, L1301.2, R1301.1; also elsewhere on the board

Parts of its further copies:
C1701, C1702: 10uF; C_0805_2012Metric
C1703: 100nF; C_0402_1005Metric
C1704: 47pF; C_0402_1005Metric
C1705, C1706: 100uF; C_0805_2012Metric
L1701: 4.7uH; L_6.3x6.3_H3
R1701: 100K; R_0402_1005Metric
R1702: 49.9K; R_0402_1005Metric
U1701: TPS54302; SOT-23-6

Connections of its further copies:
/Power/SOM_HPA_1V8/BS: C1703.1, U1701.6 (BOOT)
/Power/SOM_HPA_1V8/FB: C1704.2, R1701.2, R1702.1, U1701.4 (FB)
/Power/SOM_HPA_1V8/SW: C1703.2, L1701.1, U1701.2 (SW)
/Power/SOM_PL_PWR_EN: U1701.5 (EN); also elsewhere on the board
DC_MAIN: C1701.1, C1702.1, U1701.3 (VIN); also elsewhere on the board
GND: C1701.2, C1702.2, C1705.2, C1706.2, R1702.2, U1701.1 (GND); also elsewhere on the board
VDD_HPA_PRE: C1704.1, C1705.1, C1706.1, L1701.2, R1701.1; also elsewhere on the board

Notes on the sheet:
WEBENCH DESIGNER LINK (1.8V)
