yusufElnady/Medical-Imager/MedicalImager.kicad_pcb

## KiCad design MedicalImager.kicad_pcb (continued)

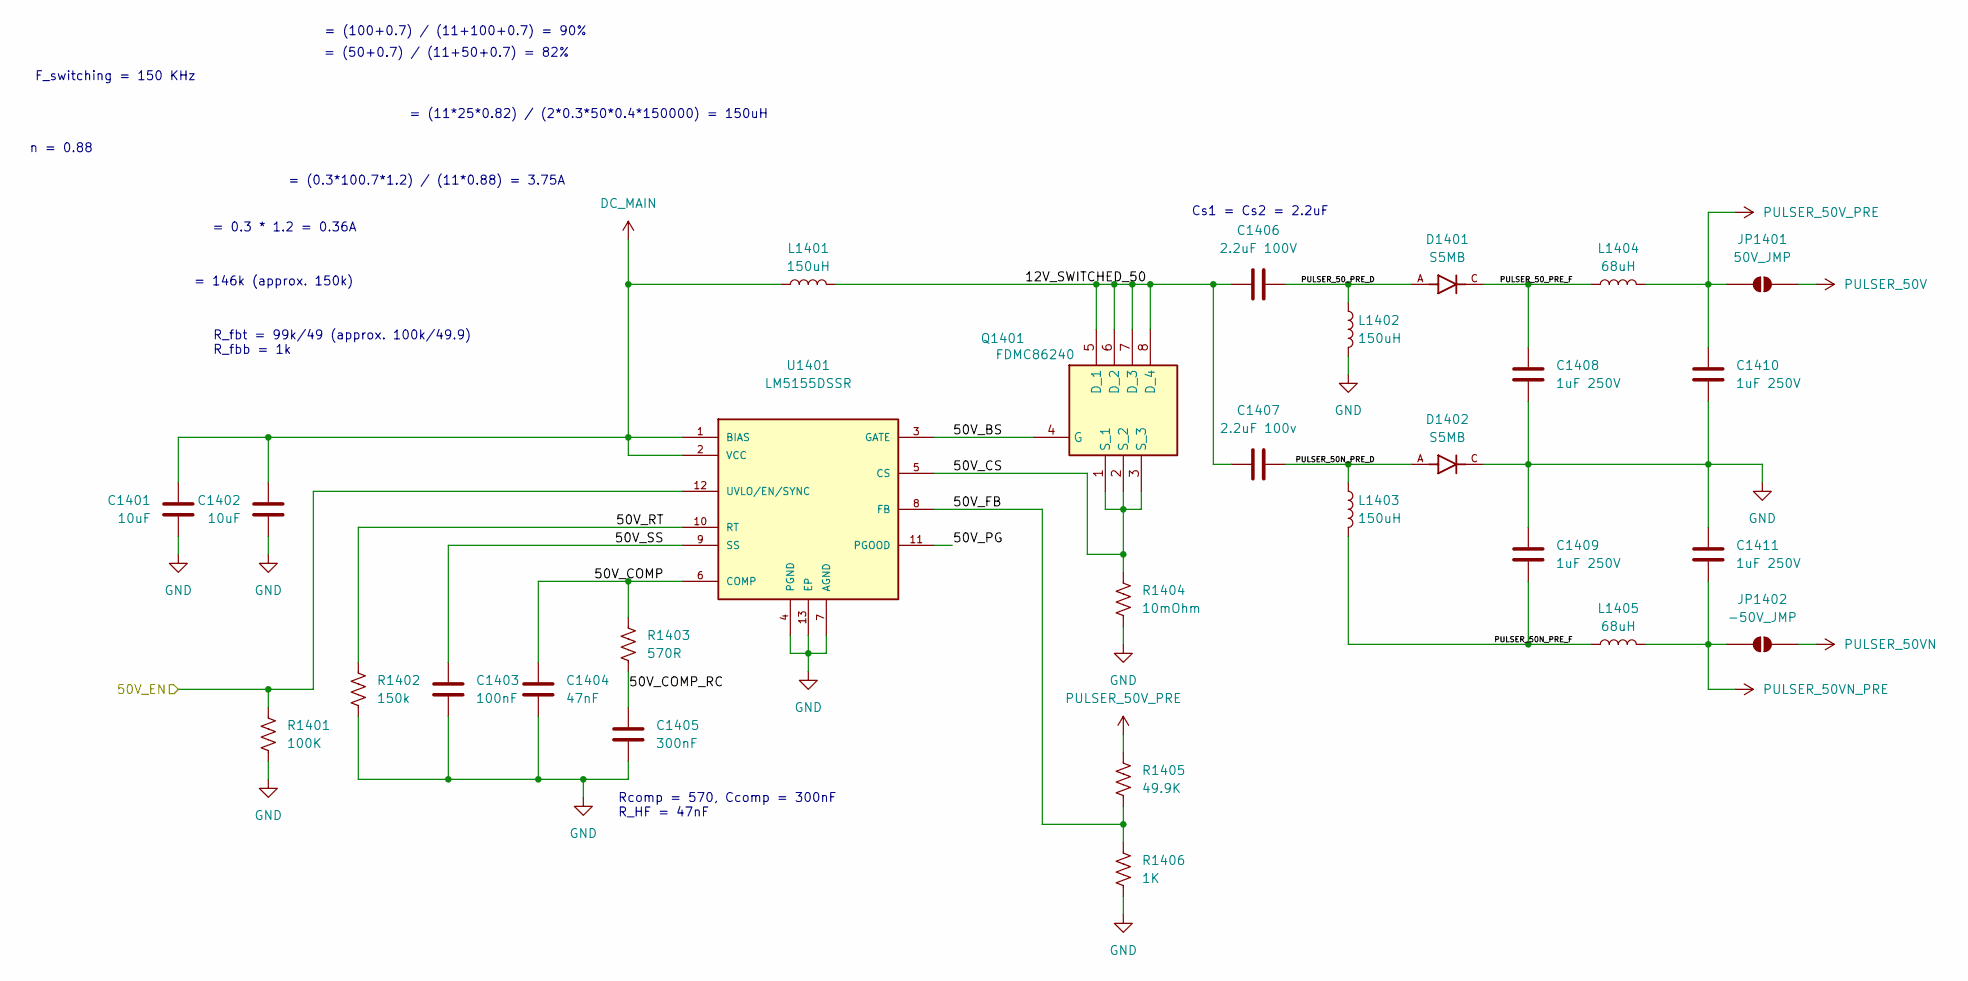
[picture p68: schematic 50V_Supply.kicad_sch]

Parts:
C1401, C1402: 10uF; C_0805_2012Metric
C1403: 100nF; C_0402_1005Metric
C1404: 47nF; C_0402_1005Metric
C1405: 300nF; C_0402_1005Metric
C1406: 2.2uF 100V; C_0805_2012Metric
C1407: 2.2uF 100v; C_0805_2012Metric
C1408, C1409, C1410, C1411: 1uF 250V; C_1812_4532Metric
D1401, D1402: S5MB; DIOM4336X265N; PARTREV K2102
JP1401: 50V_JMP; SolderJumper-2_P1.3mm_Open_TrianglePad1.0x1.5mm
JP1402: -50V_JMP; SolderJumper-2_P1.3mm_Open_TrianglePad1.0x1.5mm
L1401: 150uH; L_SXN_SMDRI127
L1402, L1403: 150uH; L_Cenker_CKCS4018
L1404, L1405: 68uH; L_1210_3225Metric
Q1401: FDMC86240; FDMC86139P; Manufacturer_Part_Number FDMC86240; Mouser Part Number 512-FDMC86240
R1401: 100K; R_0402_1005Metric
R1402: 150k; R_0402_1005Metric
R1403: 570R; R_0402_1005Metric
R1404: 10mOhm; R_0603_1608Metric
R1405: 49.9K; R_0402_1005Metric
R1406: 1K; R_0402_1005Metric
U1401: LM5155DSSR; IC_LM5155DSSR; PARTREV E

Connections:
/Power/50V_EN: R1401.1, U1401.12 (UVLO/EN/SYNC); also elsewhere on the board
/Power/50V_SUPPLY/12V_SWITCHED_50: C1406.1, C1407.1, L1401.2, Q1401.5 (D_1), Q1401.6 (D_2), Q1401.7 (D_3), Q1401.8 (D_4)
/Power/50V_SUPPLY/50V_BS: Q1401.4 (G), U1401.3 (GATE)
/Power/50V_SUPPLY/50V_COMP: C1404.1, R1403.1, U1401.6 (COMP)
/Power/50V_SUPPLY/50V_COMP_RC: C1405.1, R1403.2
/Power/50V_SUPPLY/50V_CS: Q1401.1 (S_1), Q1401.2 (S_2), Q1401.3 (S_3), R1404.2, U1401.5 (CS)
/Power/50V_SUPPLY/50V_FB: R1405.2, R1406.1, U1401.8 (FB)
/Power/50V_SUPPLY/50V_PG: U1401.11 (PGOOD)
/Power/50V_SUPPLY/50V_RT: R1402.1, U1401.10 (RT)
/Power/50V_SUPPLY/50V_SS: C1403.2, U1401.9 (SS)
/Power/50V_SUPPLY/PULSER_50N_PRE_D: C1407.2, D1402.A, L1403.1
/Power/50V_SUPPLY/PULSER_50N_PRE_F: C1409.2, L1403.2, L1405.1
/Power/50V_SUPPLY/PULSER_50_PRE_D: C1406.2, D1401.A, L1402.1
/Power/50V_SUPPLY/PULSER_50_PRE_F: C1408.1, D1401.C, L1404.1
DC_MAIN: C1401.1, C1402.1, L1401.1, U1401.1 (BIAS), U1401.2 (VCC); also elsewhere on the board
GND: C1401.2, C1402.2, C1403.1, C1404.2, C1405.2, C1408.2, C1409.1, C1410.2, C1411.1, D1402.C, L1402.2, R1401.2, R1402.2, R1404.1, R1406.2, U1401.4 (PGND), U1401.7 (AGND), U1401.13 (EP); also elsewhere on the board
PULSER_50V: JP1401.2 (B); also elsewhere on the board
PULSER_50VN: JP1402.2 (B); also elsewhere on the board
PULSER_50VN_PRE: C1411.2, JP1402.1 (A), L1405.2
PULSER_50V_PRE: C1410.1, JP1401.1 (A), L1404.2, R1405.1

Notes on the sheet:
= (100+0.7) / (11+100+0.7) = 90%
F_switching = 150 KHz
R_fbt = 99k/49 (approx. 100k/49.9) R_fbb = 1k
= 146k (approx. 150k)
= 0.3 * 1.2 = 0.36A
Cs1 = Cs2 = 2.2uF
= (0.3*100.7*1.2) / (11*0.88) = 3.75A
= (50+0.7) / (11+50+0.7) = 82%
= (11*25*0.82) / (2*0.3*50*0.4*150000) = 150uH
n = 0.88
Rcomp = 570, Ccomp = 300nF R_HF = 47nF

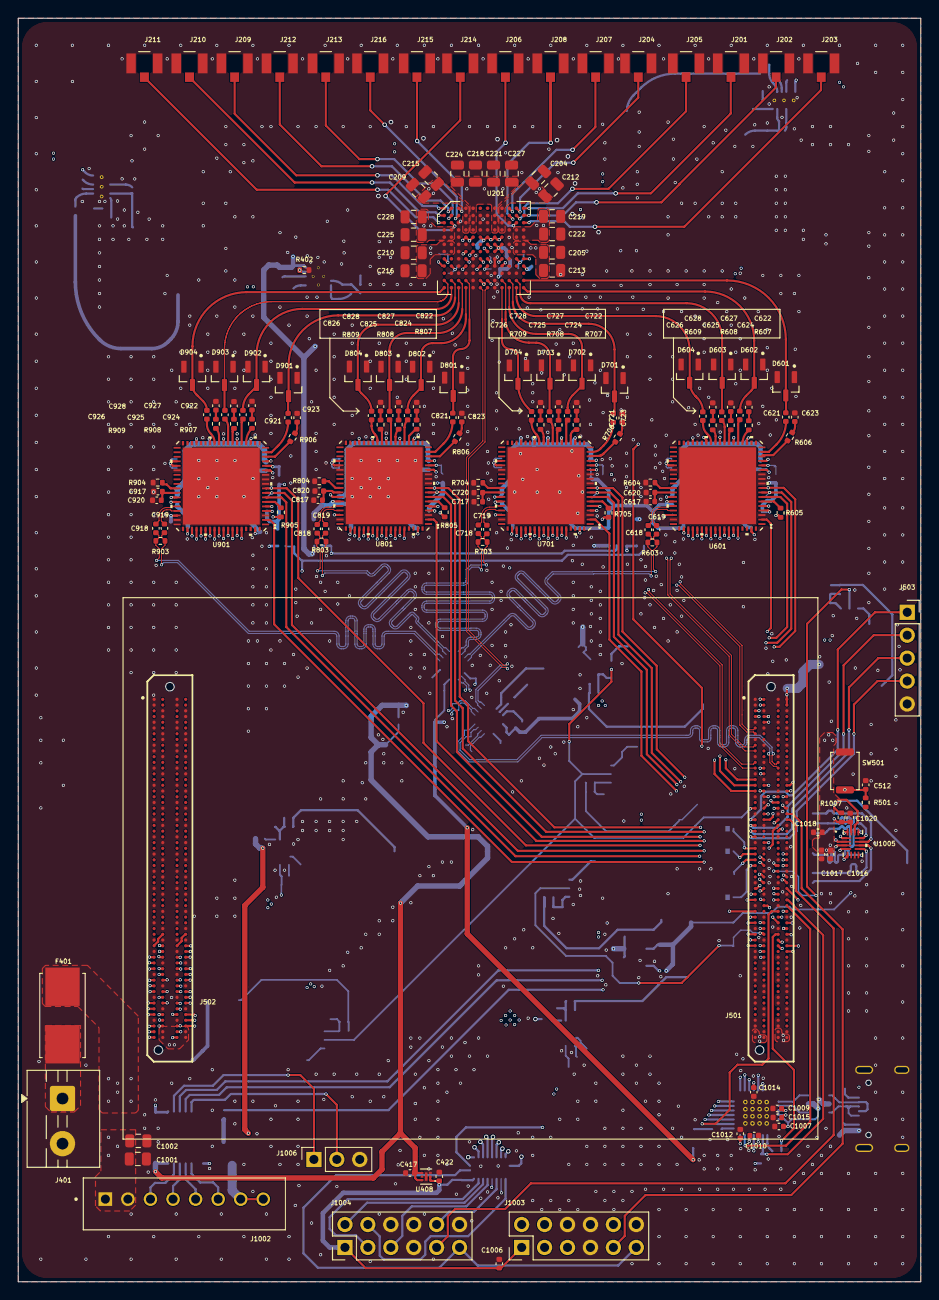
[picture p69: board MedicalImager.kicad_pcb from above]

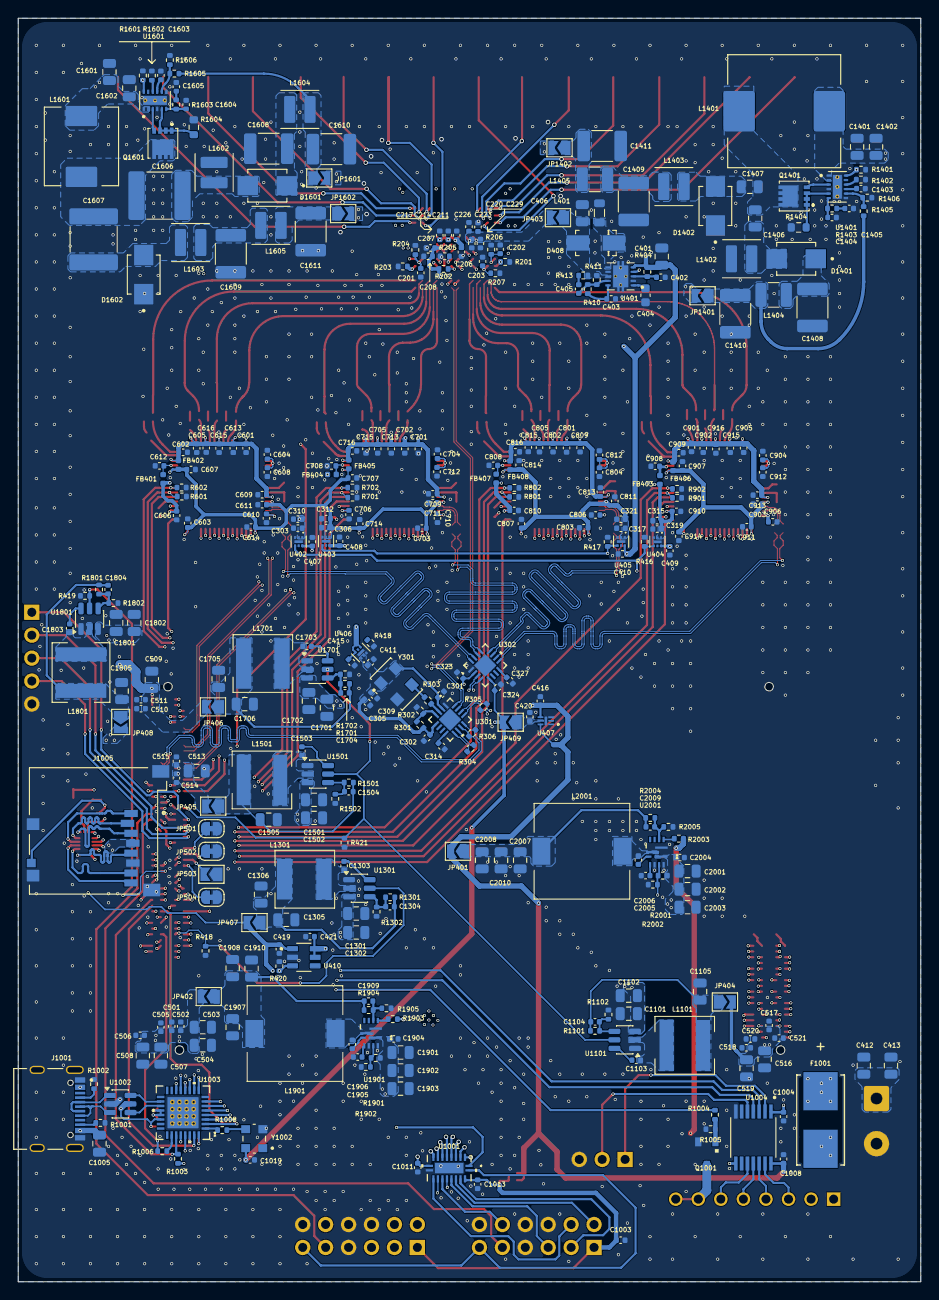
[picture p70: board MedicalImager.kicad_pcb from below]

Board: 6 copper layers, 100.0 x 140.0 mm, 517 parts (357 on the bottom side), 396 nets.

Other parts of the board:
R418#2: 10K; R_0402_1005Metric

Their connections:
GND: R418#2.2; also elsewhere on the board
