yusufElnady/Medical-Imager/(commit log)

2026-09-28 first upload
    [Main.SchDoc, MedicalImager.PrjPcb, MedicalImager.kicad_pcb, MedicalImager.kicad_sch, Power.SchDoc, Power.kicad_sch, RX.SchDoc, RX.kicad_sch]
2026-09-28 finished SOM 5V power, migrated altium stuff, finished pin study, added USB PHY (revise HS capability)
    [Interface.kicad_sch, MedicalImager.kicad_sch, Power.kicad_sch, RX.kicad_sch, RX_LANE.kicad_sch, SOM.kicad_sch, TX.kicad_sch]
2026-09-29 added ADC clock fanout, added 3A buck
    [Power.kicad_sch, RX.kicad_sch, RX_LANE.kicad_sch]
2026-10-04 finished HV rails (revise, ai), added LDO instances, ready to bind & supply
    [1V8_BUCK.kicad_sch, 3V3_BUCK.kicad_sch, MedicalImager.kicad_sch, Power.kicad_sch, RX.kicad_sch, RX_LANE.kicad_sch]
2026-10-06 added USB (needs revision), fixed medium voltage rail
    [1V8_BUCK.kicad_sch, Interface.kicad_sch, MedicalImager.kicad_sch, Power.kicad_sch, SOM.kicad_sch, TX.kicad_sch]
2026-10-11 almost finished, phew! just dd +/- 5v rails, connect the SDIO & power enable pins and figure out the rest of the clocking chain
2026-10-13 DONE! hust needs a final revision, checking termination throughout the circuit and verifying the signal chain
2026-10-13 added the new schematic
2026-10-14 HDMI was requested so add it and give the signal chain a final revision
2026-10-25 started layout, finished 90% of individual section placement, need to finish remaining and integrate together in PCB and apply schematic edits before
2026-10-27 finished preliminary placement, will definietly be changed when routing don't forget to apply comments in first page and calculate trace impedance for all traces & make AI revise schematic
2026-10-31 finished routing parallel lanes & most differentials, log lengths tunes for each group and FINISH NOTES IN THE FIRST SCHEMATIC SHEET
2026-11-02 70% routing done, needs going through all trace widths to match to impedance profiles, finished most comments in schematic
2026-11-03 finish input power circuit (protection & decaps), change diode, complete SD card routing and final touches, rectify impedances
2026-11-04 finished reported schematic edits, update PCB and continue routing
2026-11-13 finished polishing the silkscreen layer, revision and BOM are pending
